redfoxxxi/ET_MASTER_CODE/Vulpra File/vulpra/IMG_4837.jpg

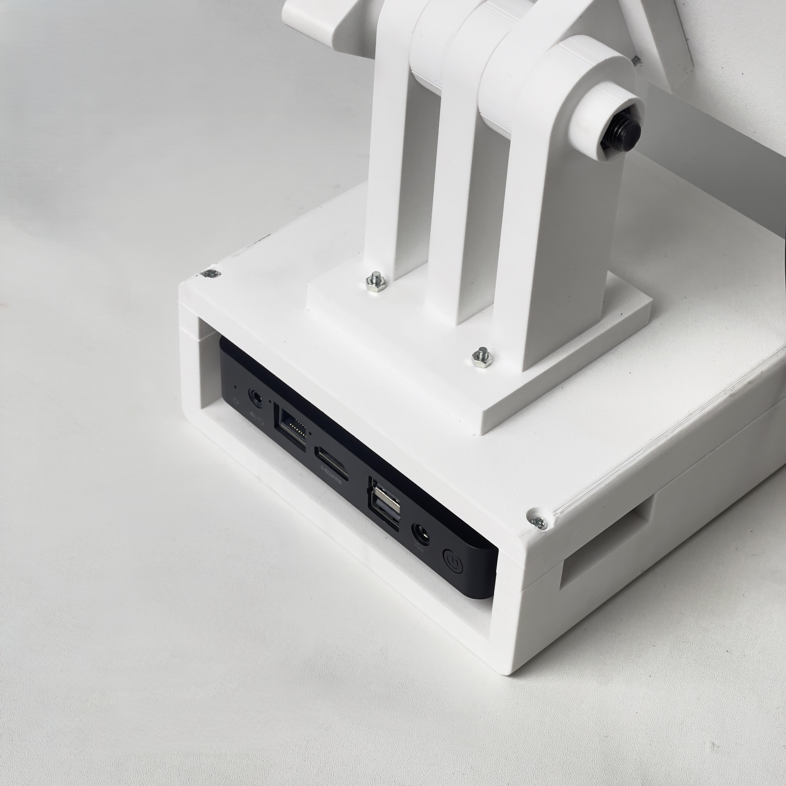
Vulpra File/vulpra/IMG_4837.jpg
