redfoxxxi/ET_MASTER_CODE/Vulpra File/vulpra/IMG_4832.jpg

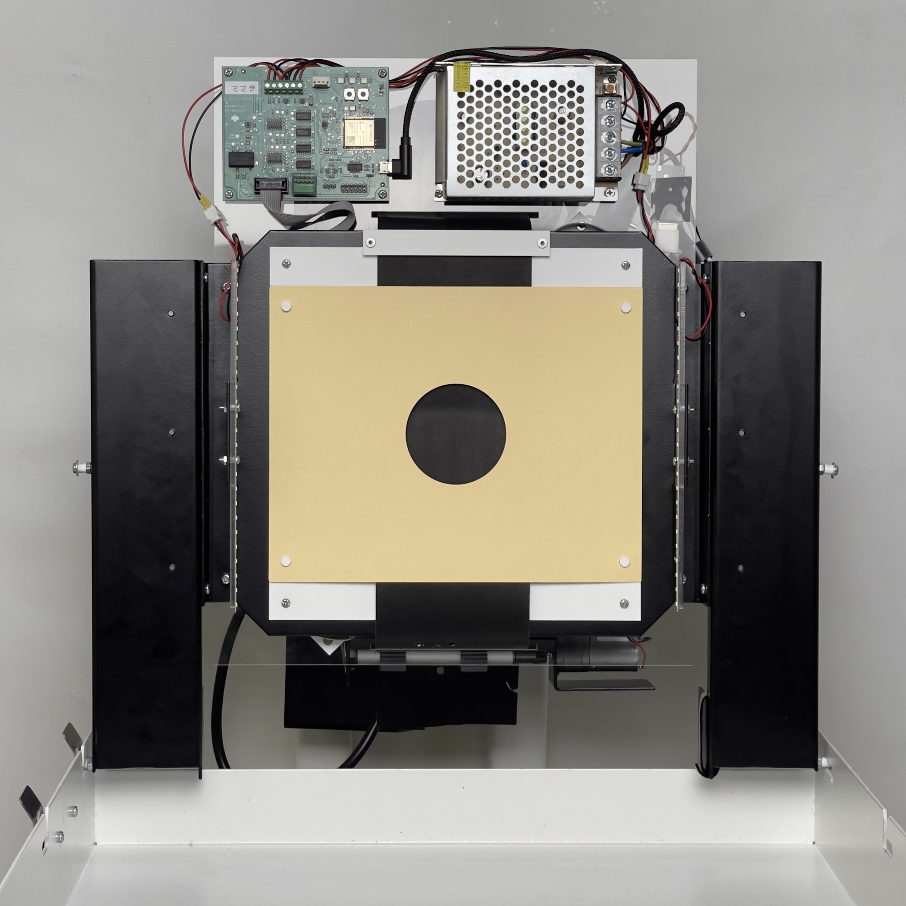
Vulpra File/vulpra/IMG_4832.jpg
