redfoxxxi/ET_MASTER_CODE/README.md

This is the documentation of Vulpra Electronic Target for 10m air pistol and air rifle.
