redfoxxxi/ET_MASTER_CODE/Additional unfinished Project/electronic_target_system_simulation_combined_with_multi_color_heatmap_confined_to_intersecting_grid.html

# Electronic Target System Simulation

Sensors per Side:

Triangle Side Length (cm):

Apply Changes

Targeted Resolution (mm):

Calculate Recommendation

Total Laser Lines:

Total Intersection Points:

Largest Cell Area (Overall Grid): cm²

Smallest Cell Area (Overall Grid): cm²

Largest Grid Tightness (Overall Grid - Max Adj. Dist.): cm

Smallest Grid Tightness (Overall Grid - Min Adj. Dist.): cm

Target Area Grid Tightness (within 9-ring):

Max Distance: mm

Min Distance: mm

Recommended Sensors per Side: N/A

Achievable Resolution (Current Settings, in 9-ring): N/A mm

Select Adjacent Segment (Overall Grid):

✨ Get Accuracy Improvement Suggestions

Generating suggestions...

Suggestions will appear here.

## Grid Resolution Heatmap (by Cell Area)

Color indicates local grid resolution (cell area):

High Resolution (Red) Low Resolution (Blue)
