redfoxxxi/ET_MASTER_CODE/ET MASTER/ET STAND/NOTE TAMBAHAN.txt

Untuk stand, pakai besi hollow saja produksinya. semua bagian dihubungkan dengan cara di Las. (sesuai yang ada di pdf) jika ada pertanyaan, boleh contact saja langsung.

untuk warna dari stand pakai warna PUTIH semua
