redfoxxxi/ET_MASTER_CODE/ENGINEERING PORTFOLIO German.pdf

# Engineering Portfolio

Josiah Christoff Susanto

Elektromechanische Systeme • CAD-Design • Embedded Electronics • Produktentwicklung

Aachen, Deutschland | +49 1512 9710619 | josiahsusanto@gmail.com

Projekt :

10m Elektronisches Zielsystem & 10m Laufscheibenanlage

2023 – 2026


# PROJEKTÜBERSICHT

## 10m Elektronisches Zielsystem

Problemstellung

Traditionelle Zielsysteme sind teuer und lokal schwer erhältlich.

Zielsetzung

Entwicklung eines kommerziell nutzbaren elektronischen Zielsystems für den Schießsport, das kostengünstig ist und lokal verfügbar gemacht werden kann.

Projektumfang

- Mechanische Konstruktion
- Elektronische Integration
- Embedded-System-Entwicklung
- Montageprozess
- Vorbereitung der Fertigung
- Produktstandardisierung

Meine Rolle

Verantwortlichkeiten :

- Systemarchitektur
- Mechanische Konstruktion
- Elektronische Integration
- Logikdesign
- Montage
- Testung
- Dokumentation
- Budgetplanung
- Kundenkommunikation

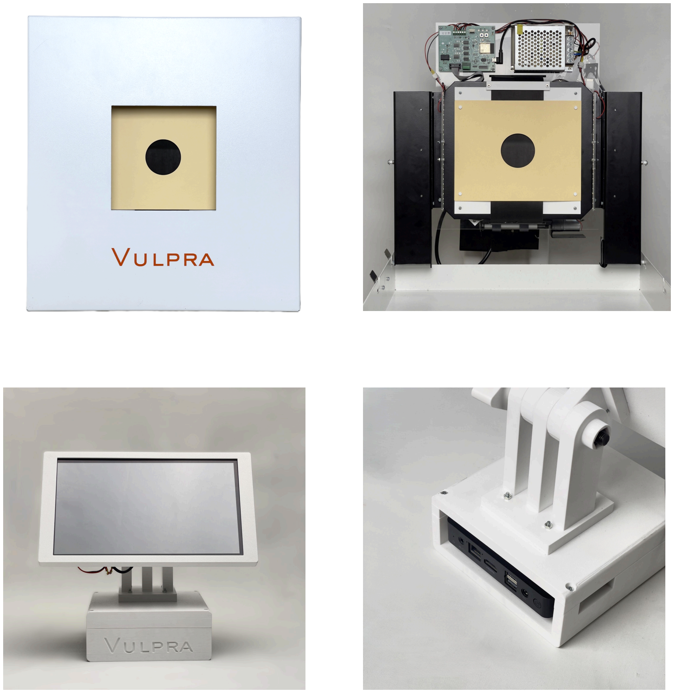
[picture p12: page 3]

# CAD DESIGN

## Mechanische Konstruktion

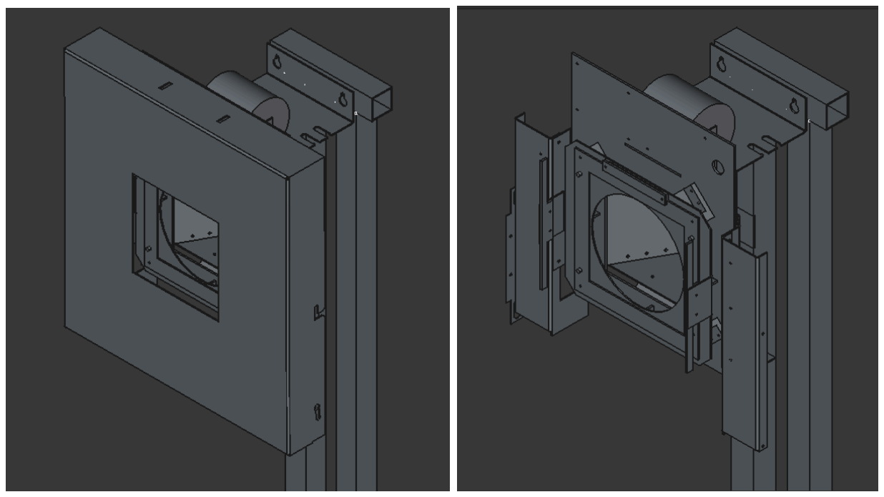
[picture p13: figure]

Überblick über das vollständige mechanische Design


Überblick über die von mir entwickelten Komponenten

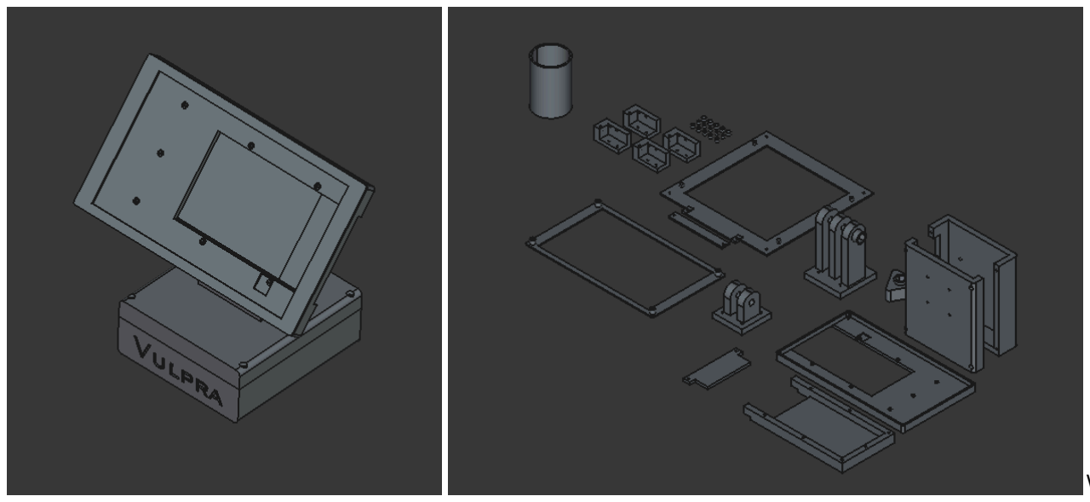
[picture p14: figure]

\

Ü

b

e

r

blic

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
timie

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
dlic

h

k

eit

## Entwicklungsprozess

Herausforderung

Entwicklung eines zuverlässigen Zielsystems mit effizientem mechanischem Design.

Entwicklung

Version 1


Problem: Das Design war zu komplex und nicht effizient genug. Dadurch waren Gewicht und Anzahl der Bauteile höher, und die Montage war schwieriger.

Version 2 (Finales Produkt)


Durch gezielte Verbesserungen und effizienteres Design konnte ich die Anzahl der Bauteile und das Gewicht reduzieren sowie die Montage vereinfachen, ohne die Funktionalität zu beeinträchtigen.

# Fertigung & Dokumentation

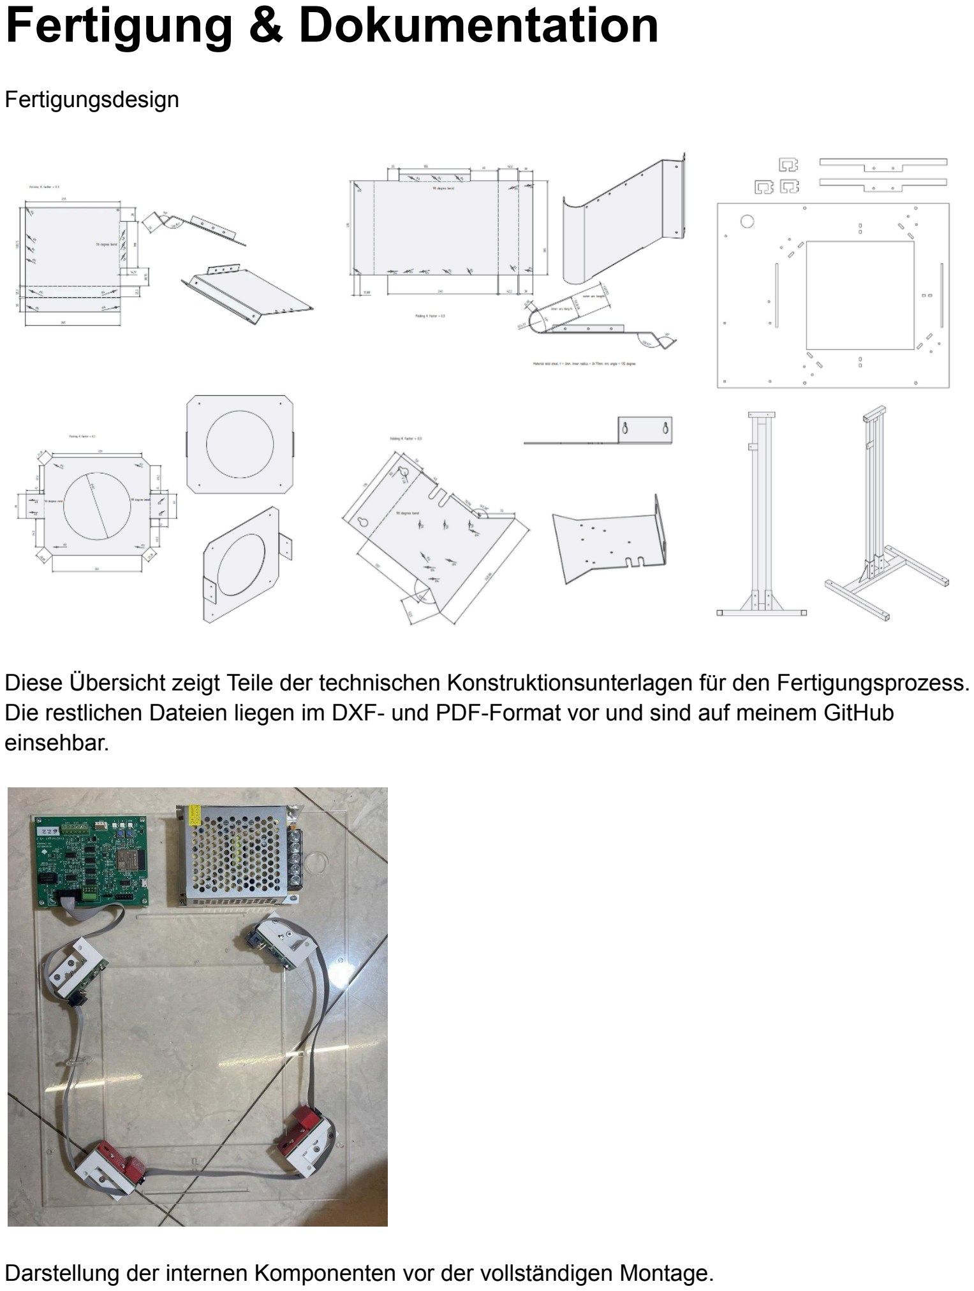
[picture p15: page 7]

Fertigungsdesign

Diese Übersicht zeigt Teile der technischen Konstruktionsunterlagen für den Fertigungsprozess. Die restlichen Dateien liegen im DXF- und PDF-Format vor und sind auf meinem GitHub einsehbar.

Darstellung der internen Komponenten vor der vollständigen Montage.

## 10m Laufscheibenanlage

Die Projektdokumentation finden Sie unter diesem Google Drive Link : Running target portfolio (https://drive.google.com/drive/folders/1omEWJYa4WoZRgBuMUYweKJWNJG2Rp4BL?usp=sharing)

## Danksagung

Für weitere Informationen, CAD-Dateien und technische Dokumentation:

Email: josiahsusanto@gmail.com

Telefon: +49 1512 9710619

Portfolio Repository: https://github.com/redfoxxxi/ET_MASTER_CODE
