redfoxxxi/ET_MASTER_CODE/ET MASTER/Metal Body V2/Part Design/metal body-Assembly.step

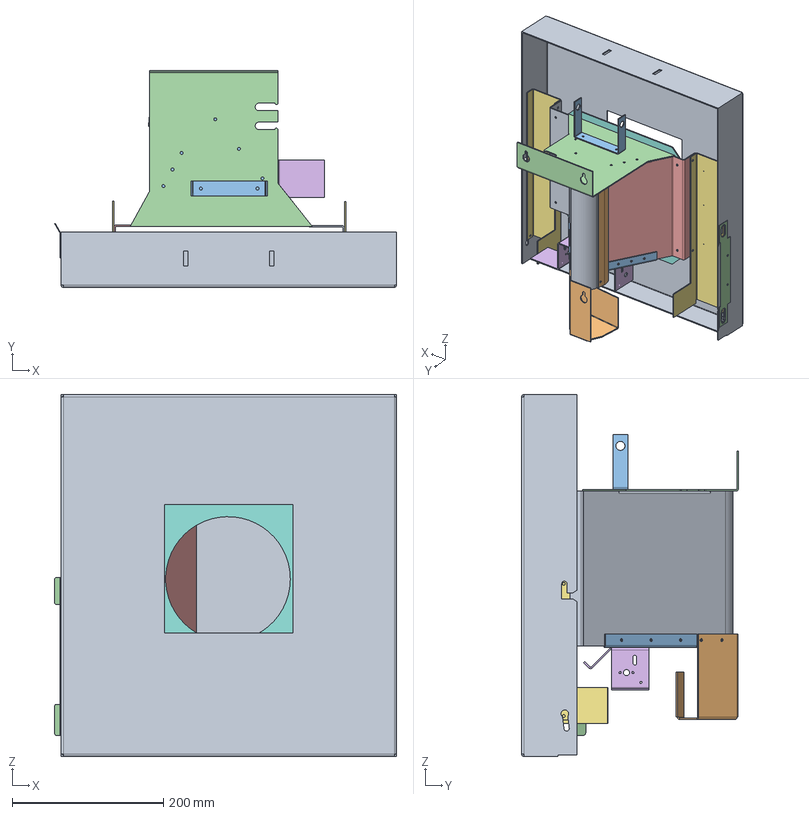
[picture p16: CAD file, 2026-06-16]
ET MASTER/Metal Body V2/Part Design/metal body-Assembly.step
452.6 x 286.8 x 479.0 mm
FRONT PLATE
COLLECTOR
TRAP FOUNDATION
UPPER TRAP
SIDE PLATE A
MOTOR MOUNT
PLATE HOLDER001
PROTECTOR PLATE
SIDE PLATE B
SIDE B CURL
Roll Holder
PLATE HOLDER (Mirror #1)
PLATE CLAMP
