redfoxxxi/ET_MASTER_CODE/ET MASTER/Airsoft design/Airsoft Metal Frame.FCStd

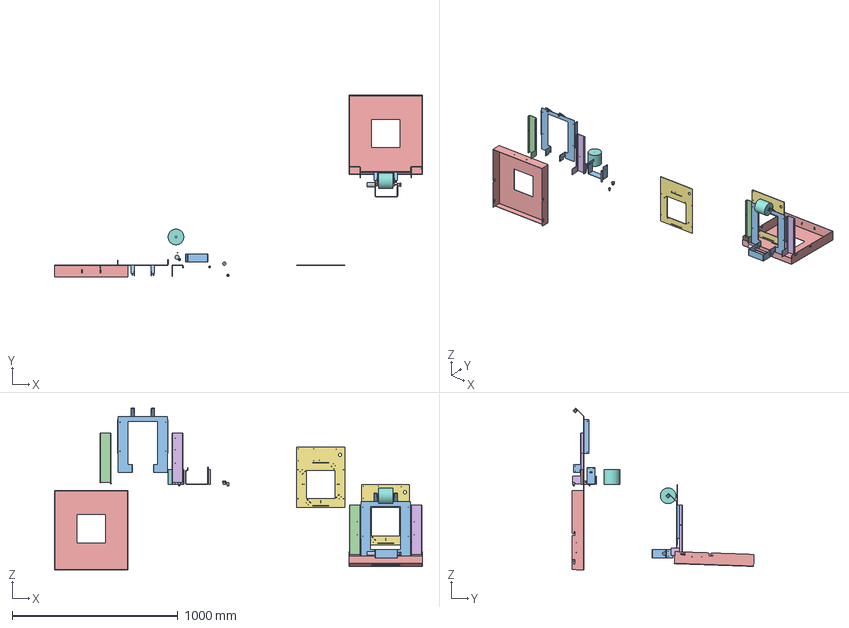
[picture p18: CAD file, 2026-06-16]
ET MASTER/Airsoft design/Airsoft Metal Frame.FCStd
2220.7 x 1099.4 x 976.7 mm
roll spring knob x 2
Support Roll Adapter x 2
Back Plate x 2
PLATE HOLDER001 x 2
FRONT PLATE002 x 2
PLATE HOLDER (Mirror #1) x 2
MAIN FRAME x 2
Paper roll x 2
Motor sim object x 2
Main Roll Adapter x 2
Motor Roll Mounting Plate x 2
m4 screw x 2
Roll Adapter x 2
