redfoxxxi/ET_MASTER_CODE/ET MASTER/ET ACRYLIC BODY v2/acrylic body.FCStd

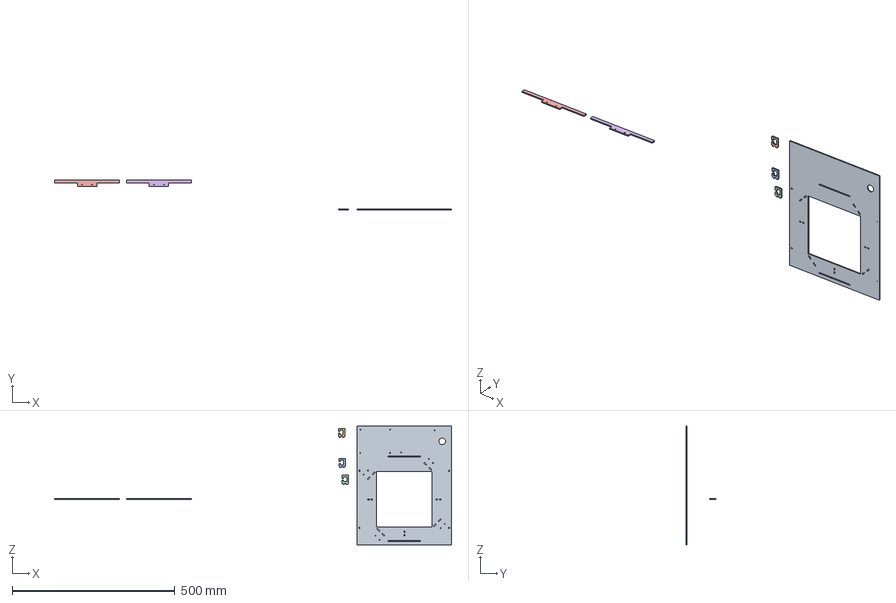
[picture p19: CAD file, 2026-06-16]
ET MASTER/ET ACRYLIC BODY v2/acrylic body.FCStd
1218.8 x 93.0 x 365.0 mm
MAIN FRAME
CABLE HOLDER 1
CABLE HOLDER 002
CABLE HOLDER 003
LED MOUNT 2
LED MOUNT
