redfoxxxi/ET_MASTER_CODE/ET MASTER/ET ACRYLIC BODY v2/laser cut file/acrylic body.dxf

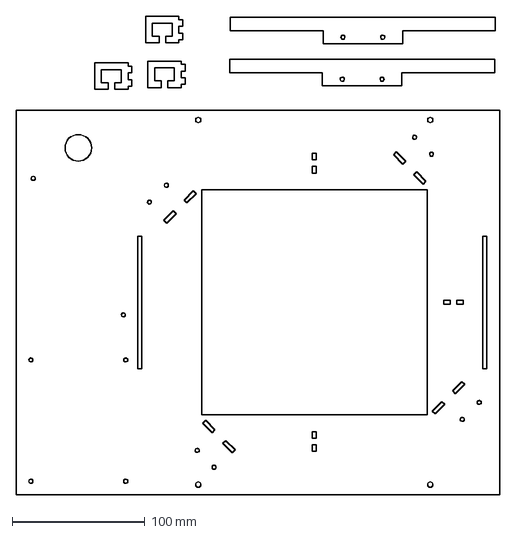
[picture p20: CAD file, 2026-06-16]
ET MASTER/ET ACRYLIC BODY v2/laser cut file/acrylic body.dxf
365.0 x 360.6 mm
