redfoxxxi/ET_MASTER_CODE/ET MASTER/ET MASTER/ET Master Design.FCStd

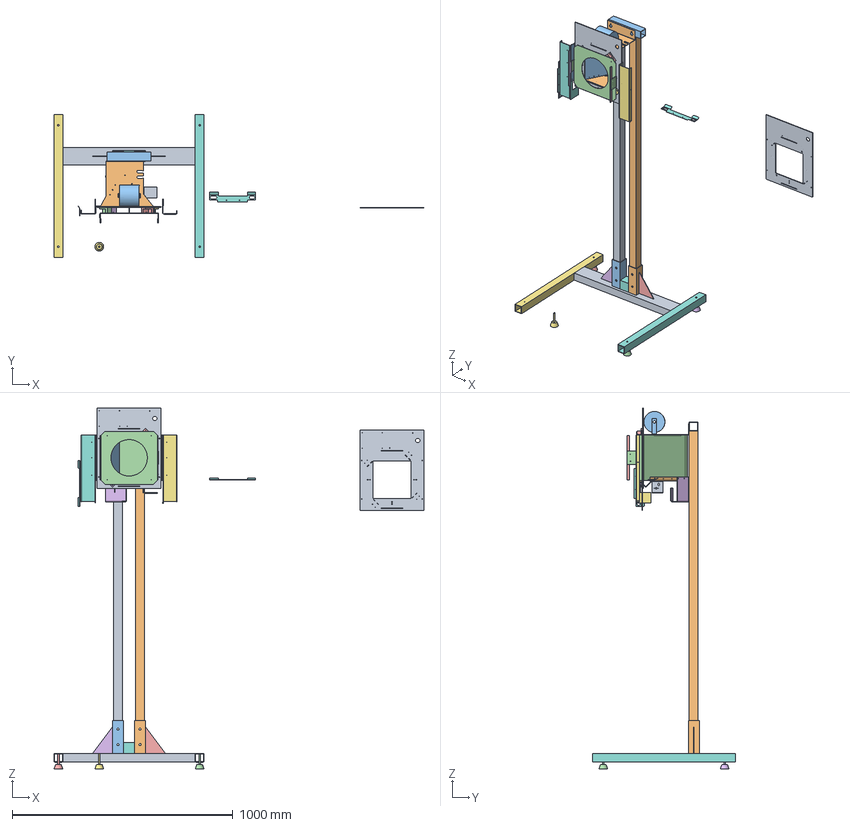
[picture p21: CAD file, 2026-06-16]
ET MASTER/ET MASTER/ET Master Design.FCStd
1676.8 x 650.1 x 1634.6 mm
MAIN FRAME x 2
TRAP FOUNDATION
SIDE PLATE A
SIDE PLATE B
SIDE B CURL
COLLECTOR
PLATE HOLDER001
PLATE HOLDER (Mirror #1)
MOTOR MOUNT
UPPER TRAP
Roll Holder
Sensor mount
Sensor mount002
Sensor mount003
Sensor mount004
CABLE HOLDER 1
CABLE HOLDER 003
CABLE HOLDER 002
Paper roll
PROTECTOR PLATE
LED MOUNT 2
LED MOUNT
sub leg
sub leg001
main leg
leg foundation
leg foundation 1
lower support
Support
Support 001
upper support
spacer
stand 1
stand 2
upper holder
rubber stand002
rubber stand003
rubber stand004
rubber stand
PLATE CLAMP x 2
