redfoxxxi/ET_MASTER_CODE/ET MASTER/ET MONITOR/ET MONITOR.step

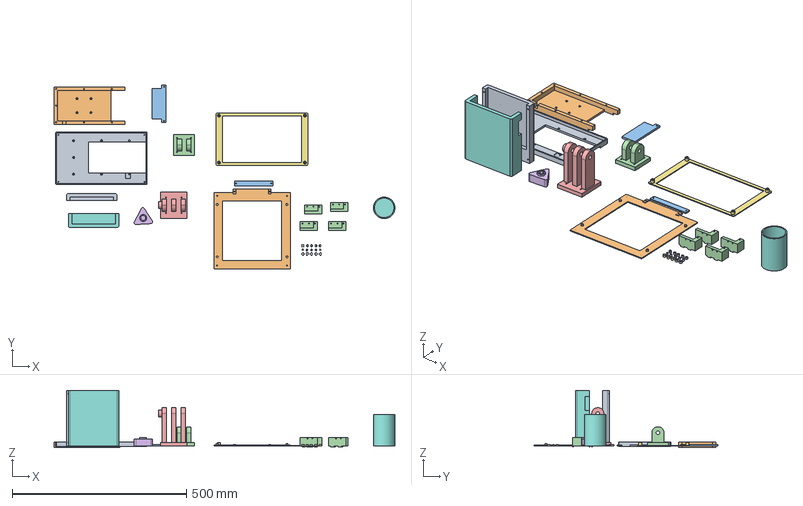
[picture p22: CAD file, 2026-06-16]
ET MASTER/ET MONITOR/ET MONITOR.step
979.1 x 528.2 x 165.0 mm
Upper foundation
Paper holder
PAPER CAP
Sensor mount
Sensor mount002
Sensor mount003
Sensor mount004
plate mount pulley
m3 pulley
m6 pulley
Bottom Foundation
BASE
monitor cap
conection cap
monitor joint
stand joint
clamp joint
screen cap
plate mount pulley001
plate mount pulley002
plate mount pulley003
plate mount pulley004
m3 pulley001
m3 pulley002
m3 pulley003
m3 pulley004
m6 pulley001
m6 pulley002
m6 pulley003
m6 pulley004
