redfoxxxi/ET_MASTER_CODE/ET MASTER/ET STAND/ET STAND.FCStd

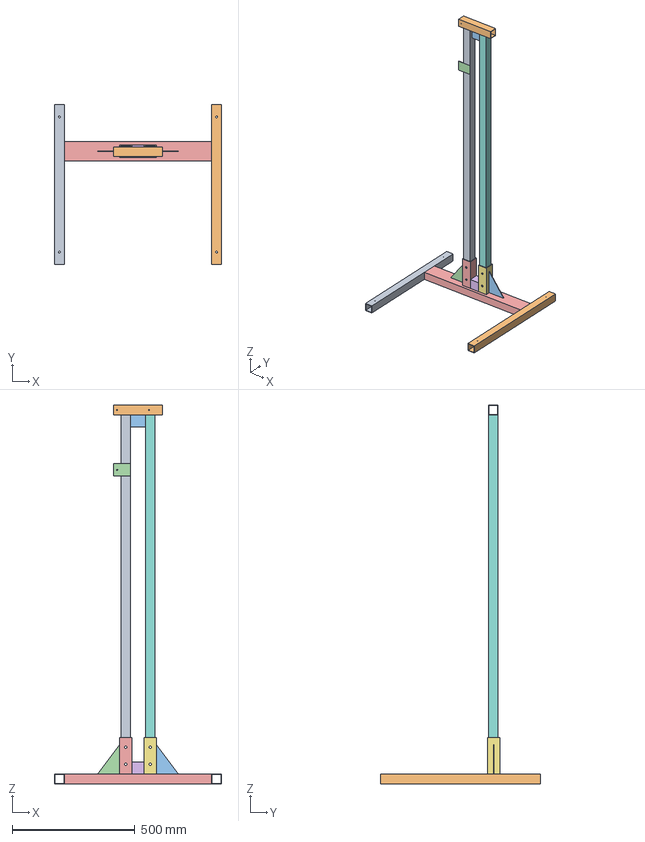
[picture p23: CAD file, 2026-06-16]
ET MASTER/ET STAND/ET STAND.FCStd
680.0 x 650.0 x 1542.0 mm
sub leg 1
sub leg 2
Support 1
Support 2
leg foundation 1
spacer
leg foundation 2
stand 2
stand 1
upper holder
upper support
lower support
main leg
