redfoxxxi/ET_MASTER_CODE/ET MASTER/Metal Body V2/Part Design/COLLECTOR/colector.dxf

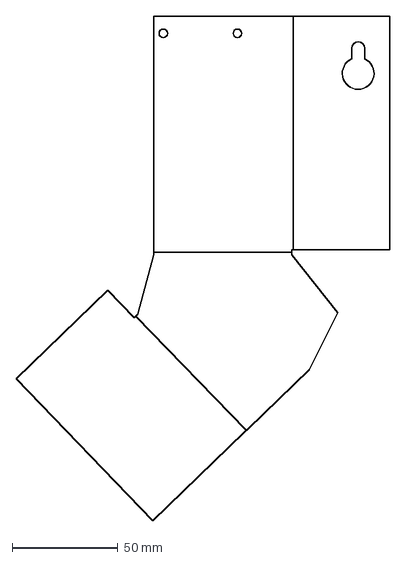
[picture p24: CAD file, 2026-06-16]
ET MASTER/Metal Body V2/Part Design/COLLECTOR/colector.dxf
176.4 x 237.9 mm
