redfoxxxi/ET_MASTER_CODE/ET MASTER/Metal Body V2/Part Design/FRONT PLATE/front plate.dxf

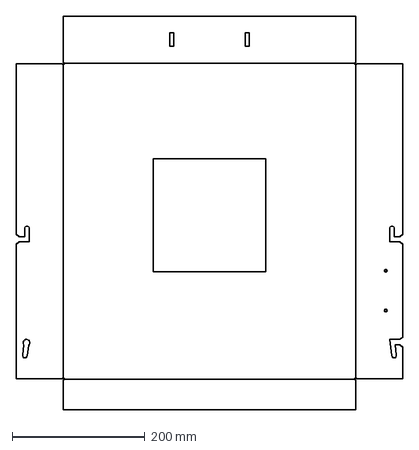
[picture p25: CAD file, 2026-06-16]
ET MASTER/Metal Body V2/Part Design/FRONT PLATE/front plate.dxf
583.0 x 593.0 mm
