redfoxxxi/ET_MASTER_CODE/ET MASTER/Metal Body V2/Part Design/MOTOR MOUNT/motor mount.dxf

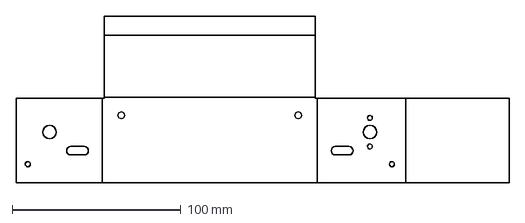
[picture p26: CAD file, 2026-06-16]
ET MASTER/Metal Body V2/Part Design/MOTOR MOUNT/motor mount.dxf
292.5 x 98.8 mm
