redfoxxxi/ET_MASTER_CODE/ET MASTER/Metal Body V2/Part Design/PLATE CLAMP/plate clamp.dxf

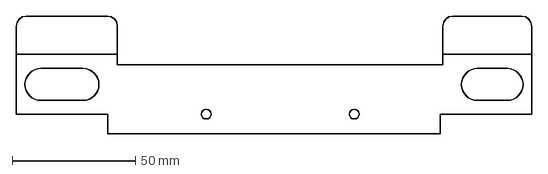
[picture p27: CAD file, 2026-06-16]
ET MASTER/Metal Body V2/Part Design/PLATE CLAMP/plate clamp.dxf
209.0 x 47.7 mm
