redfoxxxi/ET_MASTER_CODE/ET MASTER/Metal Body V2/Part Design/PLATE HOLDER (Mirror)/plate holder (mirror).dxf

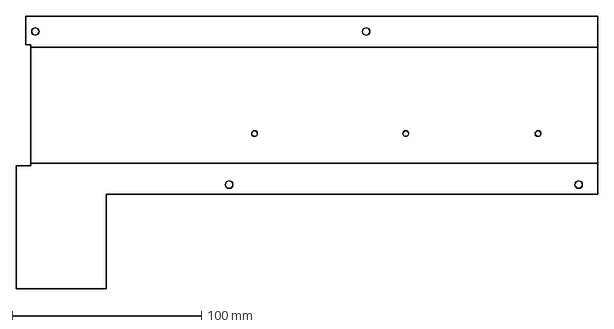
[picture p28: CAD file, 2026-06-16]
ET MASTER/Metal Body V2/Part Design/PLATE HOLDER (Mirror)/plate holder (mirror).dxf
307.5 x 144.0 mm
