redfoxxxi/ET_MASTER_CODE/ET MASTER/Metal Body V2/Part Design/PLATE HOLDER/plate holder.dxf

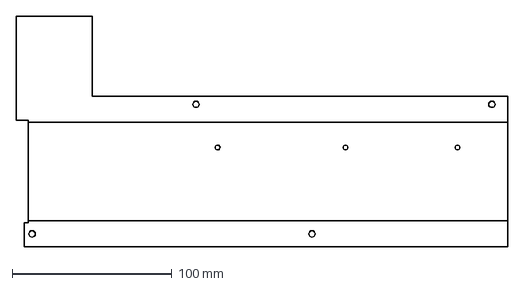
[picture p29: CAD file, 2026-06-16]
ET MASTER/Metal Body V2/Part Design/PLATE HOLDER/plate holder.dxf
307.5 x 144.0 mm
