redfoxxxi/ET_MASTER_CODE/ET MASTER/Metal Body V2/Part Design/PROTECTOR PLATE/protector plate.dxf

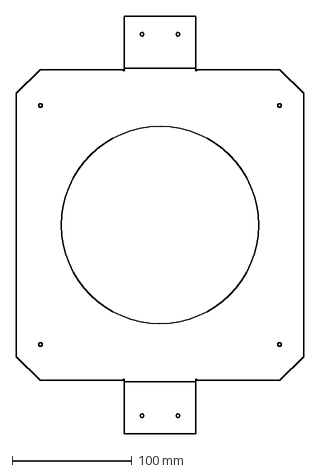
[picture p30: CAD file, 2026-06-16]
ET MASTER/Metal Body V2/Part Design/PROTECTOR PLATE/protector plate.dxf
240.0 x 349.0 mm
