redfoxxxi/ET_MASTER_CODE/ET MASTER/Metal Body V2/Part Design/ROLL HOLDER/roll holder.dxf

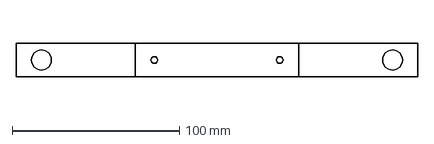
[picture p31: CAD file, 2026-06-16]
ET MASTER/Metal Body V2/Part Design/ROLL HOLDER/roll holder.dxf
240.0 x 20.0 mm
