redfoxxxi/ET_MASTER_CODE/ET MASTER/Metal Body V2/Part Design/SIDE B CURL/side b curl.dxf

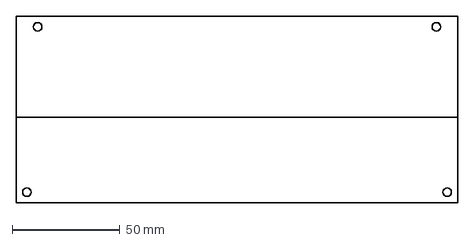
[picture p32: CAD file, 2026-06-16]
ET MASTER/Metal Body V2/Part Design/SIDE B CURL/side b curl.dxf
205.0 x 86.6 mm
