redfoxxxi/ET_MASTER_CODE/ET MASTER/Metal Body V2/Part Design/SIDE PLATE A/side plate a.dxf

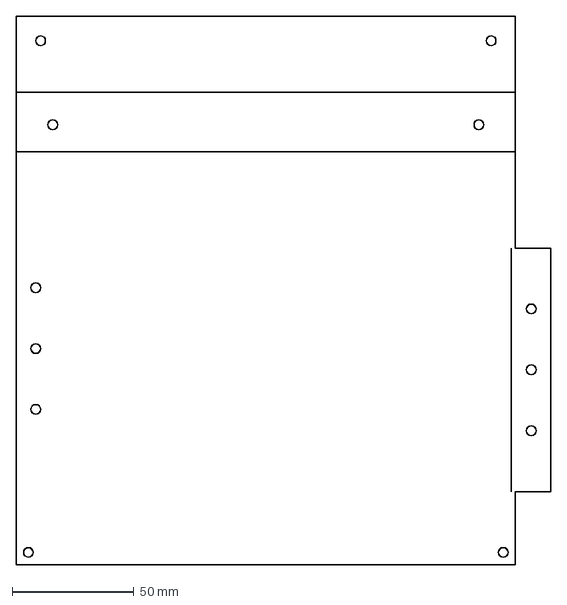
[picture p33: CAD file, 2026-06-16]
ET MASTER/Metal Body V2/Part Design/SIDE PLATE A/side plate a.dxf
219.5 x 225.2 mm
