redfoxxxi/ET_MASTER_CODE/ET MASTER/Metal Body V2/Part Design/SIDE PLATE B/side plate b.dxf

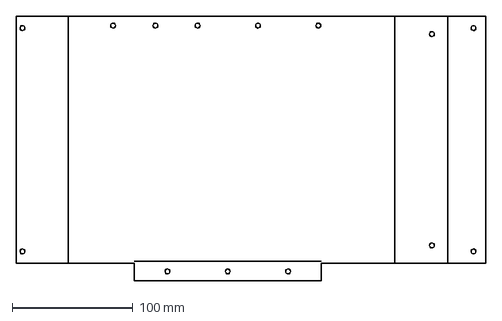
[picture p34: CAD file, 2026-06-16]
ET MASTER/Metal Body V2/Part Design/SIDE PLATE B/side plate b.dxf
388.8 x 219.5 mm
