redfoxxxi/ET_MASTER_CODE/ET MASTER/Metal Body V2/Part Design/TRAP FOUNDATION/trap foundation.dxf

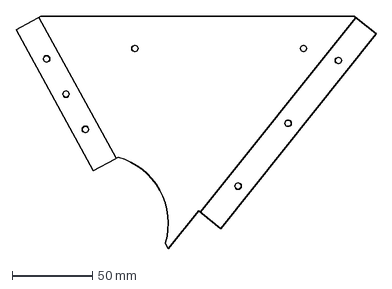
[picture p35: CAD file, 2026-06-16]
ET MASTER/Metal Body V2/Part Design/TRAP FOUNDATION/trap foundation.dxf
224.0 x 144.6 mm
