redfoxxxi/ET_MASTER_CODE/ET MASTER/Metal Body V2/Part Design/UPPER TRAP/upper trap.dxf

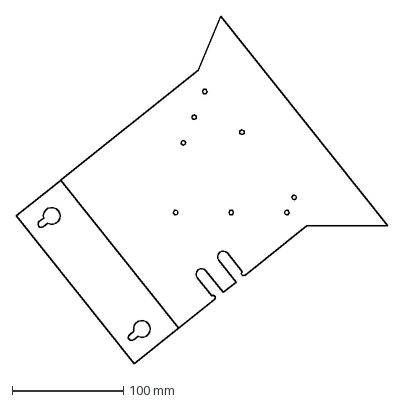
[picture p36: CAD file, 2026-06-16]
ET MASTER/Metal Body V2/Part Design/UPPER TRAP/upper trap.dxf
334.2 x 312.1 mm
