redfoxxxi/ET_MASTER_CODE/ET MASTER/Airsoft design/Airsoft 3d printed part.FCStd

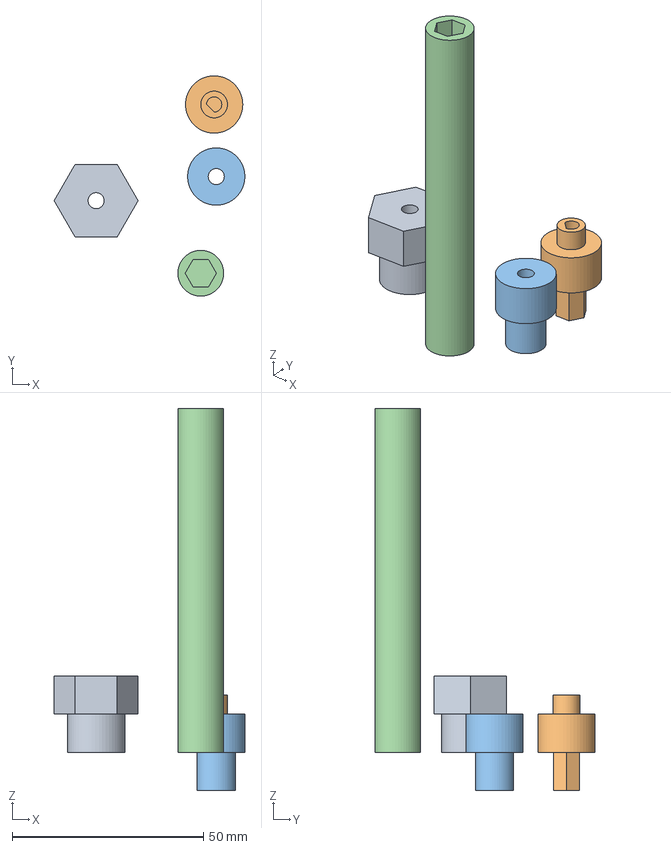
[picture p37: CAD file, 2026-06-16]
ET MASTER/Airsoft design/Airsoft 3d printed part.FCStd
49.9 x 57.7 x 100.0 mm
roll spring knob
Main Roll Adapter
Support Roll Adapter
Roll Adapter
