redfoxxxi/ET_MASTER_CODE/ET MASTER/ET MONITOR/paper holder.step

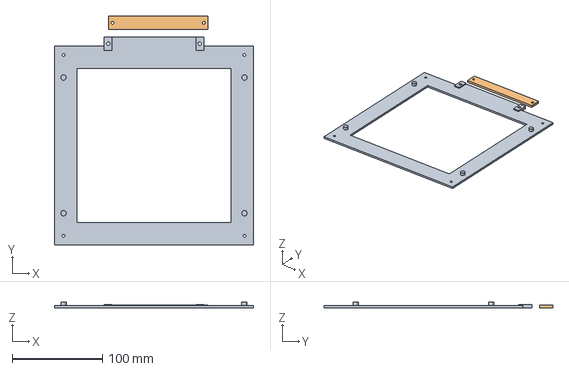
[picture p38: CAD file, 2026-06-16]
ET MASTER/ET MONITOR/paper holder.step
220.0 x 253.0 x 6.50 mm
Paper holder
PAPER CAP
