redfoxxxi/ET_MASTER_CODE/(list of files, cad)

Other CAD files:
ET MASTER/Metal Body V2/metal body.FCStd
ET MASTER/ET MONITOR/ET MONITOR.FCStd
ET MASTER/Metal Body V2/Part Design/COLLECTOR/colector.dwg
ET MASTER/Metal Body V2/Part Design/FRONT PLATE/front plate.dwg
ET MASTER/Metal Body V2/Part Design/MOTOR MOUNT/motor mount.dwg
ET MASTER/Metal Body V2/Part Design/PLATE CLAMP/plate clamp.dwg
ET MASTER/Metal Body V2/Part Design/PLATE HOLDER (Mirror)/plate holder (mirror).dwg
ET MASTER/Metal Body V2/Part Design/PLATE HOLDER/plate holder.dwg
ET MASTER/Metal Body V2/Part Design/PROTECTOR PLATE/protector plate.dwg
ET MASTER/Metal Body V2/Part Design/ROLL HOLDER/roll holder.dwg
ET MASTER/Metal Body V2/Part Design/SIDE B CURL/side b curl.dwg
ET MASTER/Metal Body V2/Part Design/SIDE PLATE A/side plate a.dwg
ET MASTER/Metal Body V2/Part Design/SIDE PLATE B/side plate b.dwg
ET MASTER/Metal Body V2/Part Design/TRAP FOUNDATION/trap foundation.dwg
ET MASTER/Metal Body V2/Part Design/UPPER TRAP/upper trap.dwg
ET MASTER/Previous Version/Previous version/ET Acrylic Body/ET ACRYLIC BODY.FCStd
ET MASTER/Previous Version/Previous version/ET Acrylic Body/laser cut file/ET ACRYLIC BODY.dxf
ET MASTER/Previous Version/Previous version/ET METAL BODY/ET METAL BODY rev.step
ET MASTER/Previous Version/Previous version/ET METAL BODY/ET METAL BODY.FCStd
ET MASTER/Previous Version/Previous version/ET METAL BODY/METAL UNFOLD.FCStd
ET MASTER/Previous Version/Previous version/ET METAL BODY/Parts design/COLLECTOR/COLLECTOR.dwg
ET MASTER/Previous Version/Previous version/ET METAL BODY/Parts design/COLLECTOR/COLLECTOR.dxf
ET MASTER/Previous Version/Previous version/ET METAL BODY/Parts design/Front plate/Front Plate.dwg
ET MASTER/Previous Version/Previous version/ET METAL BODY/Parts design/Front plate/Front Plate.dxf
ET MASTER/Previous Version/Previous version/ET METAL BODY/Parts design/LED STAND 1/LED STAND 1.dwg
ET MASTER/Previous Version/Previous version/ET METAL BODY/Parts design/LED STAND 1/LED STAND 1.dxf
ET MASTER/Previous Version/Previous version/ET METAL BODY/Parts design/LED STAND/LED STAND.dwg
ET MASTER/Previous Version/Previous version/ET METAL BODY/Parts design/LED STAND/LED STAND.dxf
ET MASTER/Previous Version/Previous version/ET METAL BODY/Parts design/PLATE HOLDER (Mirror)/PLATE HOLDER (mirror).dwg
ET MASTER/Previous Version/Previous version/ET METAL BODY/Parts design/PLATE HOLDER (Mirror)/PLATE HOLDER (mirror).dxf
ET MASTER/Previous Version/Previous version/ET METAL BODY/Parts design/PLATE HOLDER/PLATE HOLDER.dwg
ET MASTER/Previous Version/Previous version/ET METAL BODY/Parts design/PLATE HOLDER/PLATE HOLDER.dxf
ET MASTER/Previous Version/Previous version/ET METAL BODY/Parts design/PROTECTOR PLATE/PROTECTOR PLATE.dwg
ET MASTER/Previous Version/Previous version/ET METAL BODY/Parts design/PROTECTOR PLATE/PROTECTOR PLATE.dxf
ET MASTER/Previous Version/Previous version/ET METAL BODY/Parts design/SIDE B CURL/SIDE B CURL.dwg
ET MASTER/Previous Version/Previous version/ET METAL BODY/Parts design/SIDE B CURL/SIDE B CURL.dxf
ET MASTER/Previous Version/Previous version/ET METAL BODY/Parts design/SIDE PLATE A/SIDE PLATE A.dwg
ET MASTER/Previous Version/Previous version/ET METAL BODY/Parts design/SIDE PLATE A/SIDE PLATE A.dxf
ET MASTER/Previous Version/Previous version/ET METAL BODY/Parts design/SIDE PLATE B/SIDE PLATE B.dwg
ET MASTER/Previous Version/Previous version/ET METAL BODY/Parts design/SIDE PLATE B/SIDE PLATE B.dxf
ET MASTER/Previous Version/Previous version/ET METAL BODY/Parts design/TRAP FOUNDATION/TRAP FOUNDATION.dwg
ET MASTER/Previous Version/Previous version/ET METAL BODY/Parts design/TRAP FOUNDATION/TRAP FOUNDATION.dxf
ET MASTER/Previous Version/Previous version/ET METAL BODY/Parts design/UPPER TRAP/UPPER TRAP.dxf
