redfoxxxi/ET_MASTER_CODE/ET MASTER/ET STAND/Sketch/ET STAND-assembly tech 1.pdf

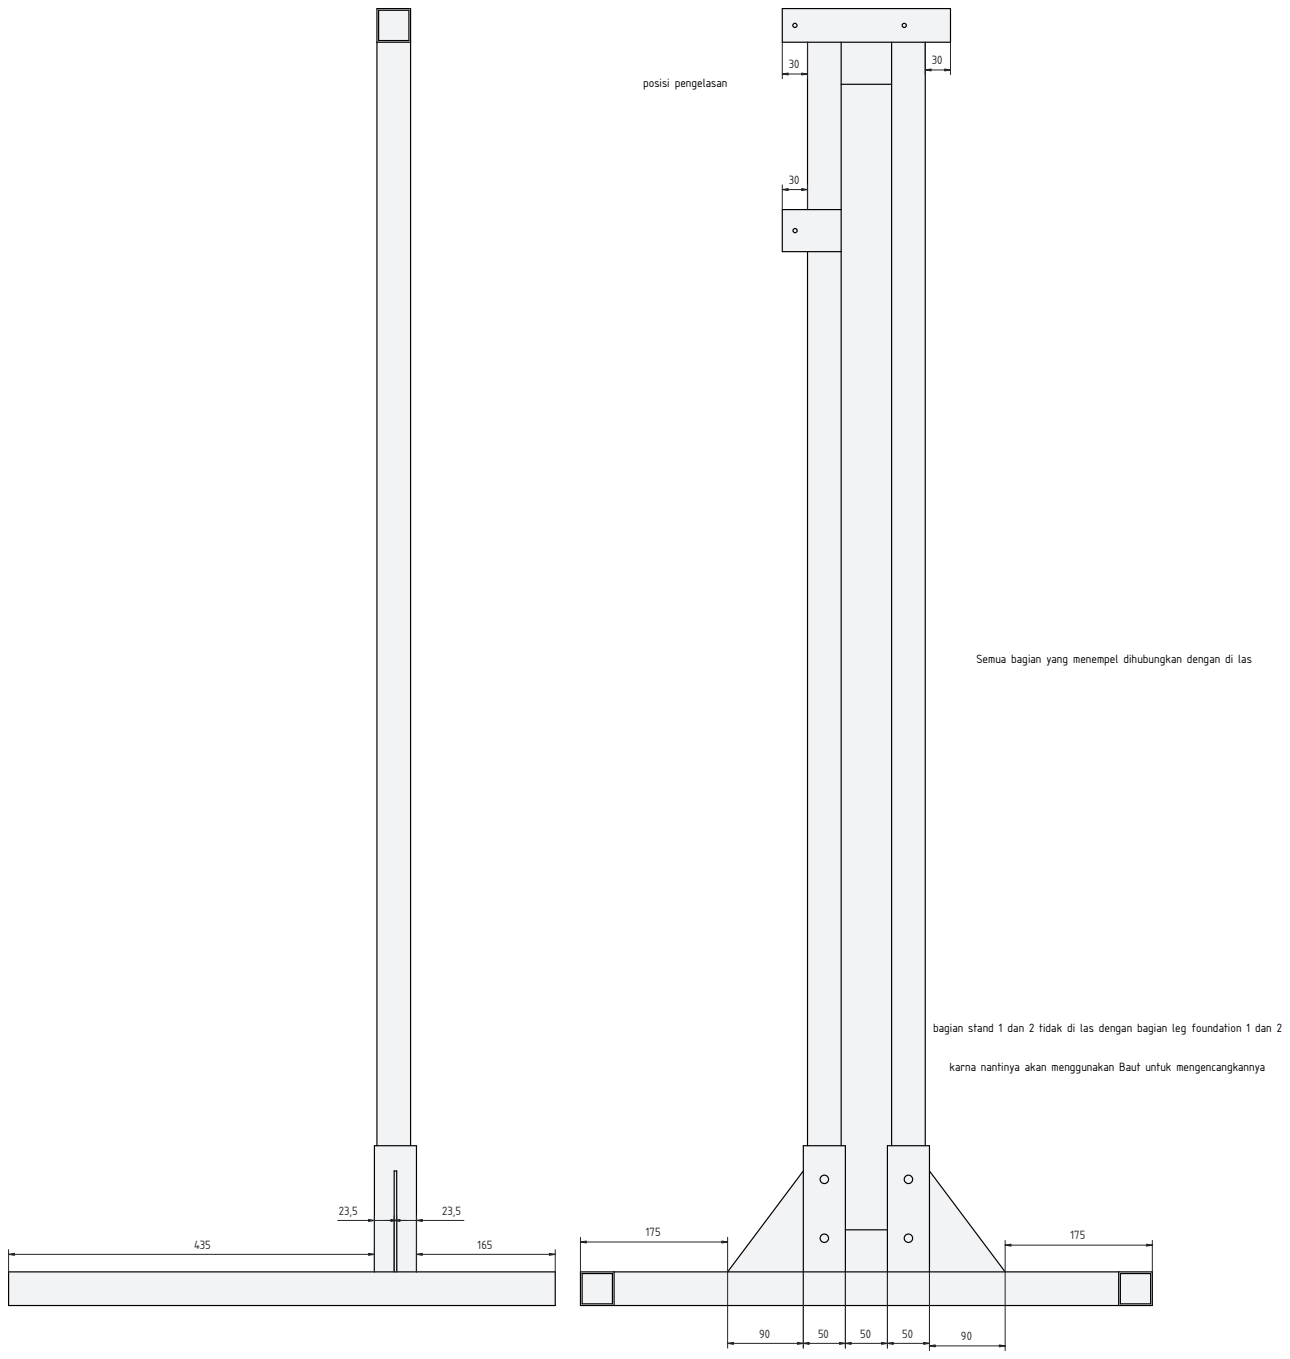
[picture p39: page 1]
posisi pengelasan

Semua bagian yang menempel dihubungkan dengan di las

bagian stand 1 dan 2 tidak di las dengan bagian leg foundation 1 dan 2

karna nantinya akan menggunakan Baut untuk mengencangkannya
