redfoxxxi/ET_MASTER_CODE/ET MASTER/Metal Body V2/Part Design/PLATE CLAMP/metal body-plate clamp tech.pdf

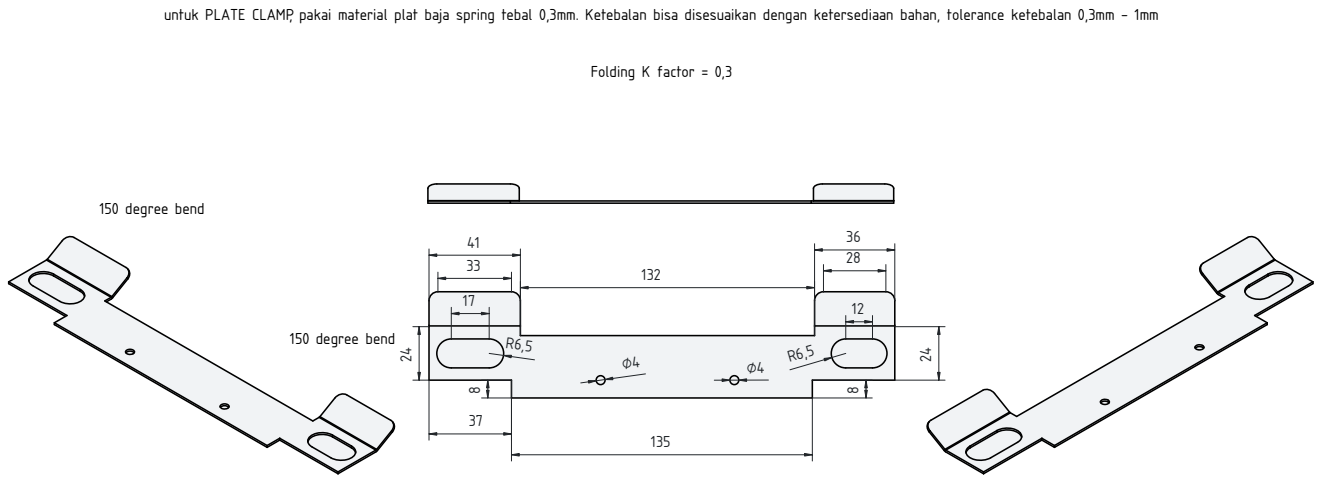
[picture p40: page 1]
Folding K factor = 0,3; 150 degree bend

untuk PLATE CLAMP, pakai material plat baja spring tebal 0,3mm. Ketebalan bisa disesuaikan dengan ketersediaan bahan, tolerance ketebalan 0,3mm - 1mm
