redfoxxxi/ET_MASTER_CODE/ET MASTER/Metal Body V2/Part Design/SIDE B CURL/metal body-side b curl tech.pdf

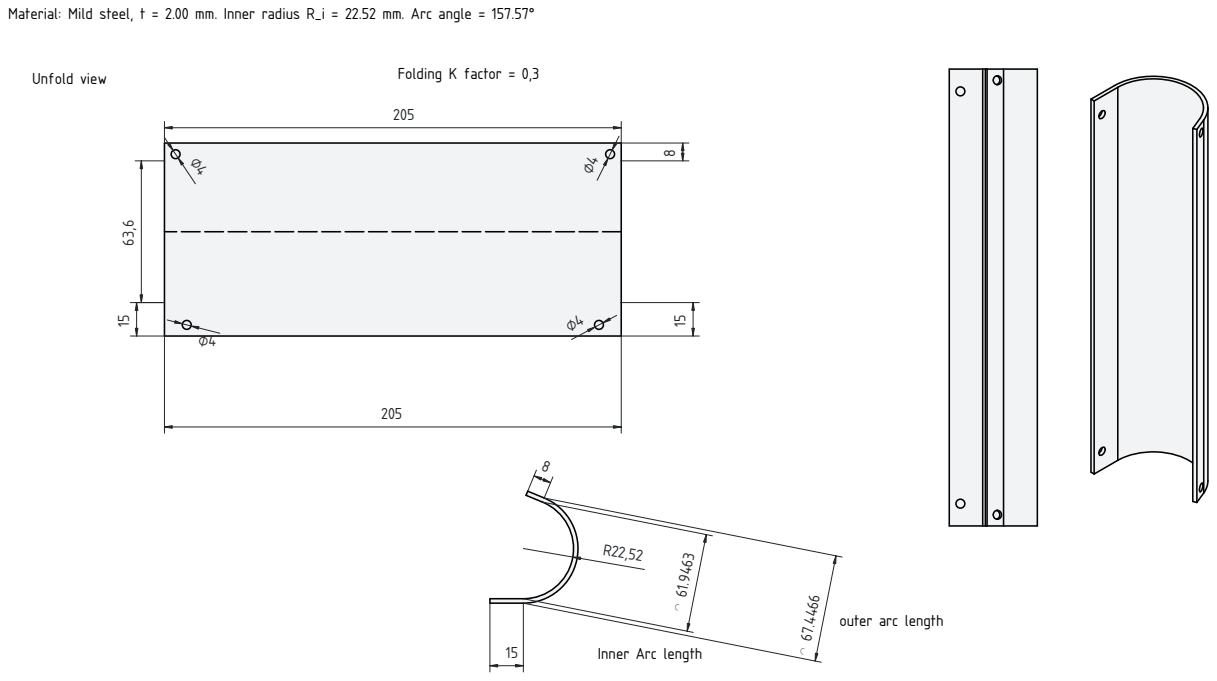
[picture p41: page 1]
Folding K factor = 0,3; Unfold view

Material: Mild steel, t = 2.00 mm. Inner radius R_i = 22.52 mm. Arc angle = 157.57°

outer arc length

Inner Arc length
