redfoxxxi/ET_MASTER_CODE/ET MASTER/Metal Body V2/Part Design/SIDE PLATE B/metal body-side plate b tech.pdf

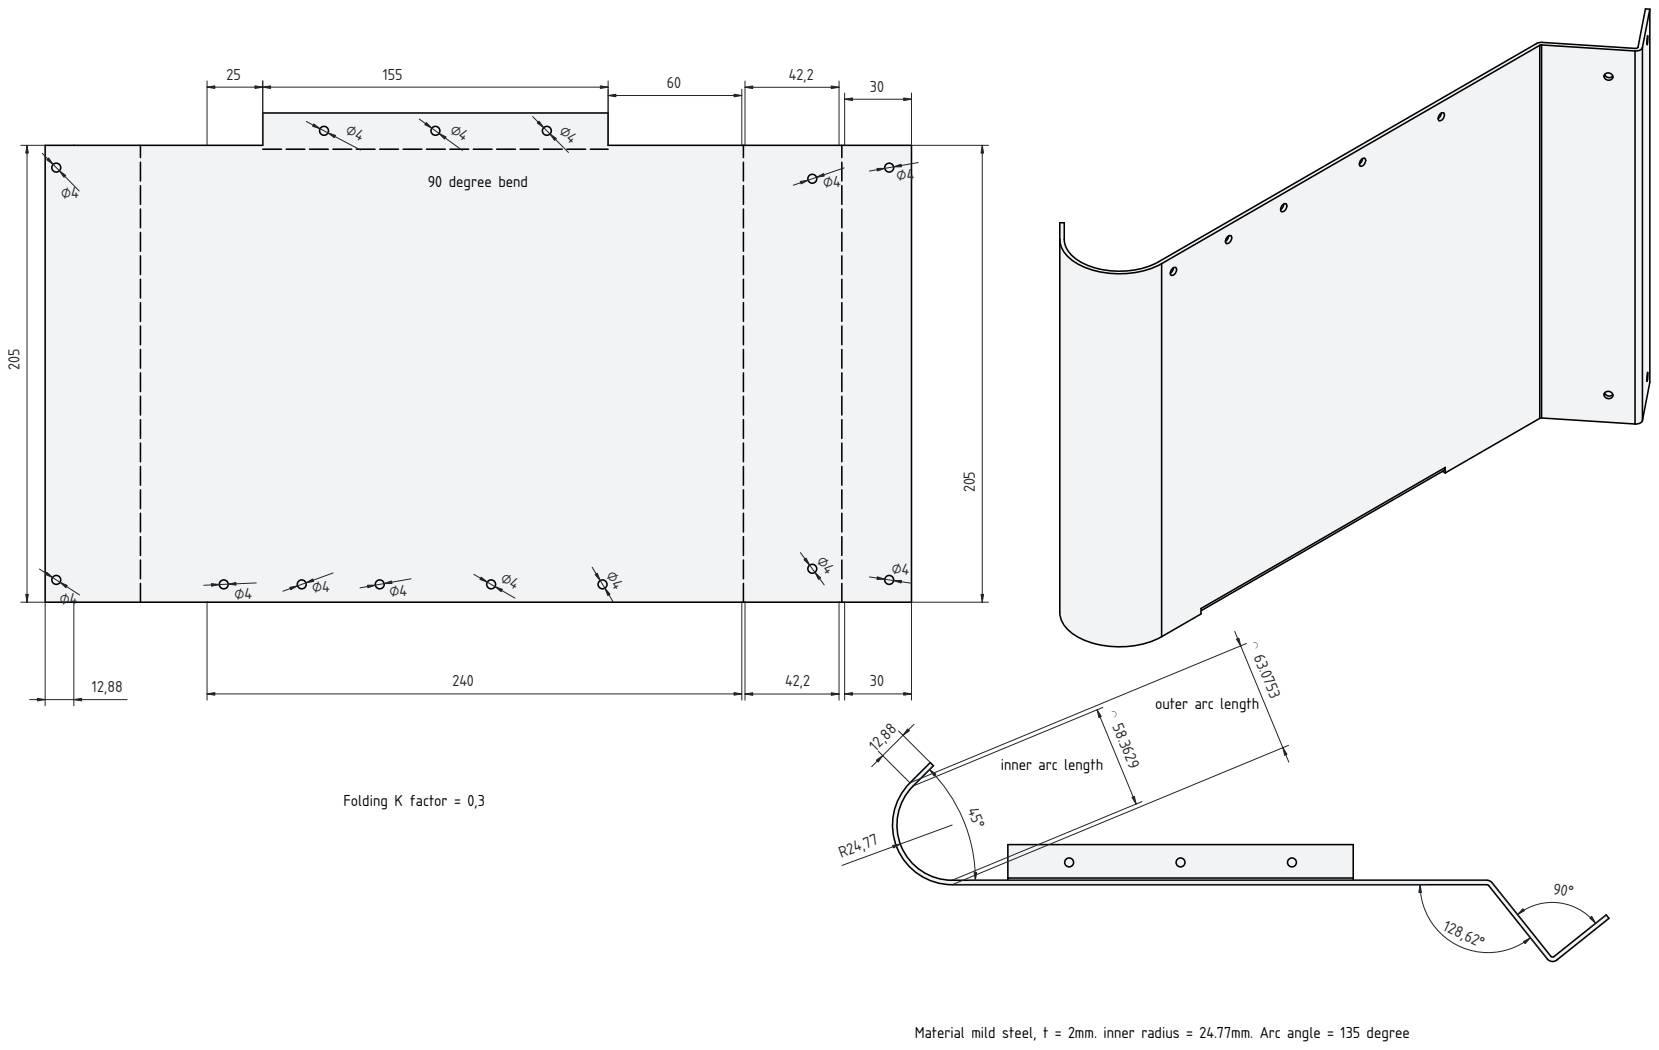
[picture p42: page 1]
Folding K factor = 0,3; 90 degree bend

outer arc length

inner arc length

Material mild steel, t = 2mm. inner radius = 24.77mm. Arc angle = 135 degree
