redfoxxxi/ET_MASTER_CODE/ET MASTER/ET STAND/Sketch/ET STAND-leg foundation 1 tech.pdf

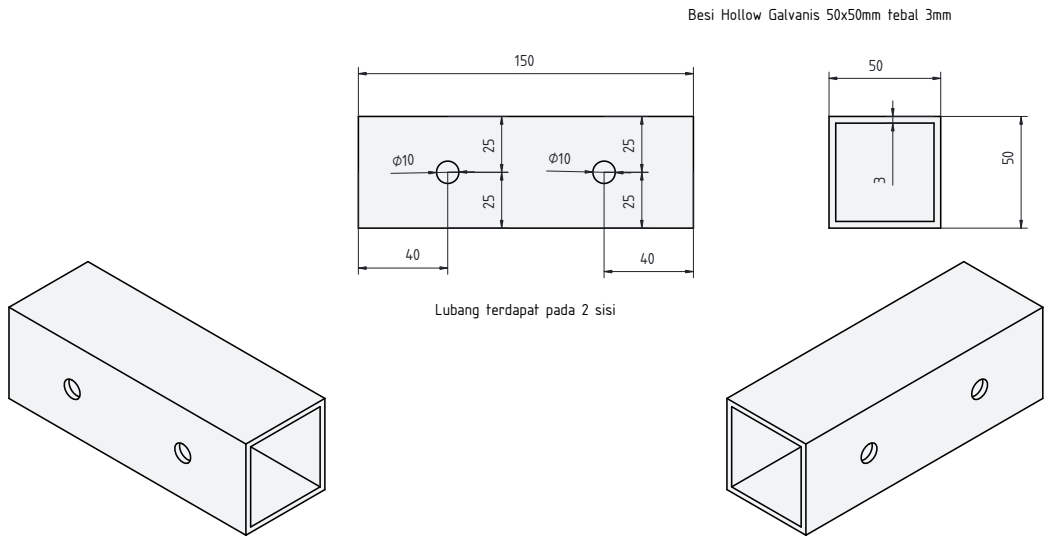
[picture p43: page 1]

Besi Hollow Galvanis 50x50mm tebal 3mm

Lubang terdapat pada 2 sisi
