redfoxxxi/ET_MASTER_CODE/ET MASTER/ET STAND/Sketch/ET STAND-leg foundation 2 tech.pdf

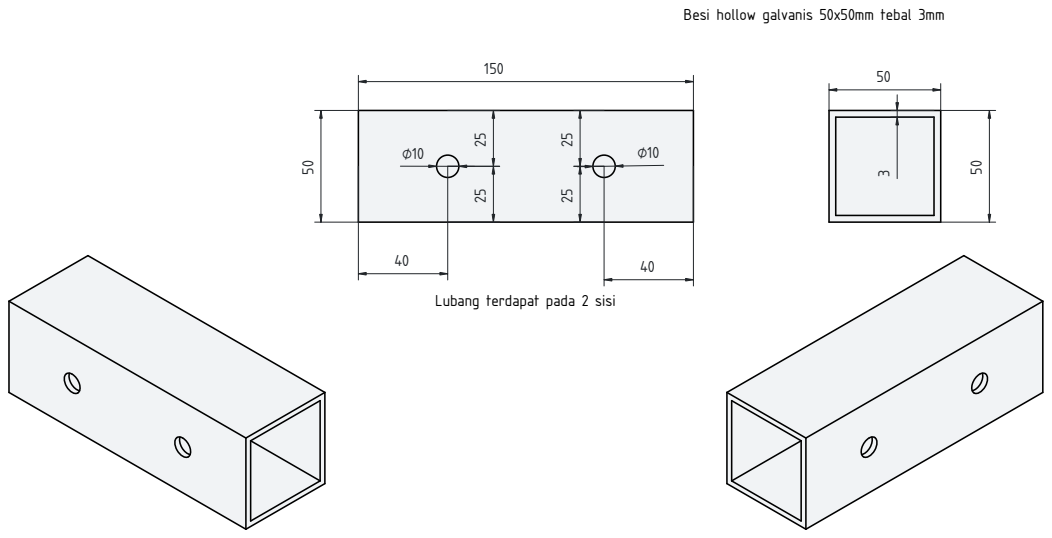
[picture p44: page 1]

Besi hollow galvanis 50x50mm tebal 3mm

Lubang terdapat pada 2 sisi
