redfoxxxi/ET_MASTER_CODE/ET MASTER/ET STAND/Sketch/ET STAND-lower support tech.pdf

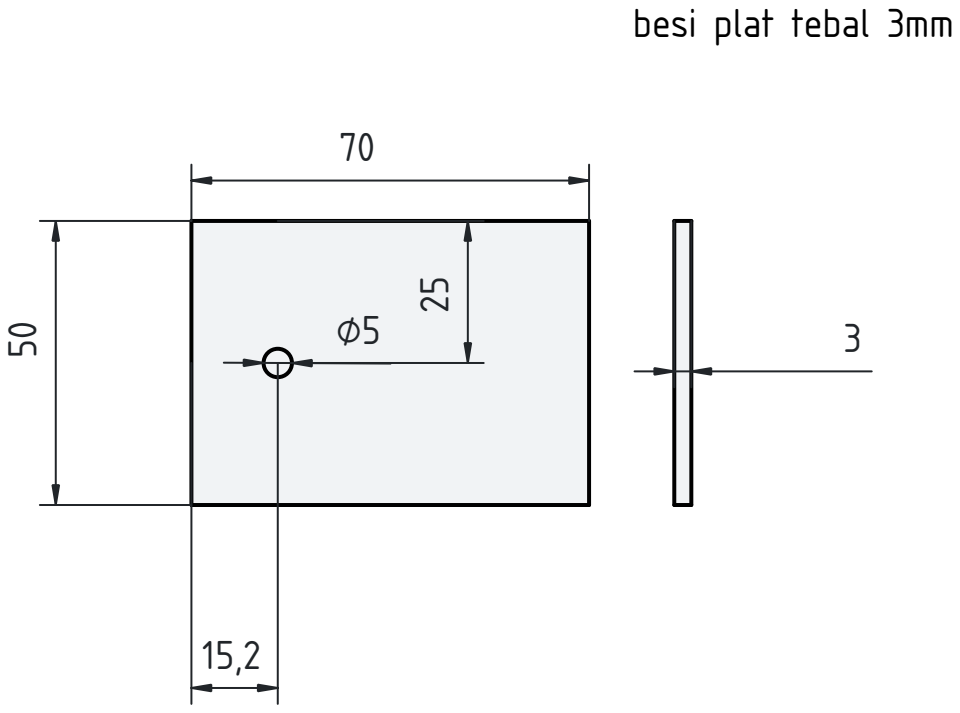
[picture p45: page 1]

besi plat tebal 3mm
