redfoxxxi/ET_MASTER_CODE/ET MASTER/ET STAND/Sketch/ET STAND-spacer tech.pdf

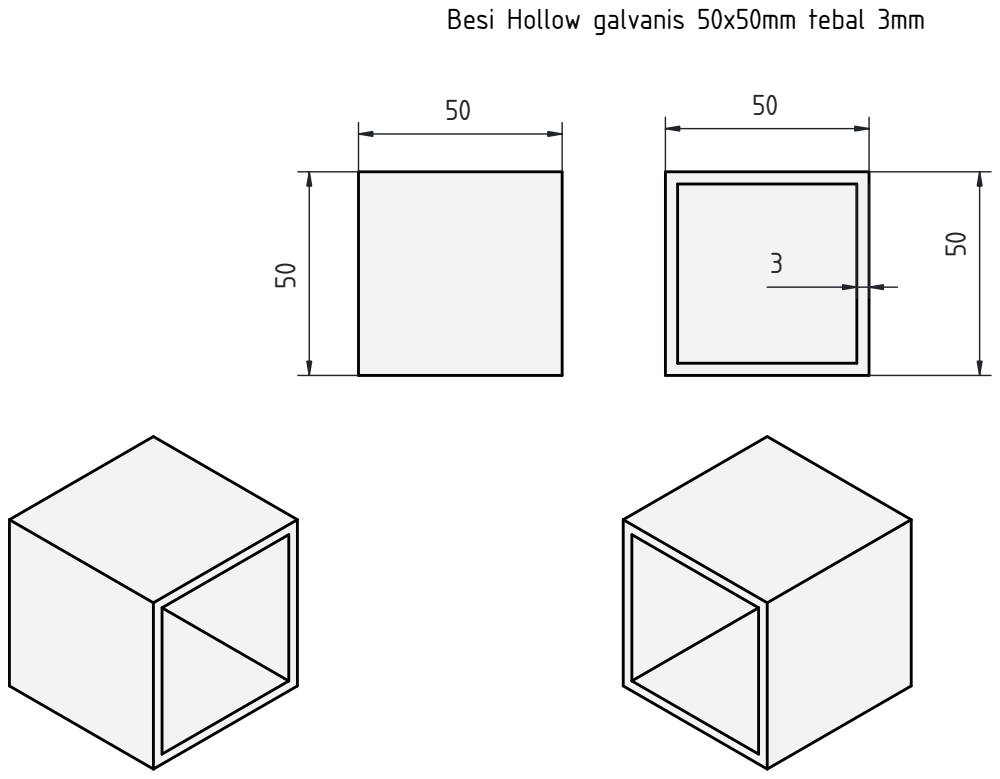
[picture p46: page 1]

Besi Hollow galvanis 50x50mm tebal 3mm
