redfoxxxi/ET_MASTER_CODE/ET MASTER/ET STAND/Sketch/ET STAND-stand 1 tech.pdf

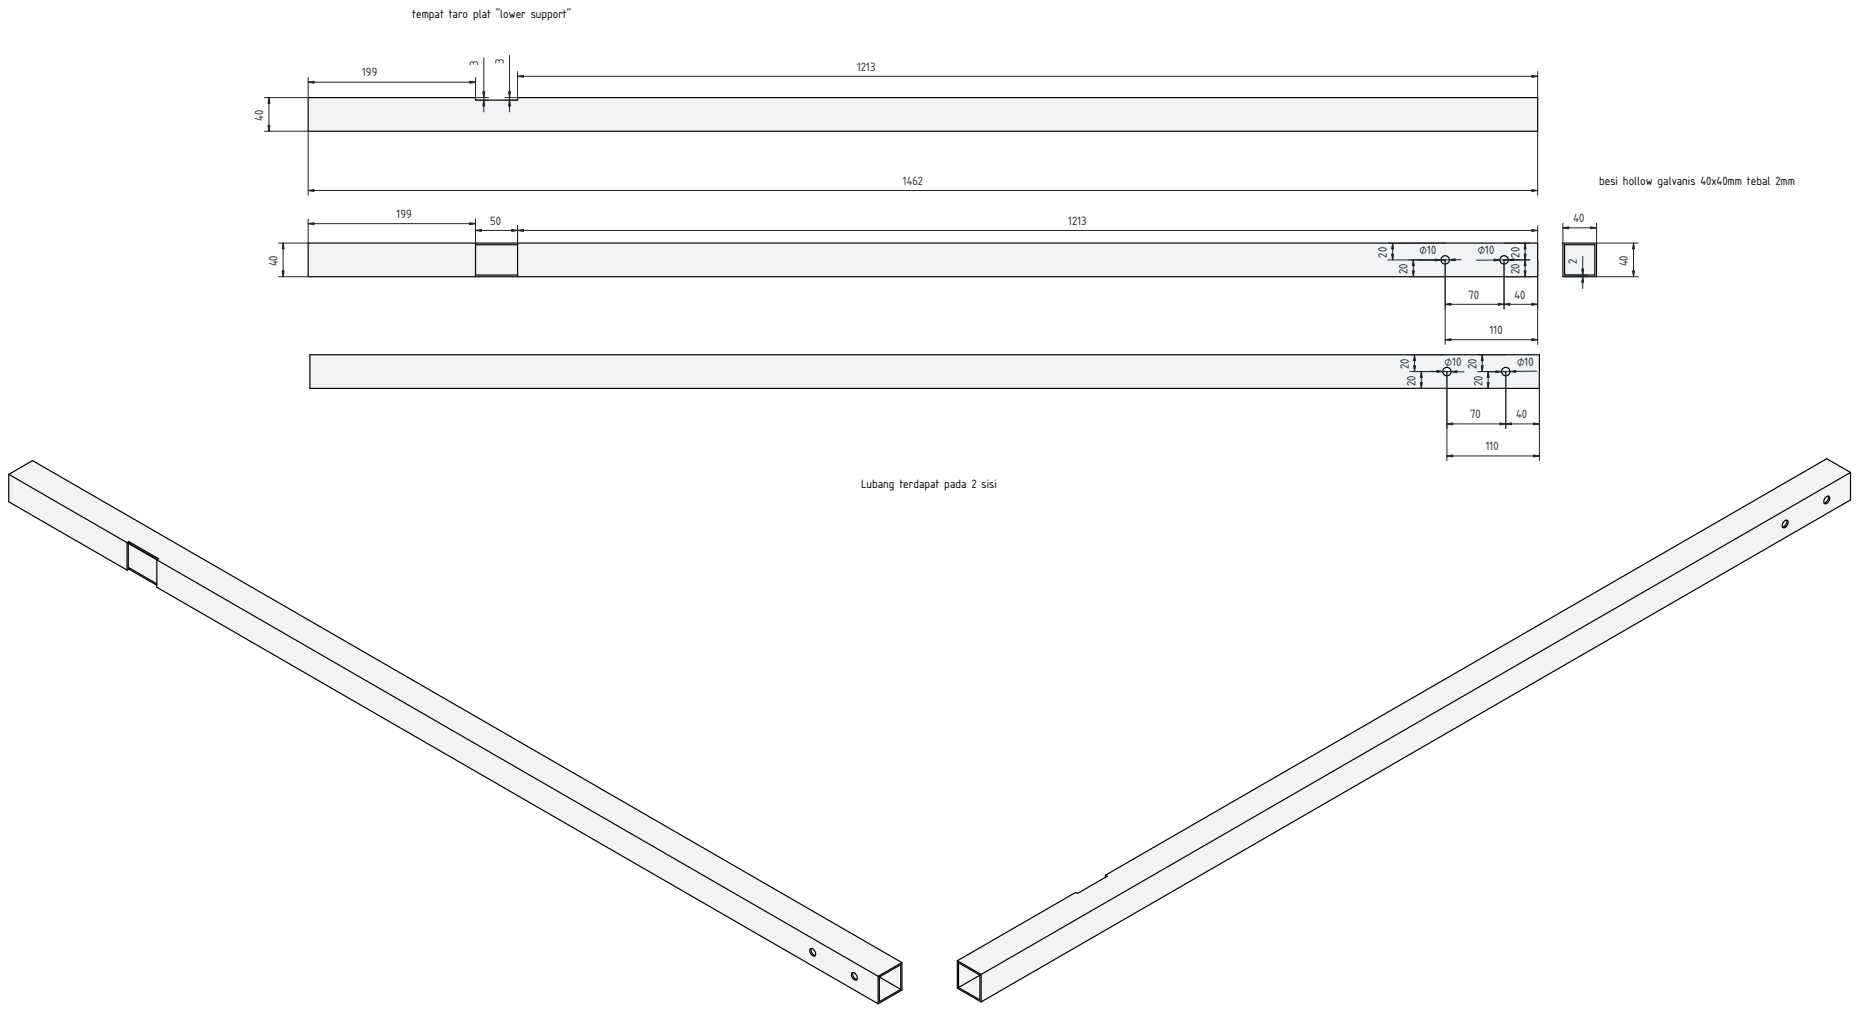
[picture p47: page 1]

tempat taro plat "lower support"

besi hollow galvanis 40x40mm tebal 2mm

Lubang terdapat pada 2 sisi
