redfoxxxi/ET_MASTER_CODE/ET MASTER/ET STAND/Sketch/ET STAND-support 1 tech.pdf

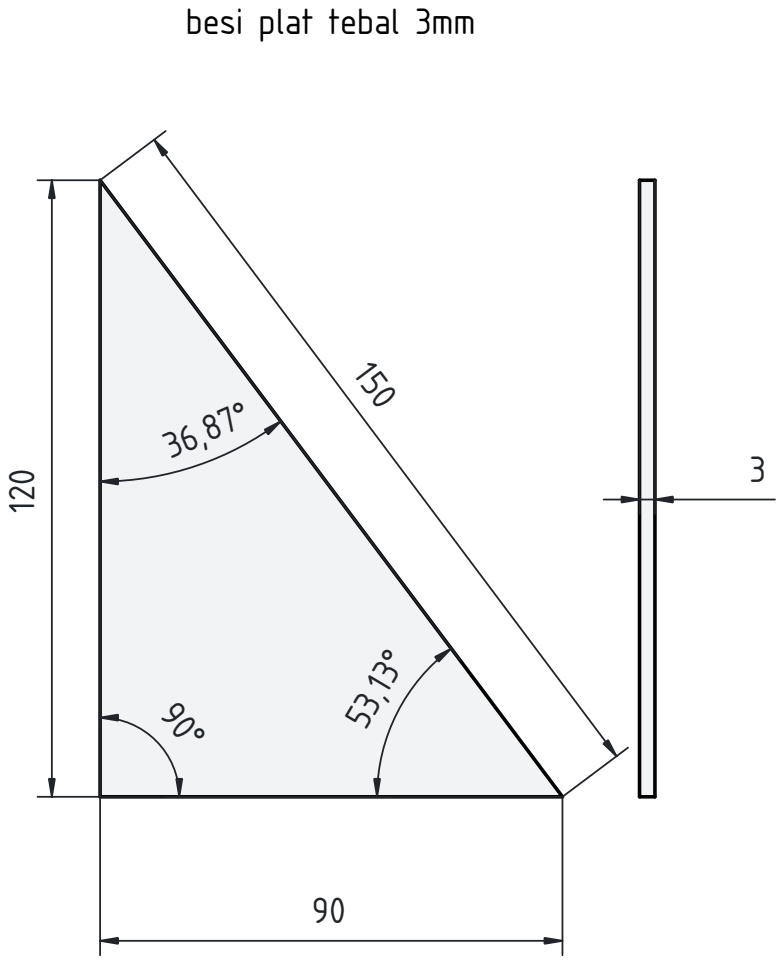
[picture p48: page 1]

besi plat tebal 3mm
