redfoxxxi/ET_MASTER_CODE/ET MASTER/ET STAND/Sketch/ET STAND-support 2 tech.pdf

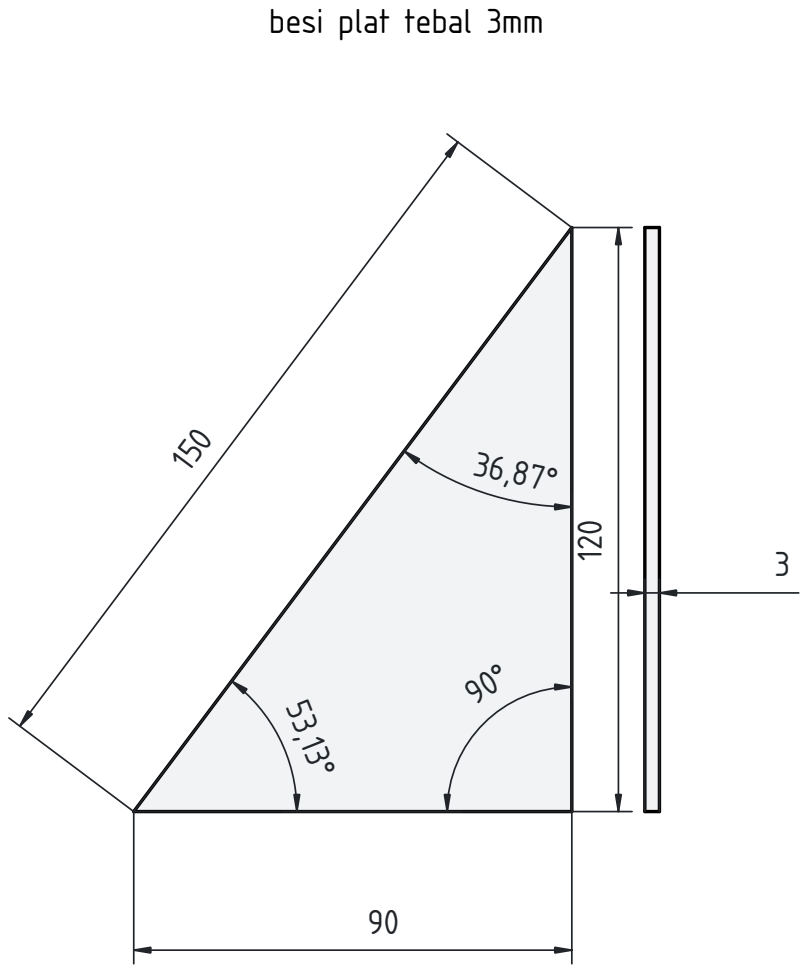
[picture p49: page 1]

besi plat tebal 3mm
