redfoxxxi/ET_MASTER_CODE/ET MASTER/ET STAND/Sketch/ET STAND-upper holder tech.pdf

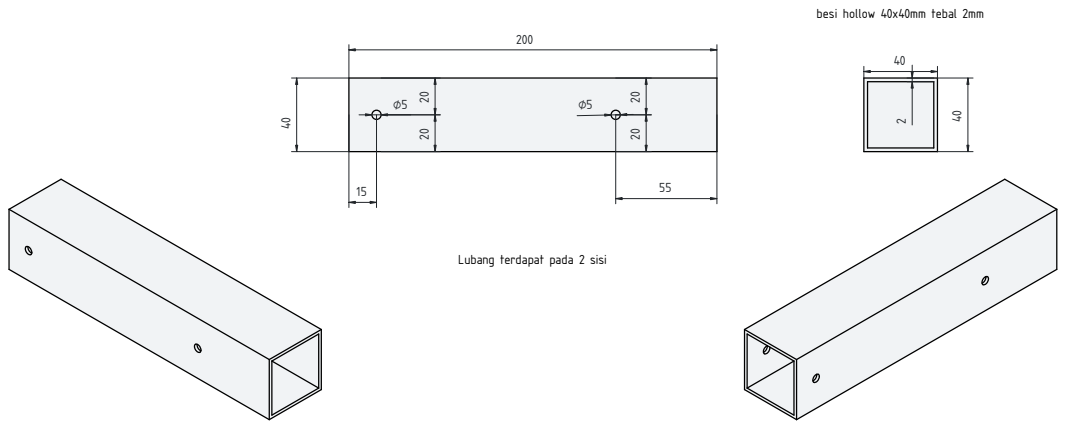
[picture p50: page 1]

besi hollow 40x40mm tebal 2mm

Lubang terdapat pada 2 sisi
