redfoxxxi/ET_MASTER_CODE/ET MASTER/ET STAND/Sketch/ET STAND-assembly tech 2.pdf

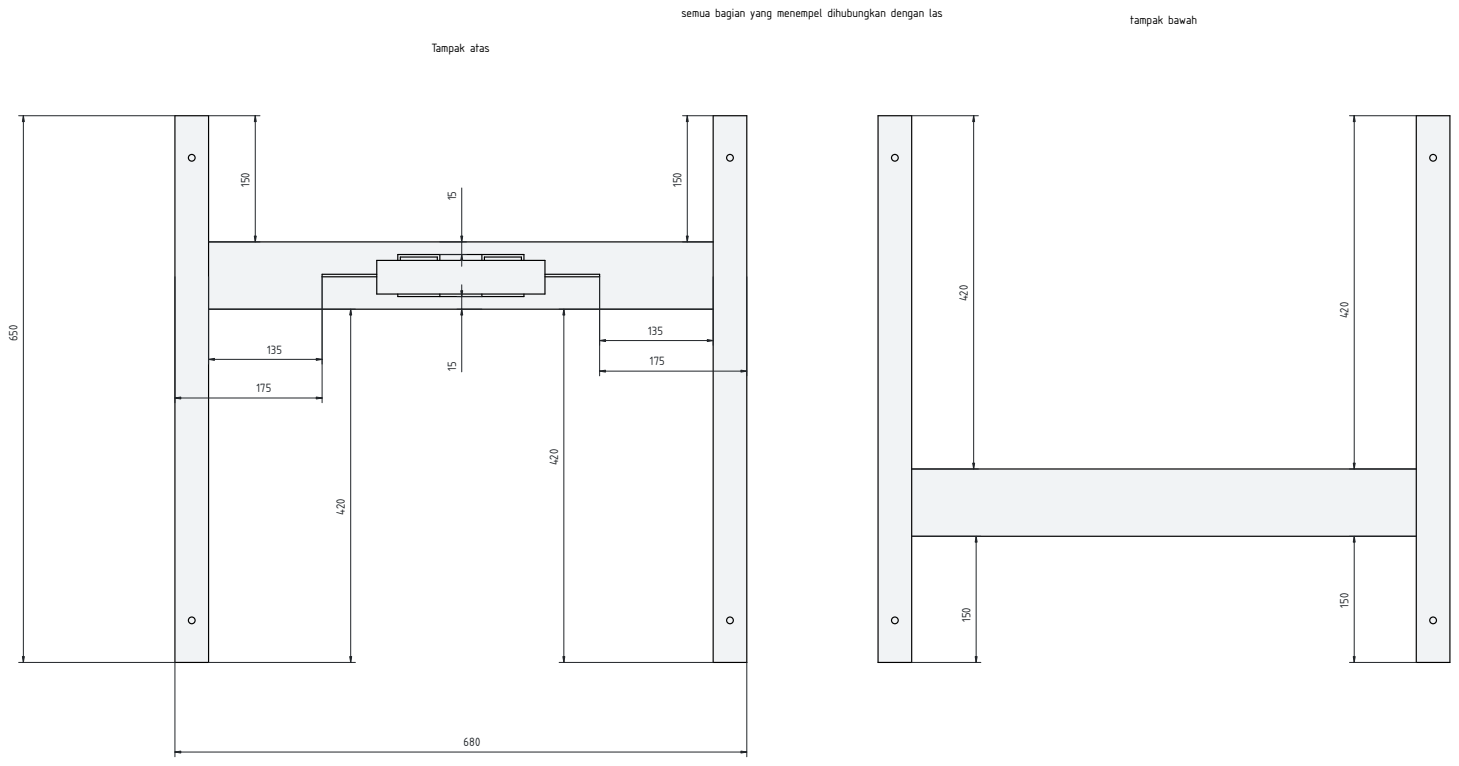
[picture p51: page 1]
Tampak atas; tampak bawah

semua bagian yang menempel dihubungkan dengan las
