redfoxxxi/ET_MASTER_CODE/ET MASTER/ET STAND/Sketch/ET STAND-assembly tech 3.pdf

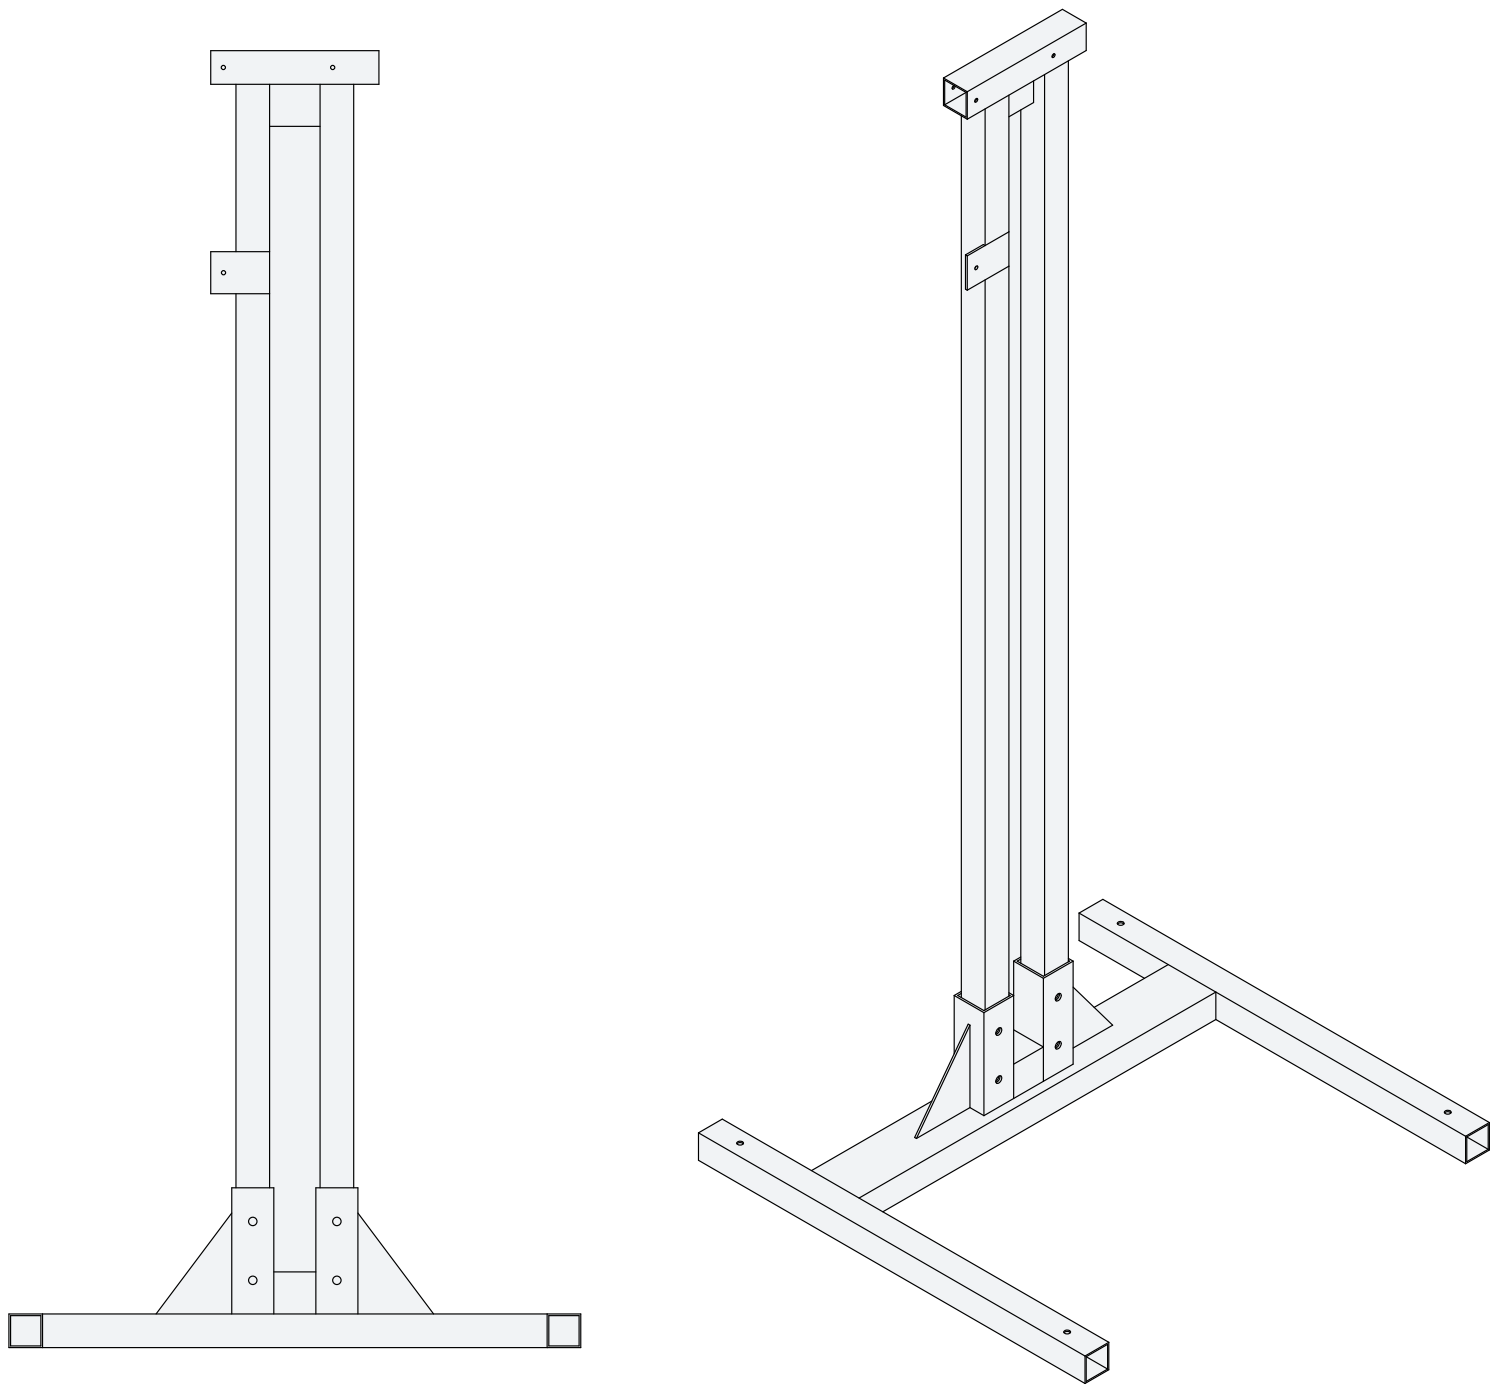
[picture p52: page 1]
