redfoxxxi/ET_MASTER_CODE/ET MASTER/ET STAND/Sketch/ET STAND-assembly tech 4.pdf

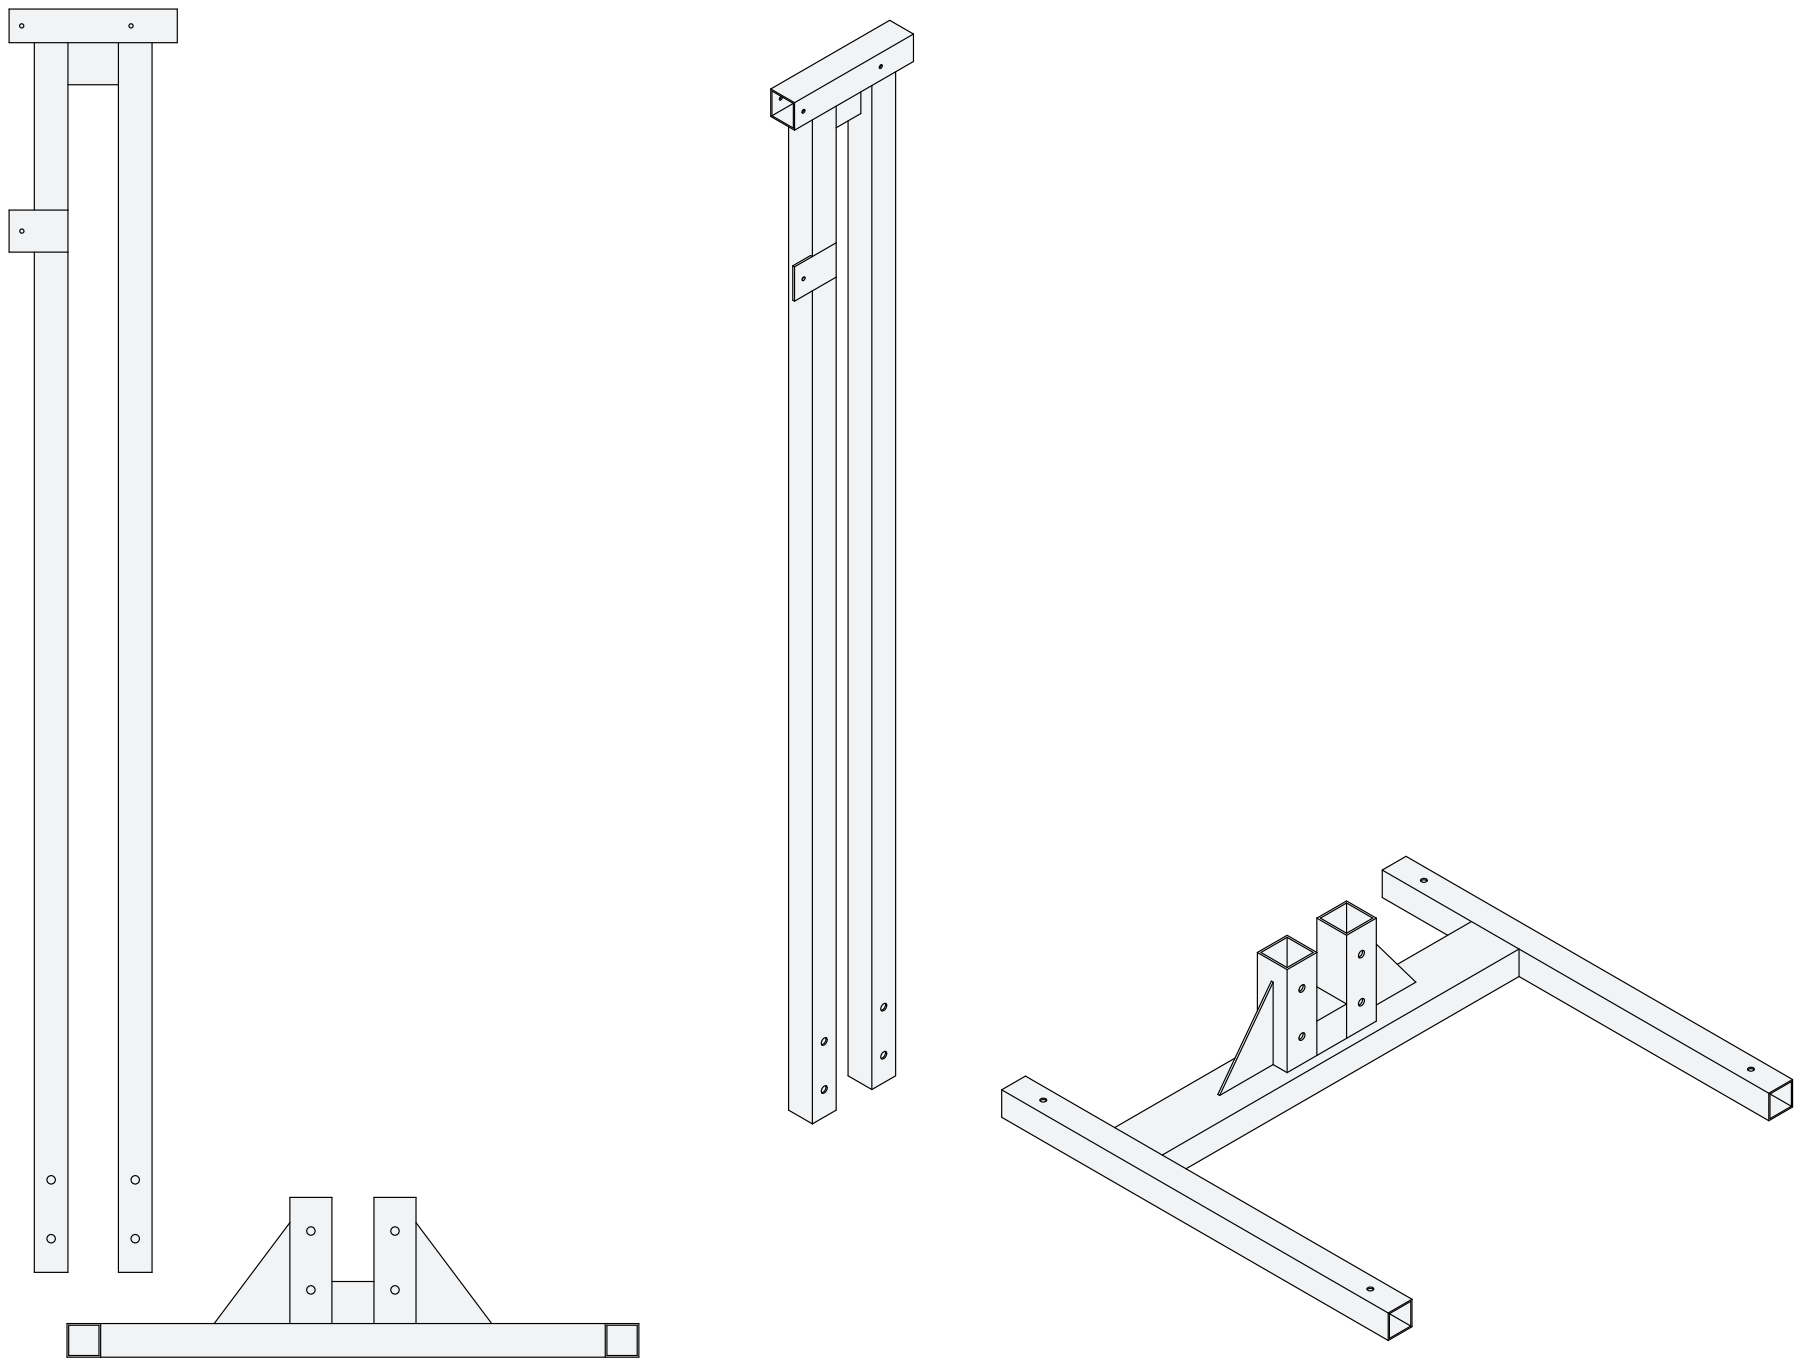
[picture p53: page 1]
