redfoxxxi/ET_MASTER_CODE/ET MASTER/Metal Body V2/Part Design/COLLECTOR/metal body-collector tech.pdf

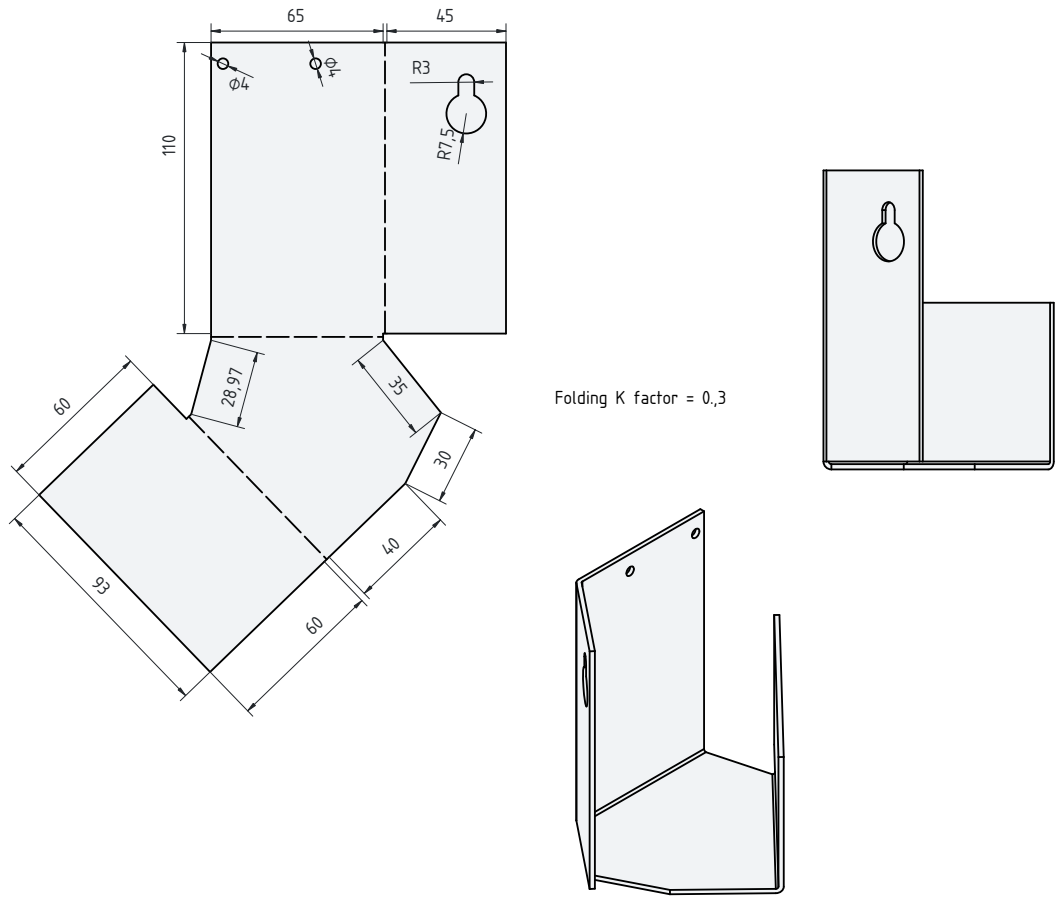
[picture p54: page 1]
Folding K factor = 0.,3
