redfoxxxi/ET_MASTER_CODE/ET MASTER/Metal Body V2/Part Design/FRONT PLATE/metal body-Front plate preview.pdf

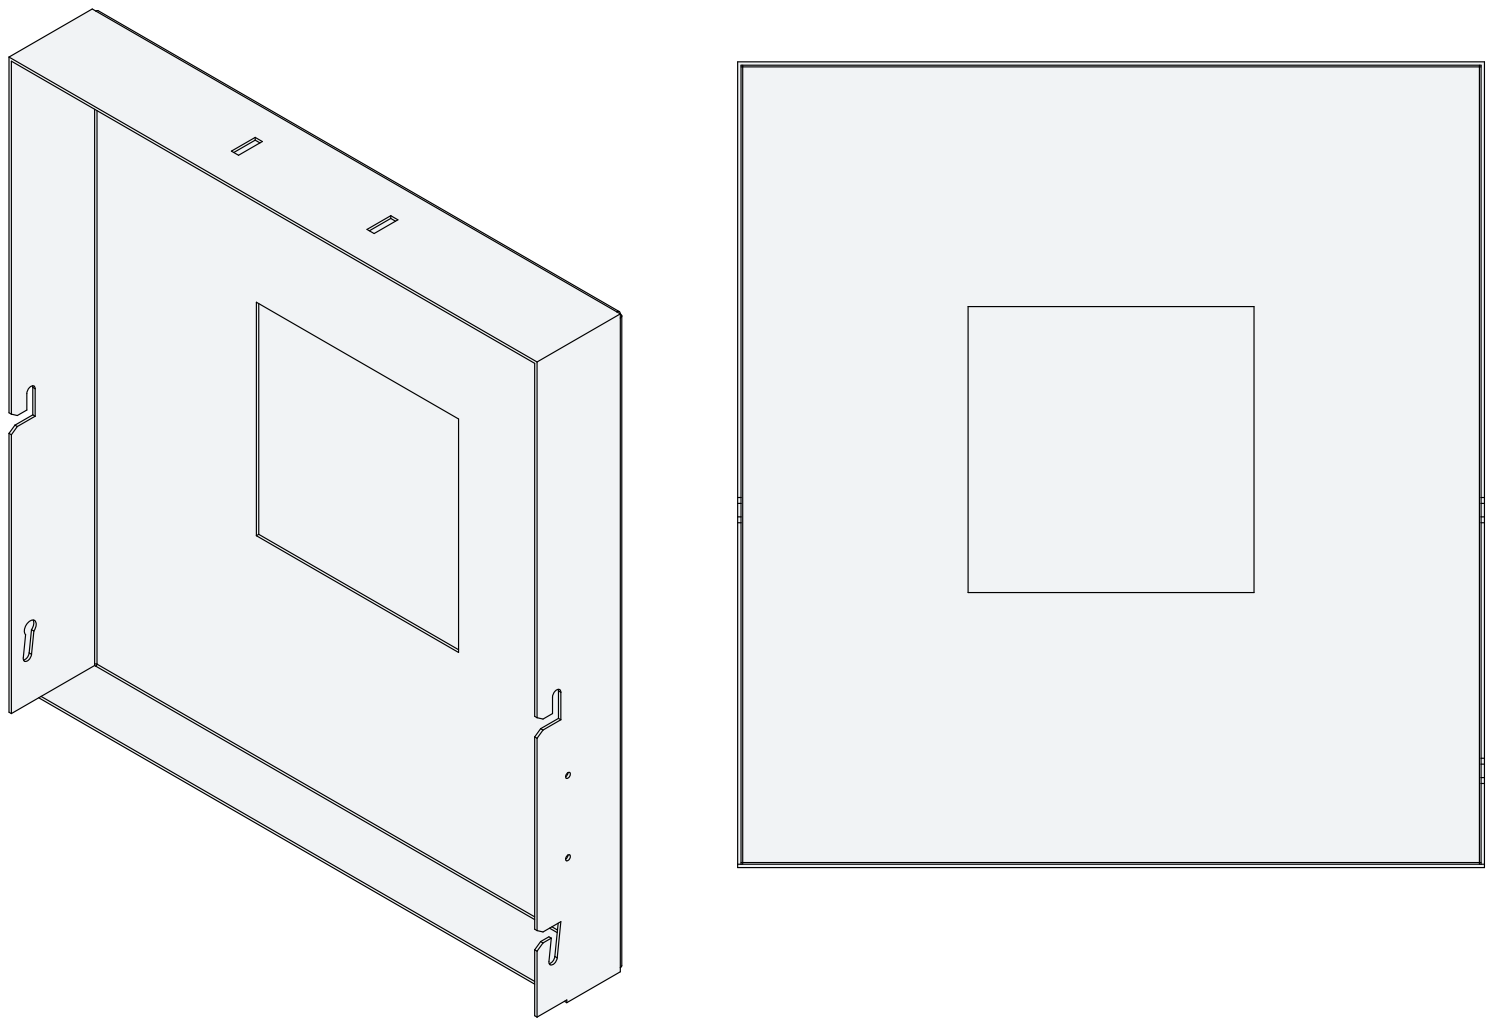
[picture p55: page 1]
