redfoxxxi/ET_MASTER_CODE/ET MASTER/Metal Body V2/Part Design/FRONT PLATE/metal body-front plate tech.pdf

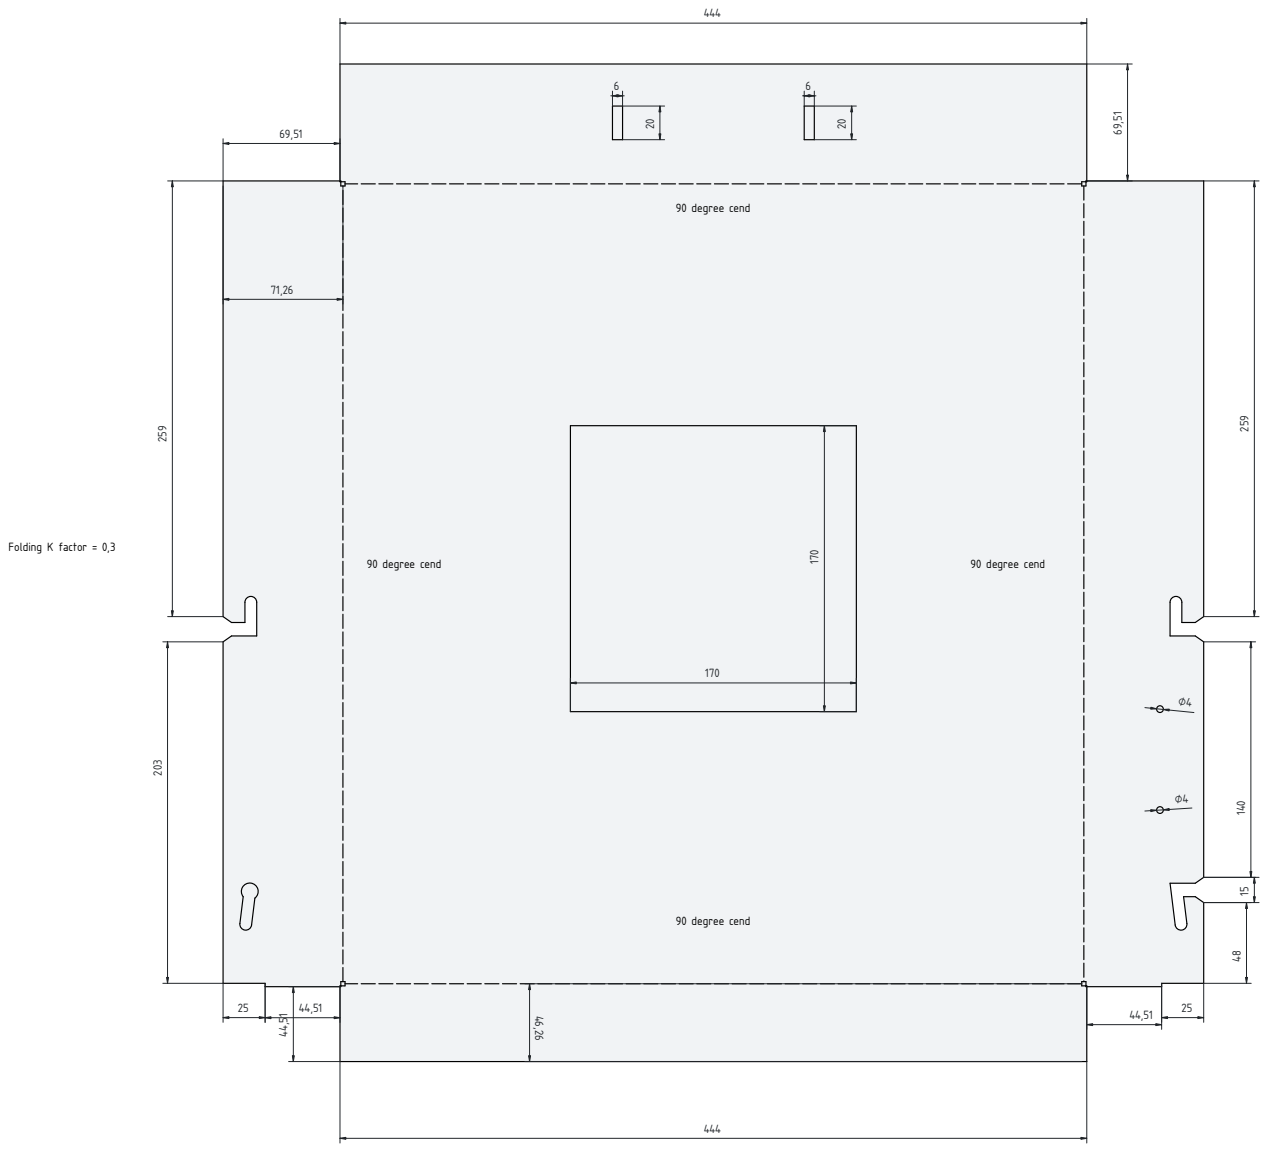
[picture p56: page 1]
Folding K factor = 0,3; 90 degree cend
