redfoxxxi/ET_MASTER_CODE/ET MASTER/Metal Body V2/Part Design/MOTOR MOUNT/metal body-motor mount tech.pdf

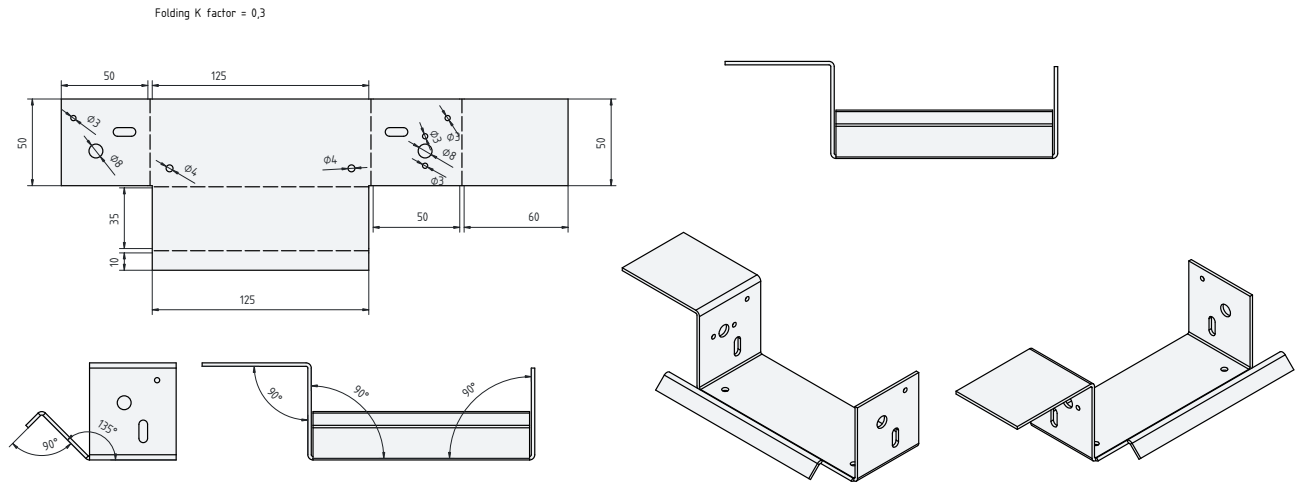
[picture p57: page 1]
Folding K factor = 0,3
