redfoxxxi/ET_MASTER_CODE/ET MASTER/Metal Body V2/Part Design/PLATE HOLDER (Mirror)/metal body-plate holder (mirror) tech.pdf

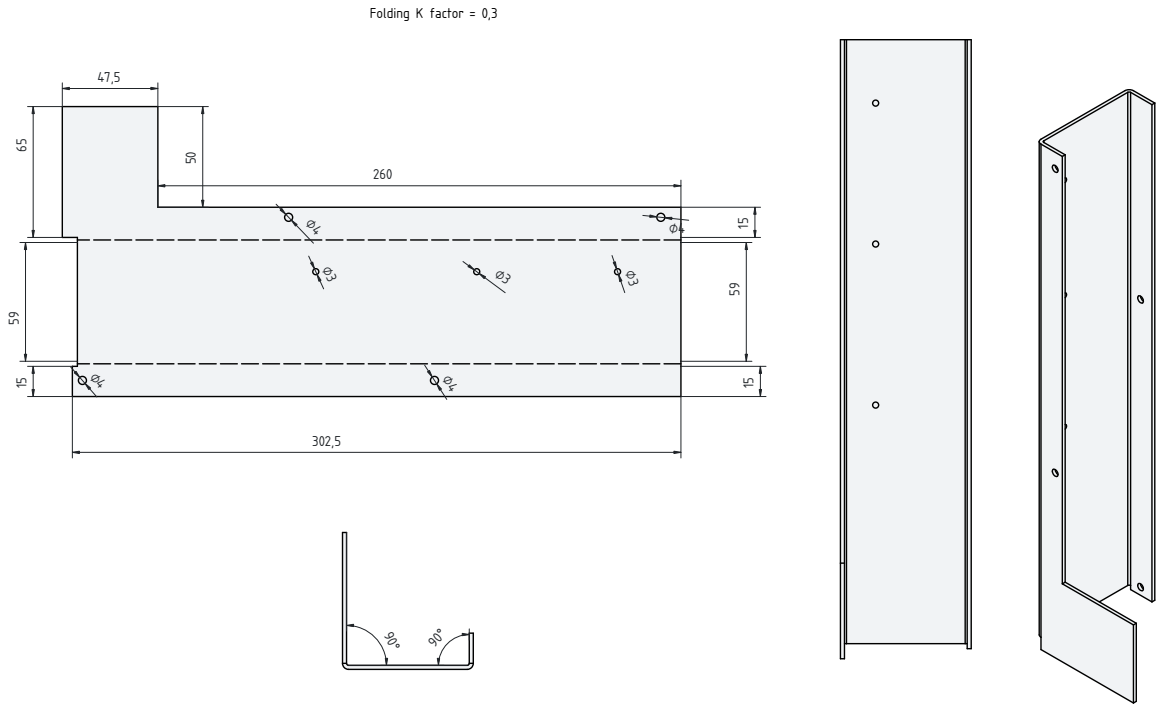
[picture p58: page 1]
Folding K factor = 0,3
