redfoxxxi/ET_MASTER_CODE/ET MASTER/Metal Body V2/Part Design/PLATE HOLDER/metal body-plate holder tech.pdf

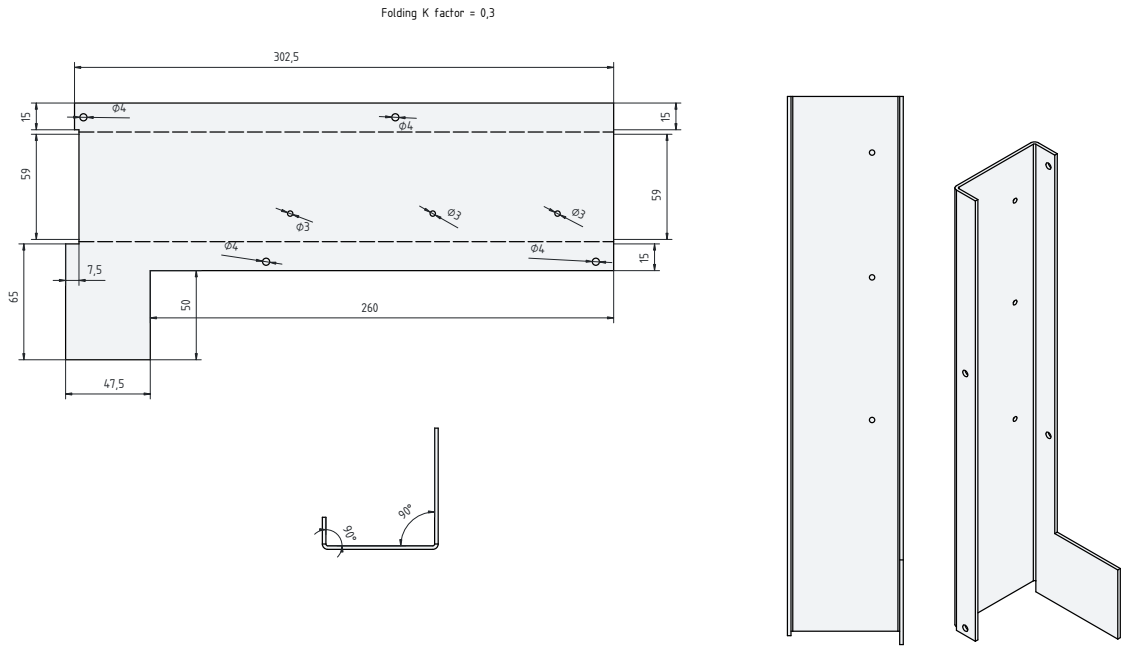
[picture p59: page 1]
Folding K factor = 0,3
