redfoxxxi/ET_MASTER_CODE/ET MASTER/Metal Body V2/Part Design/PROTECTOR PLATE/metal body-protector plate tech.pdf

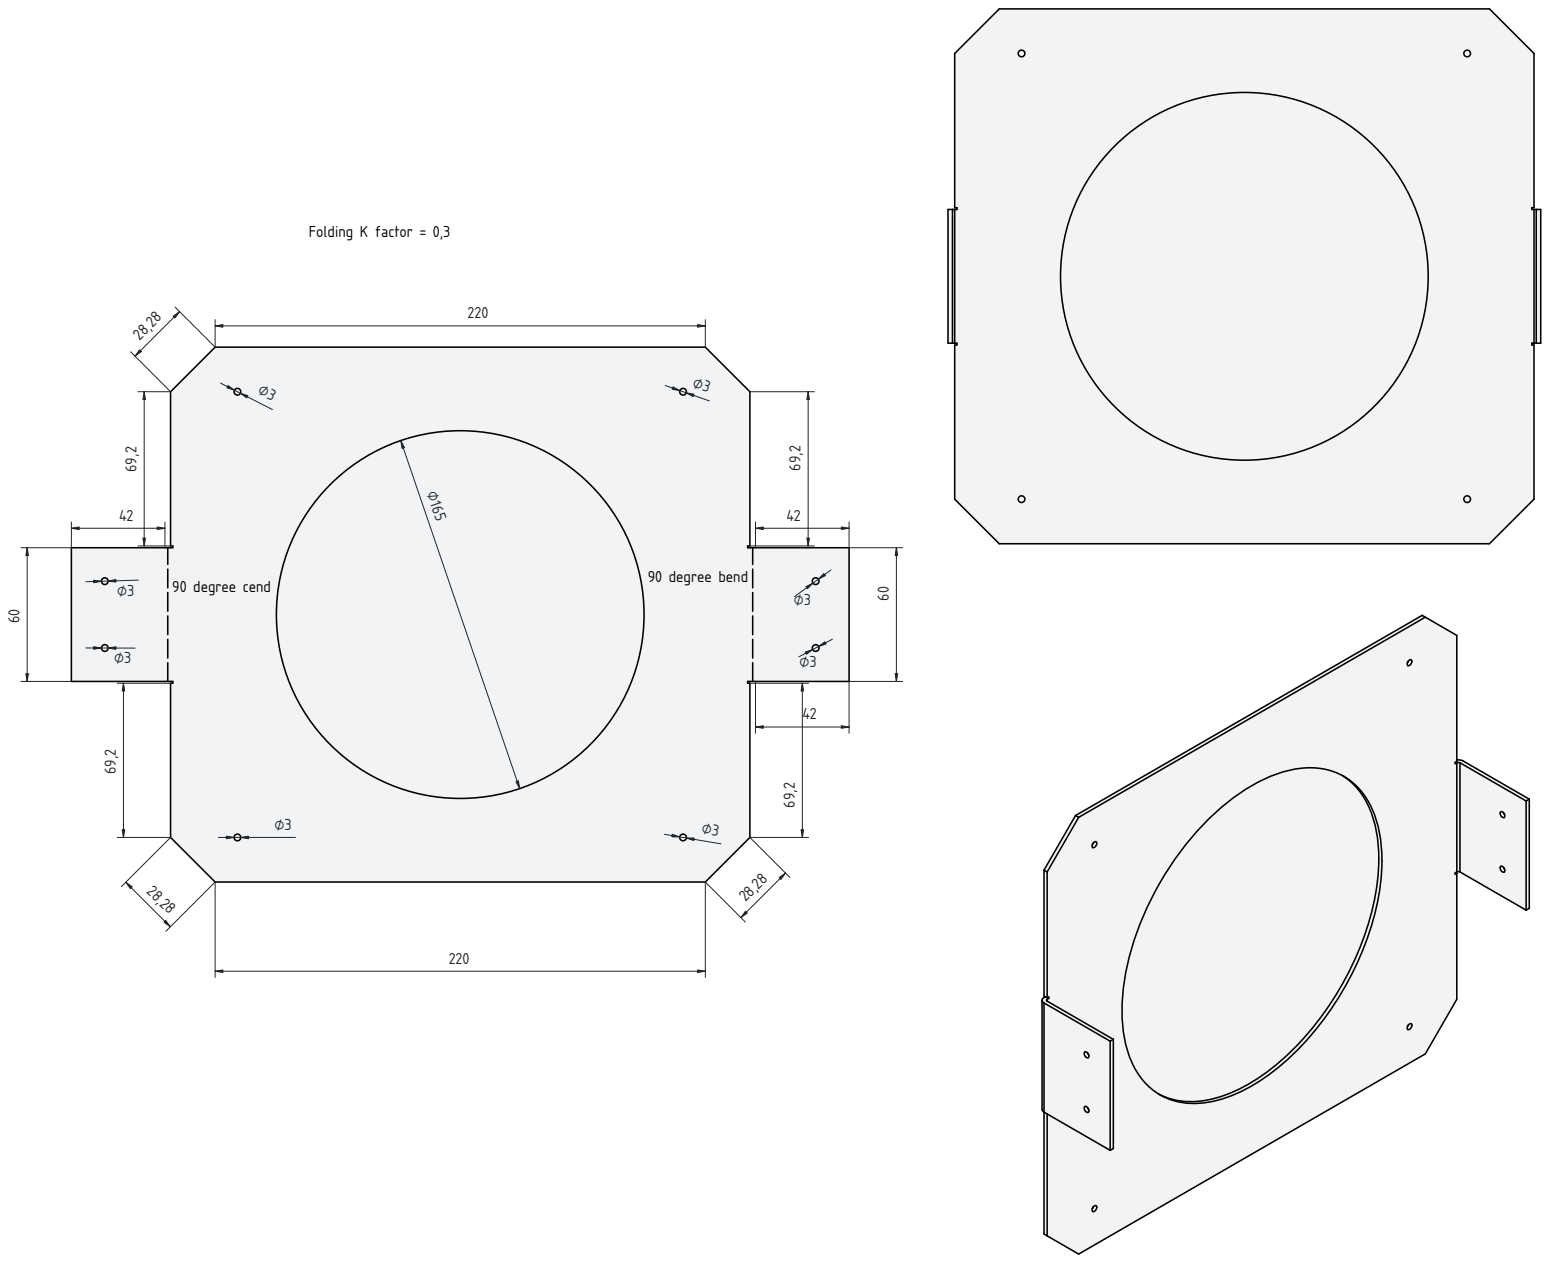
[picture p60: page 1]
Folding K factor = 0,3; 90 degree bend; 90 degree cend
