redfoxxxi/ET_MASTER_CODE/ET MASTER/Metal Body V2/Part Design/ROLL HOLDER/metal body-roll holder tech.pdf

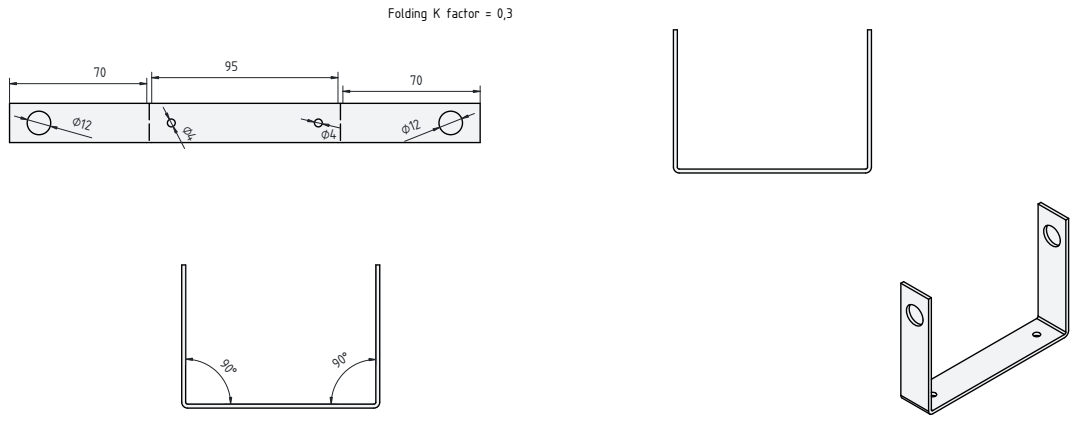
[picture p61: page 1]
Folding K factor = 0,3
