redfoxxxi/ET_MASTER_CODE/ET MASTER/Metal Body V2/Part Design/SIDE PLATE A/metal body-side plate a tech.pdf

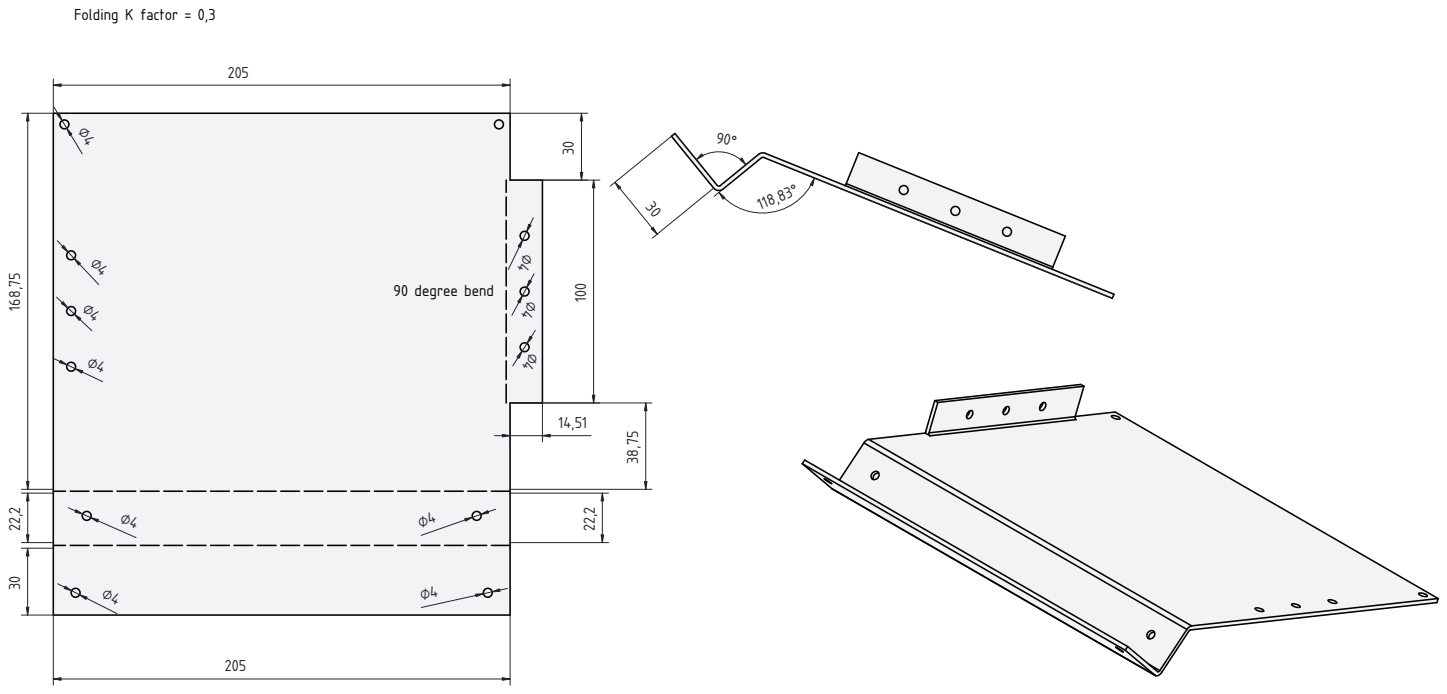
[picture p62: page 1]
Folding K factor = 0,3; 90 degree bend
