redfoxxxi/ET_MASTER_CODE/ET MASTER/Metal Body V2/Part Design/TRAP FOUNDATION/metal body-trap foundation tech.pdf

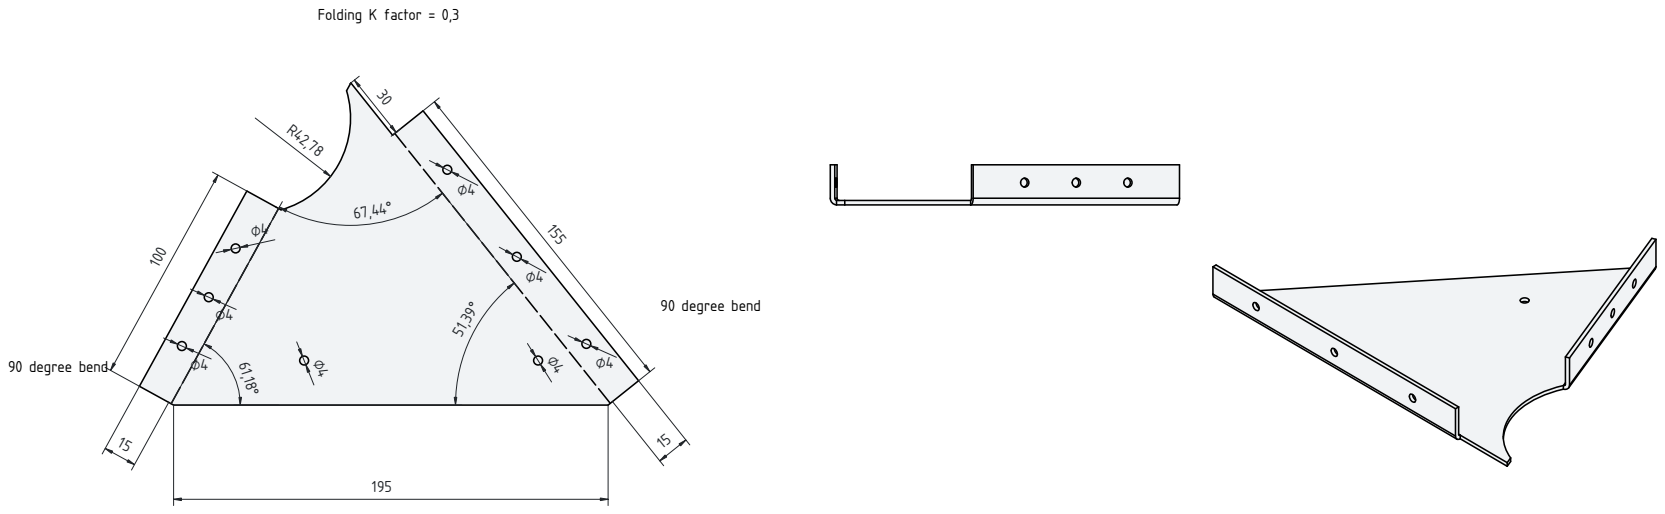
[picture p63: page 1]
Folding K factor = 0,3; 90 degree bend
