redfoxxxi/ET_MASTER_CODE/ET MASTER/Metal Body V2/Part Design/UPPER TRAP/metal body-upper trap tech.pdf

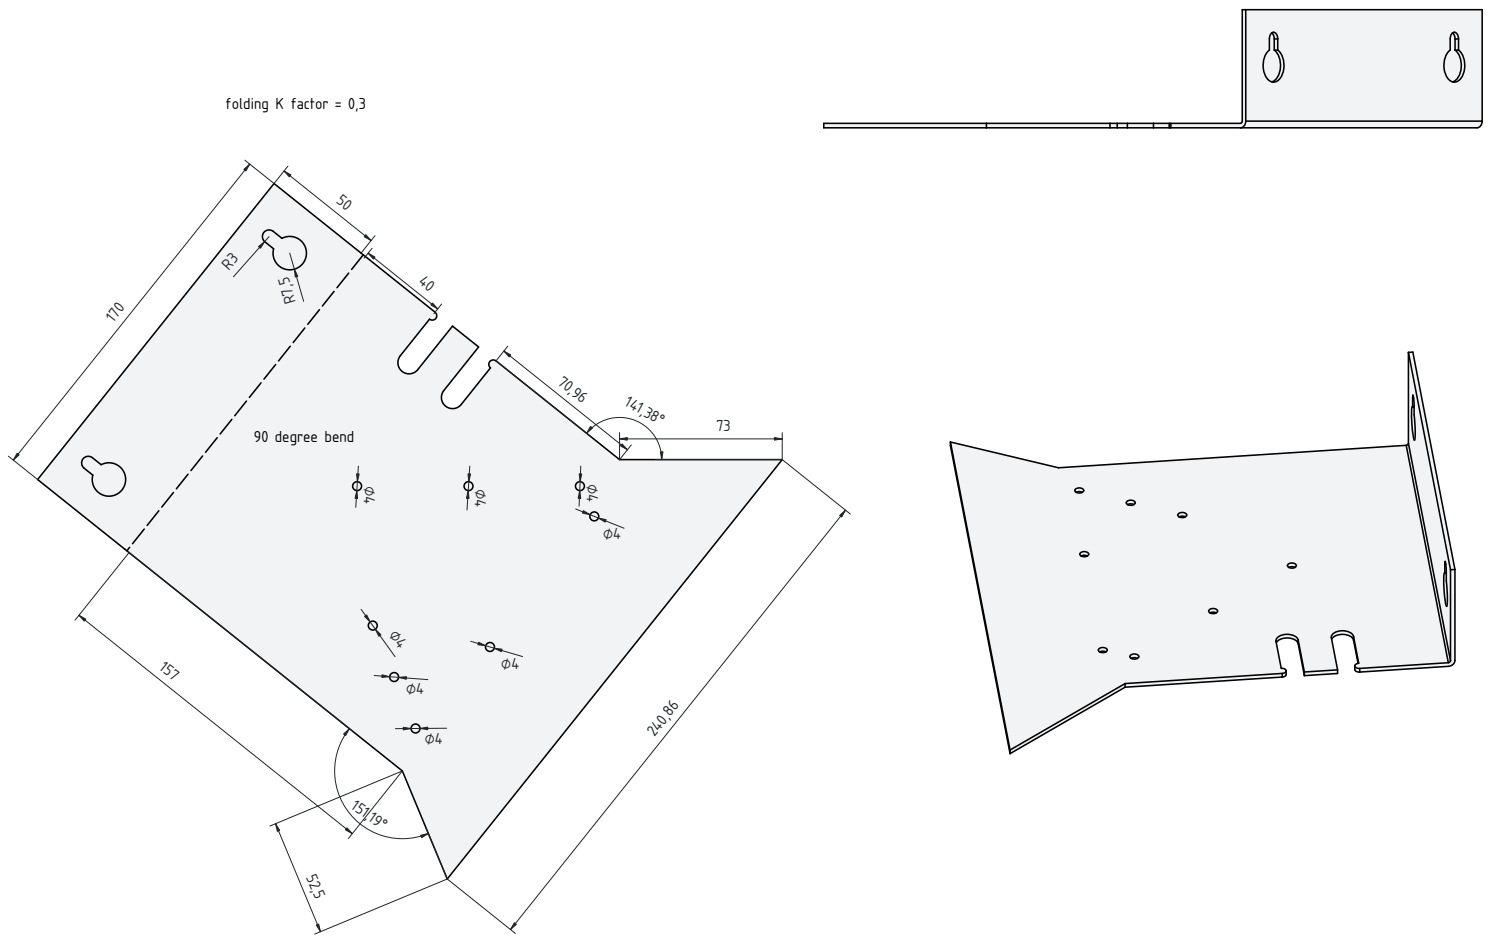
[picture p64: page 1]
folding K factor = 0,3; 90 degree bend
