redfoxxxi/ET_MASTER_CODE/ET MASTER/ET ACRYLIC BODY v2/laser cut file/acrylic body.pdf

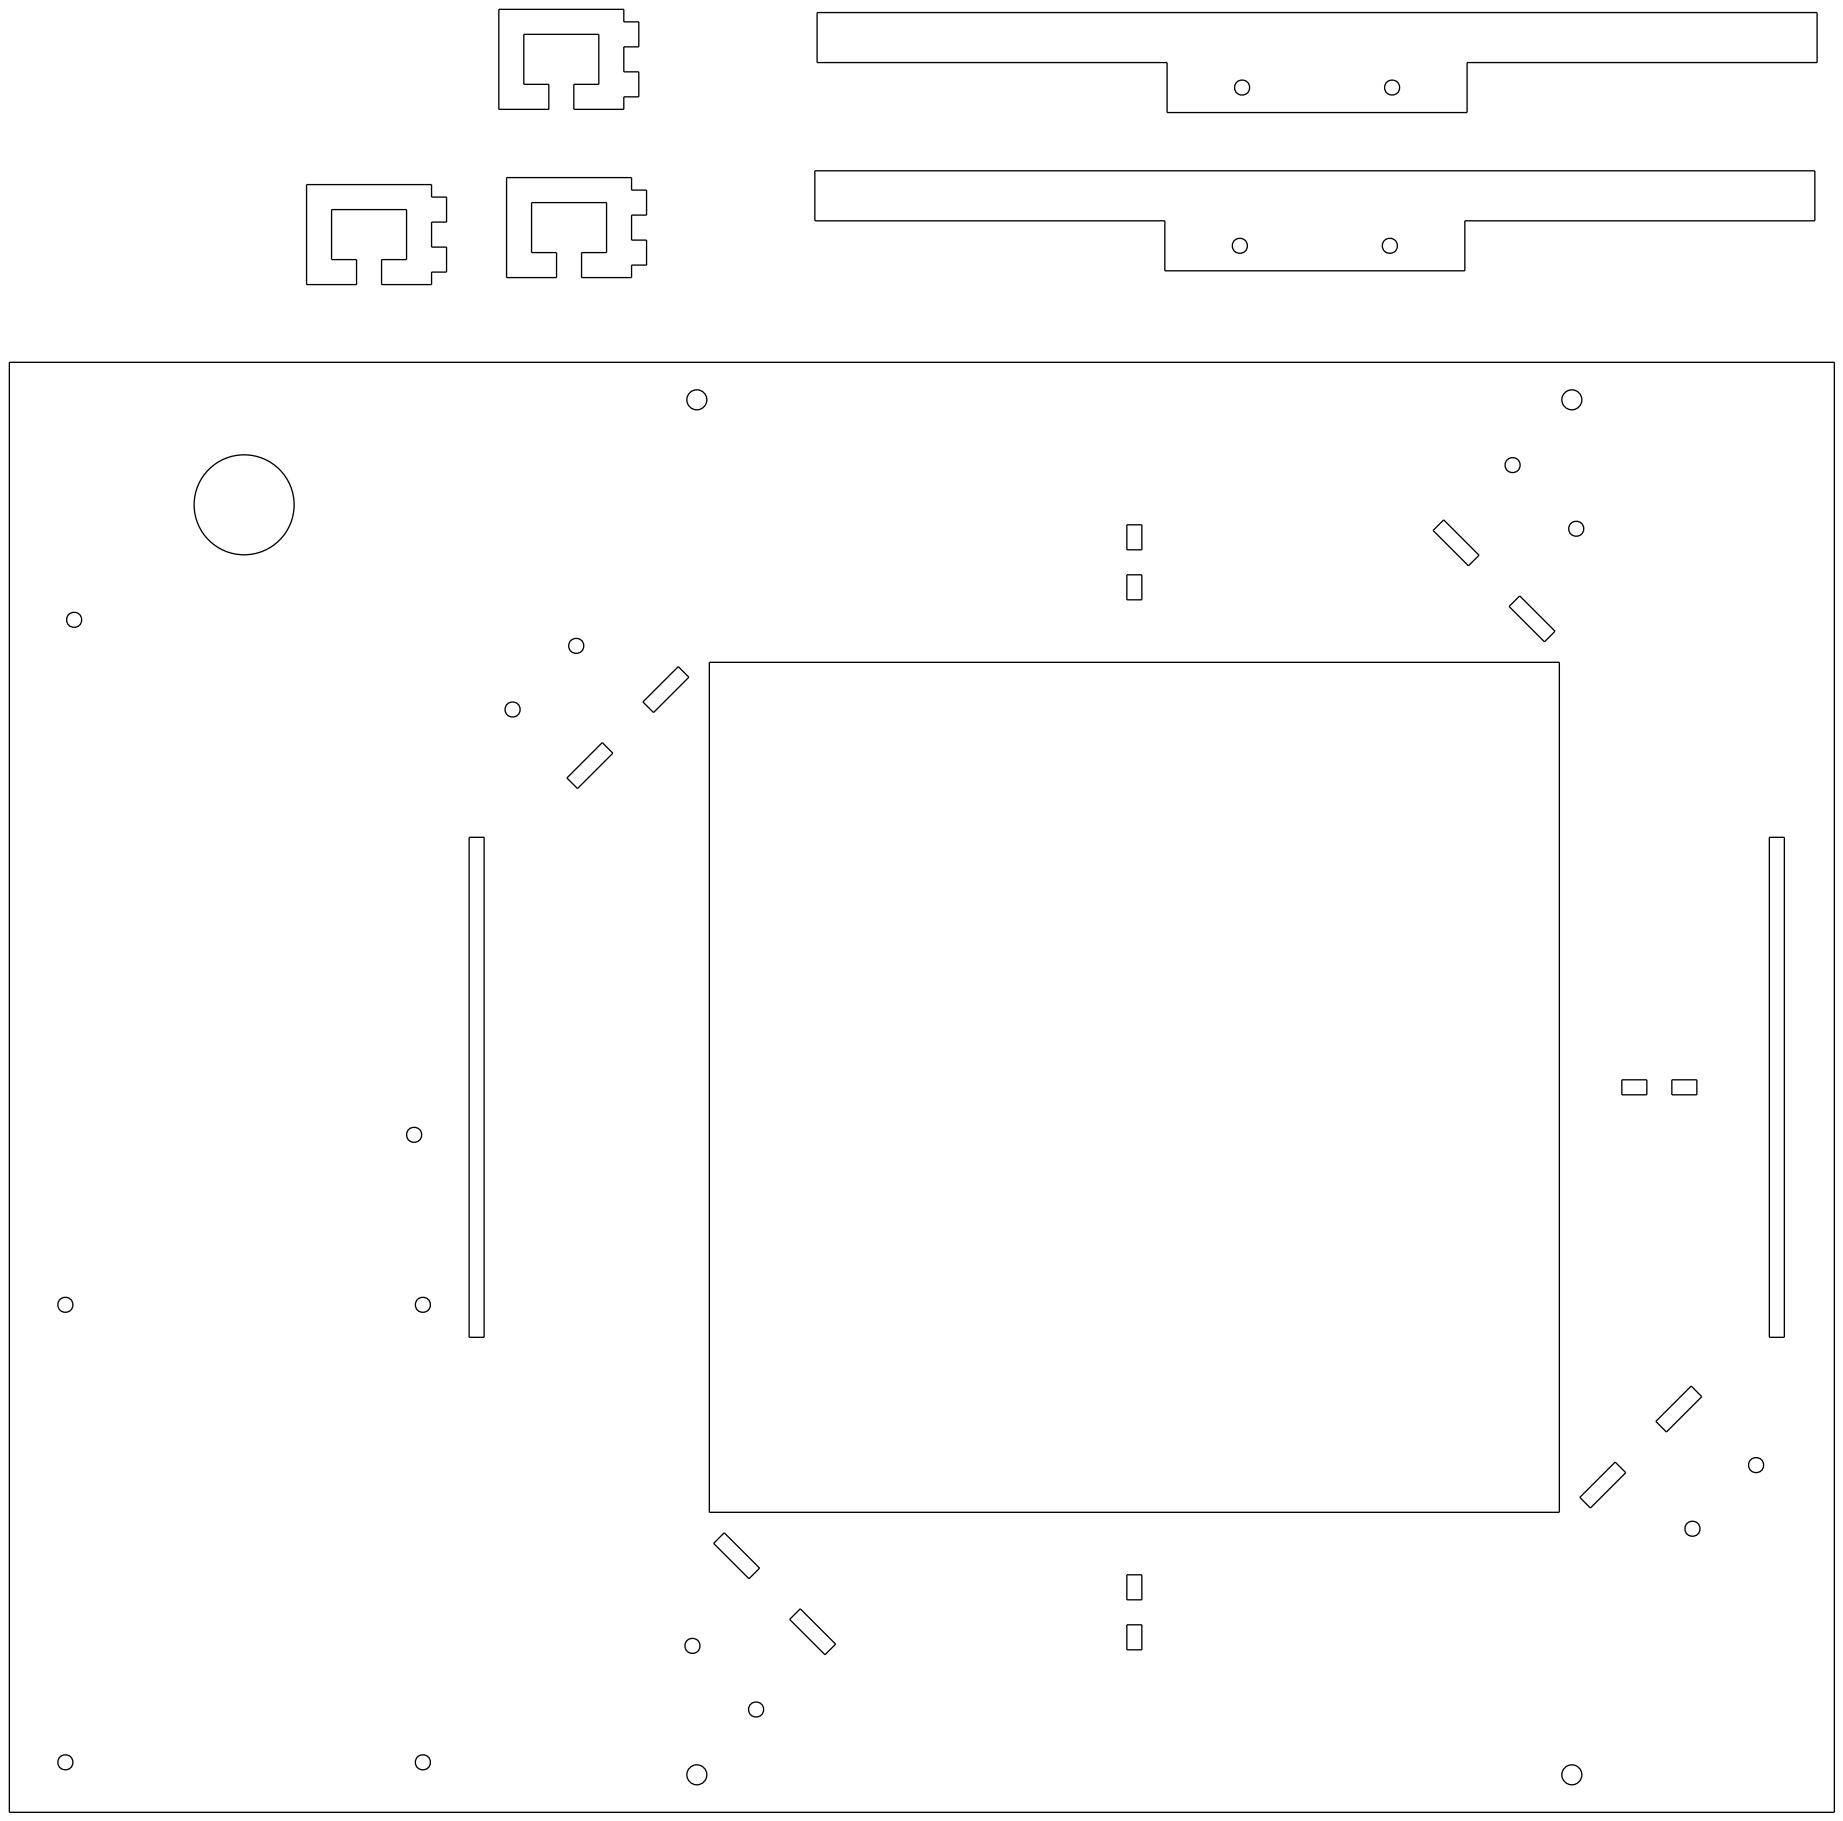
[picture p65: page 1]
