redfoxxxi/ET_MASTER_CODE/ET MASTER/ET STAND/Sketch/ET STAND-main leg tech.pdf

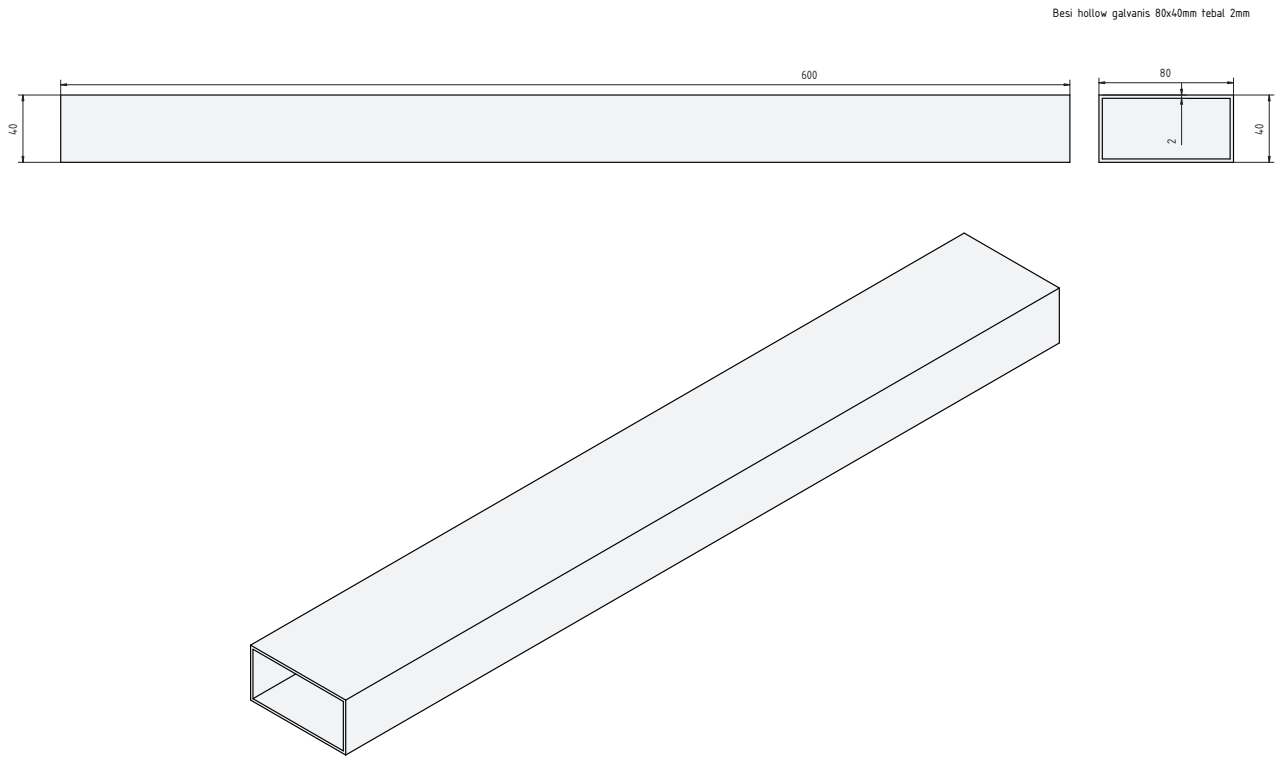
[picture p66: page 1]
