redfoxxxi/ET_MASTER_CODE/ET MASTER/ET STAND/Sketch/ET STAND-stand 2 tech.pdf

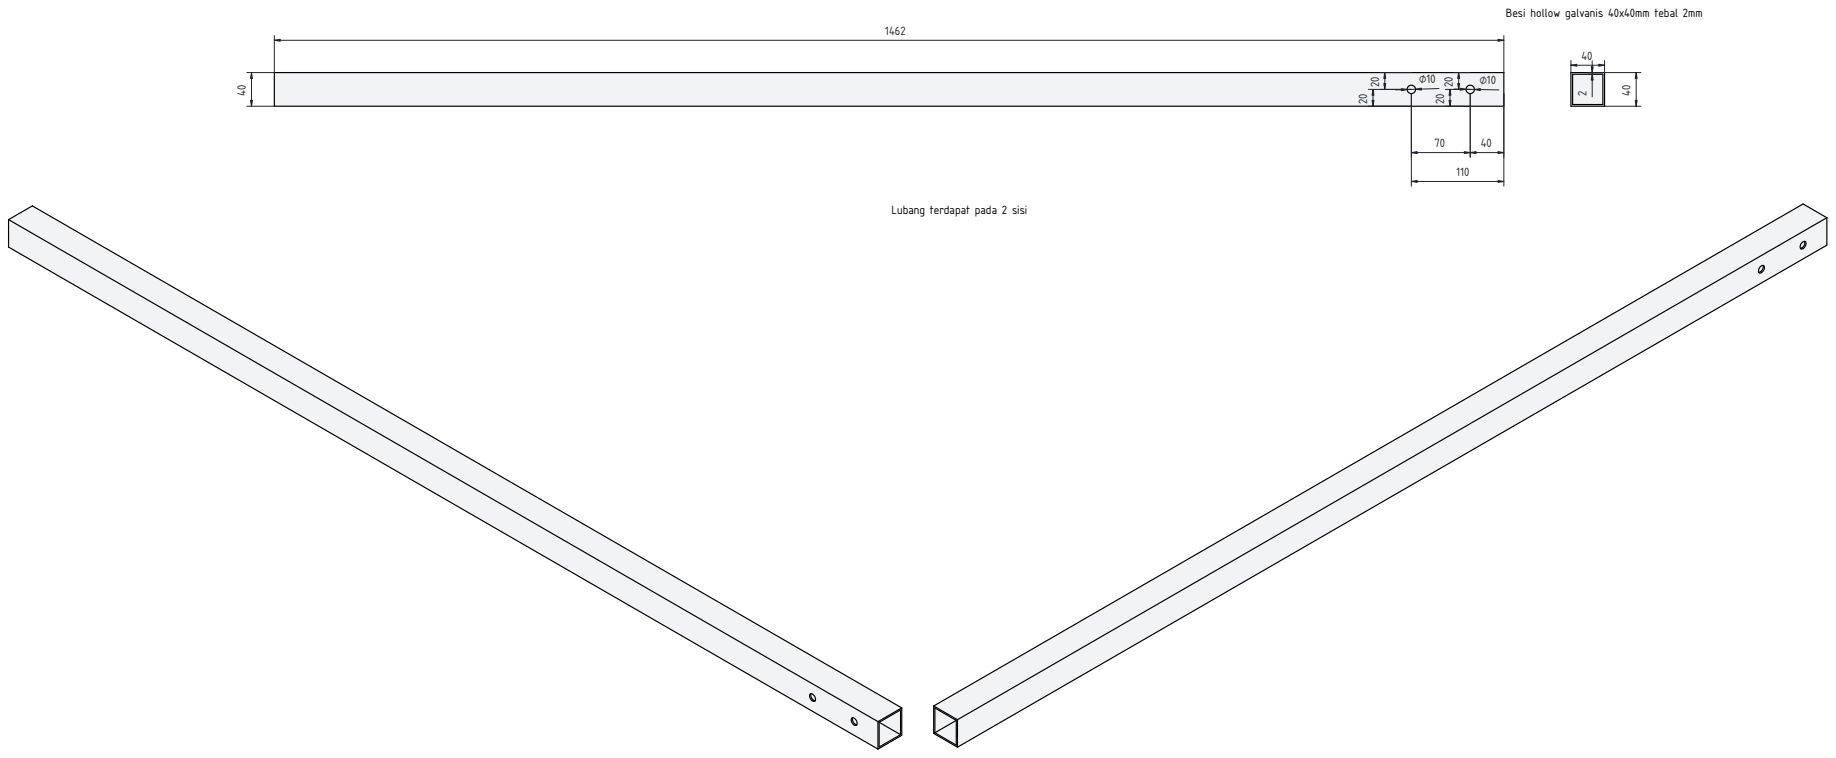
[picture p67: page 1]
g terd
