redfoxxxi/ET_MASTER_CODE/ET MASTER/ET STAND/Sketch/ET STAND-sub leg 1 tech.pdf

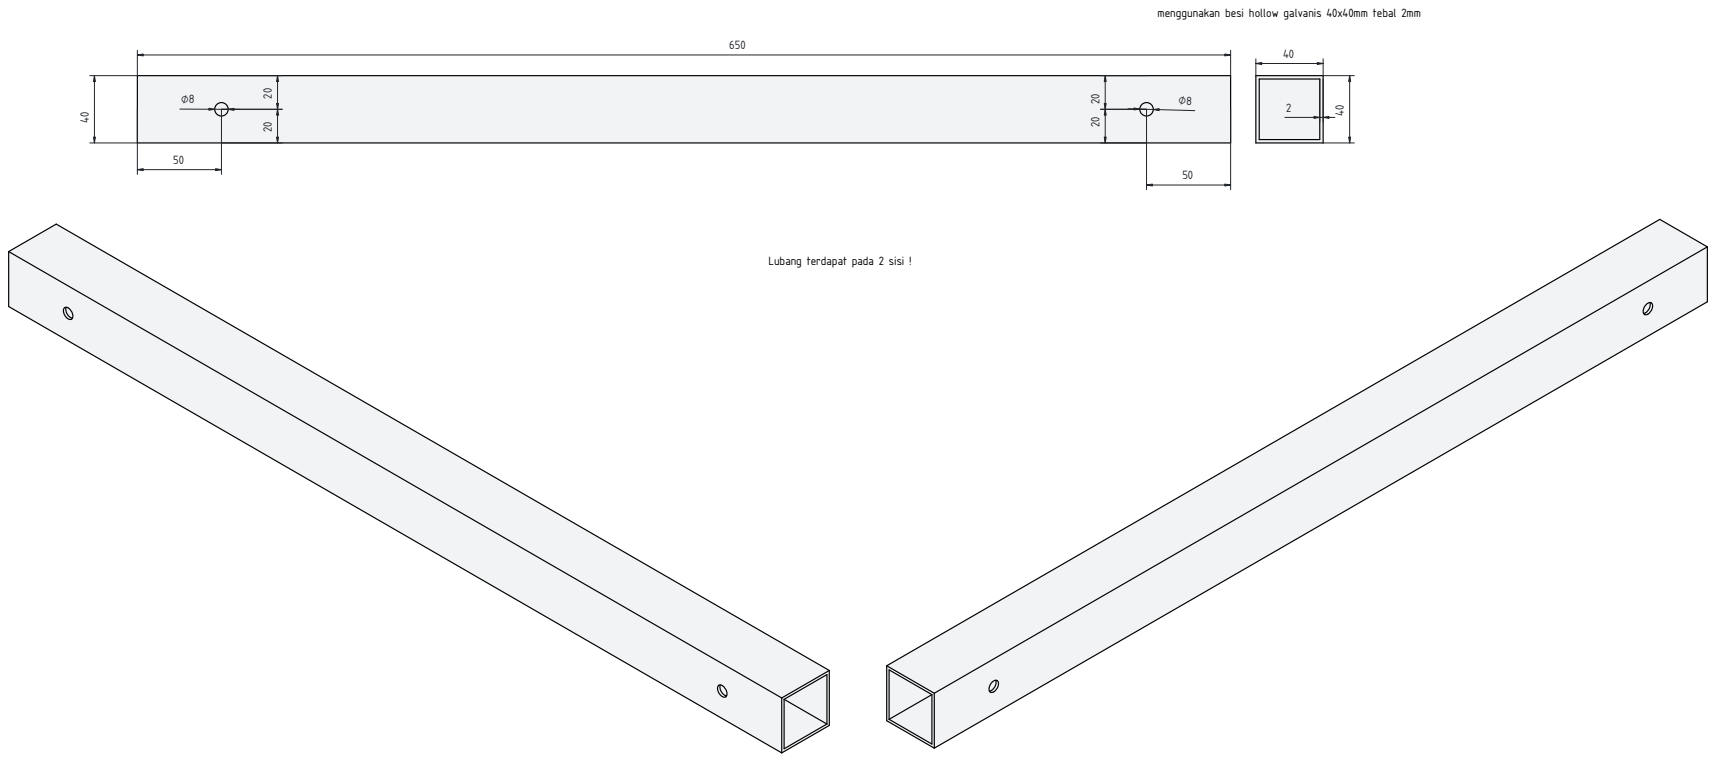
[picture p68: page 1]
g terd; sisi !
