redfoxxxi/ET_MASTER_CODE/ET MASTER/ET STAND/Sketch/ET STAND-sub leg 2 tech.pdf

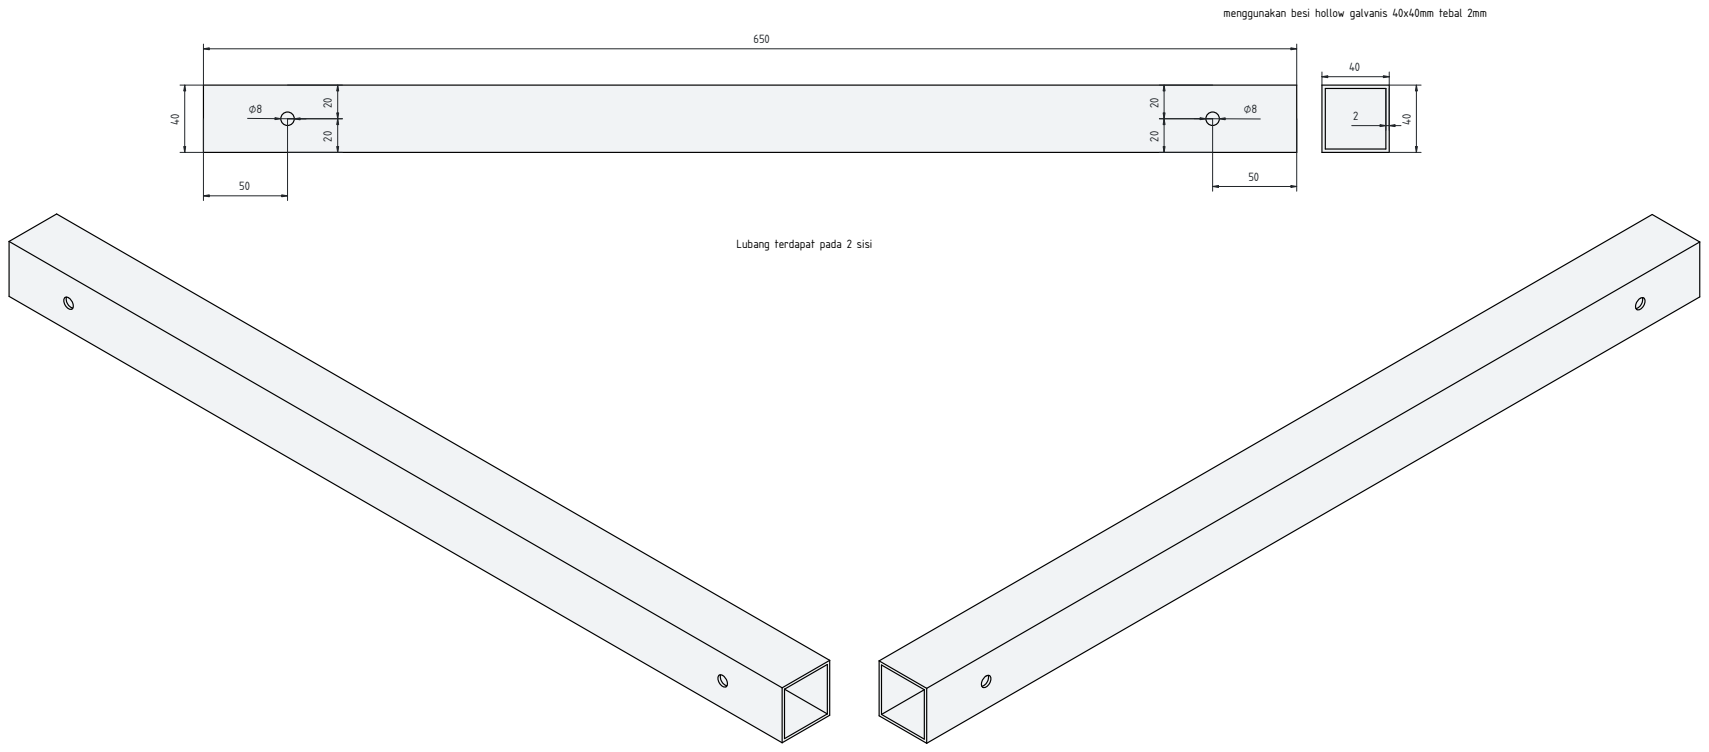
[picture p69: page 1]
g terd
