redfoxxxi/ET_MASTER_CODE/ET MASTER/ET STAND/Sketch/ET STAND-upper support tech.pdf

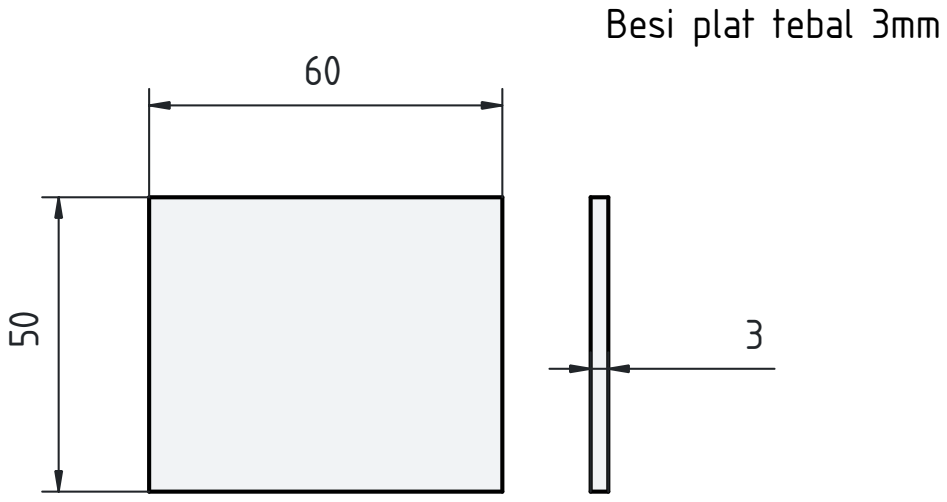
[picture p70: page 1]
si plat te
