redfoxxxi/ET_MASTER_CODE/ET MASTER/Previous Version/Previous version/ET METAL BODY/Parts design/SIDE PLATE B/METAL UNFOLD-SIDE PLATE B preview.pdf

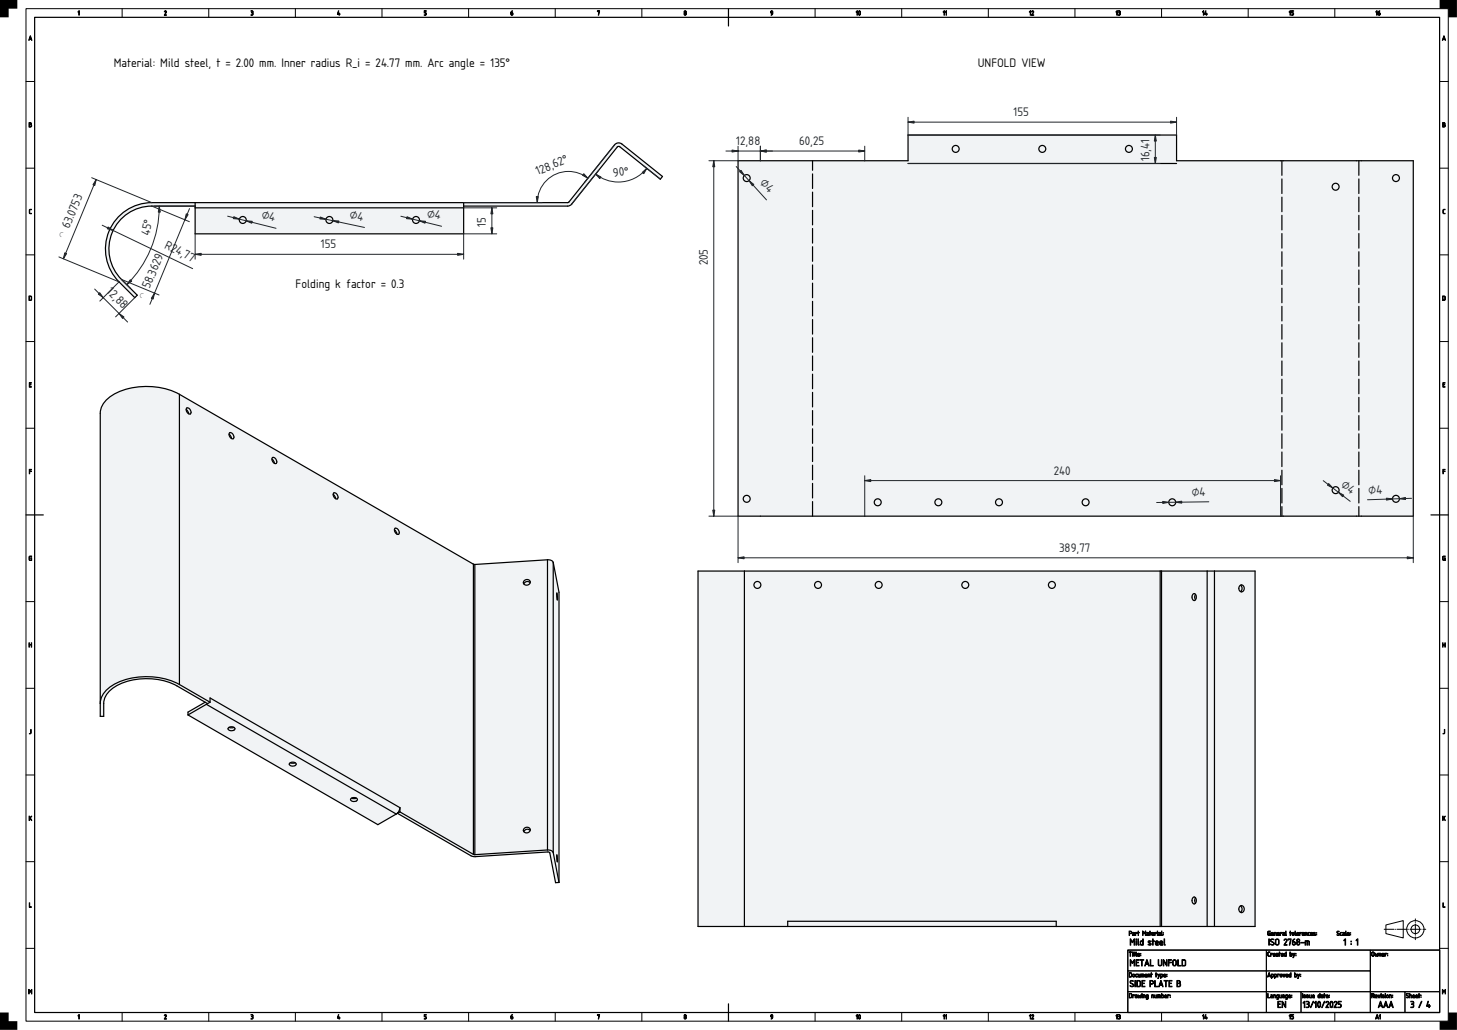
[picture p71: page 1]

0° 12,8 15 155 45° Folding k factor = 0.3 Material: Mild steel, t = 2.00 mm. Inner radius R_i = 24.77 mm. Arc angle = 135° 12,8
