redfoxxxi/ET_MASTER_CODE/ET MASTER/Previous Version/Previous version/ET METAL BODY/Parts design/COLLECTOR/METAL UNFOLD-COLLECTOR preview.pdf

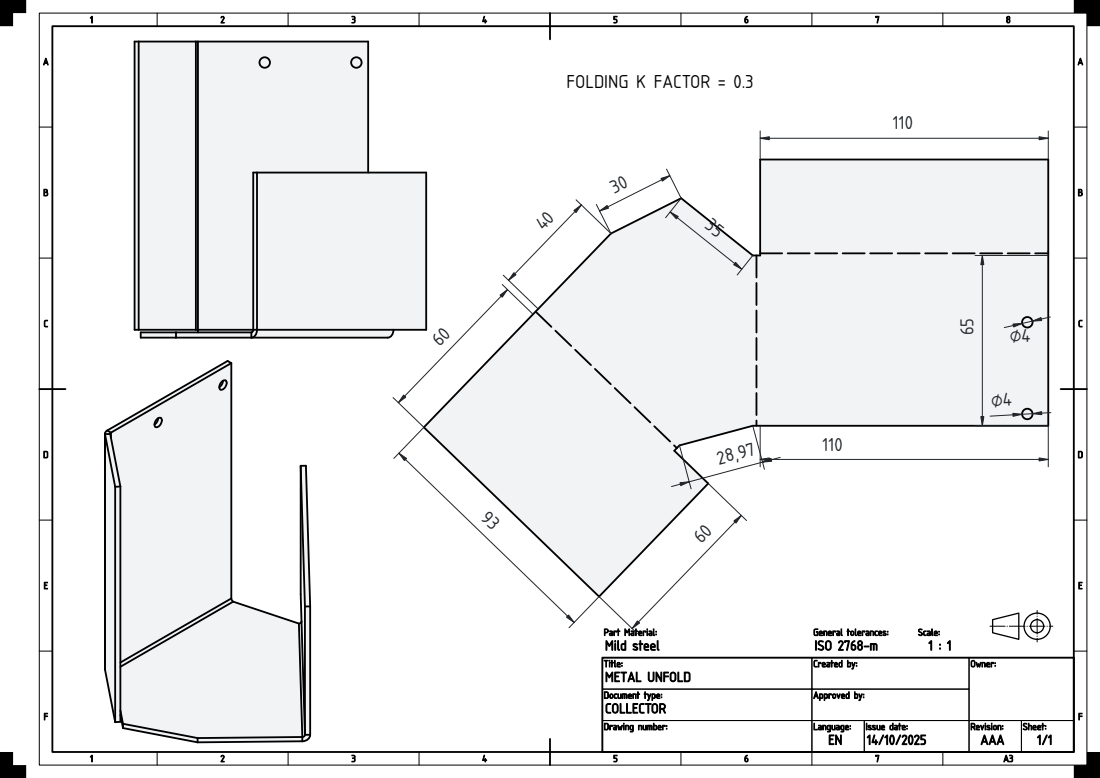
[picture p72: page 1]
FOLDING K FACTOR = 0.3
