redfoxxxi/ET_MASTER_CODE/ET MASTER/Previous Version/Previous version/ET METAL BODY/Parts design/Front plate/METAL UNFOLD-front plate preview.pdf

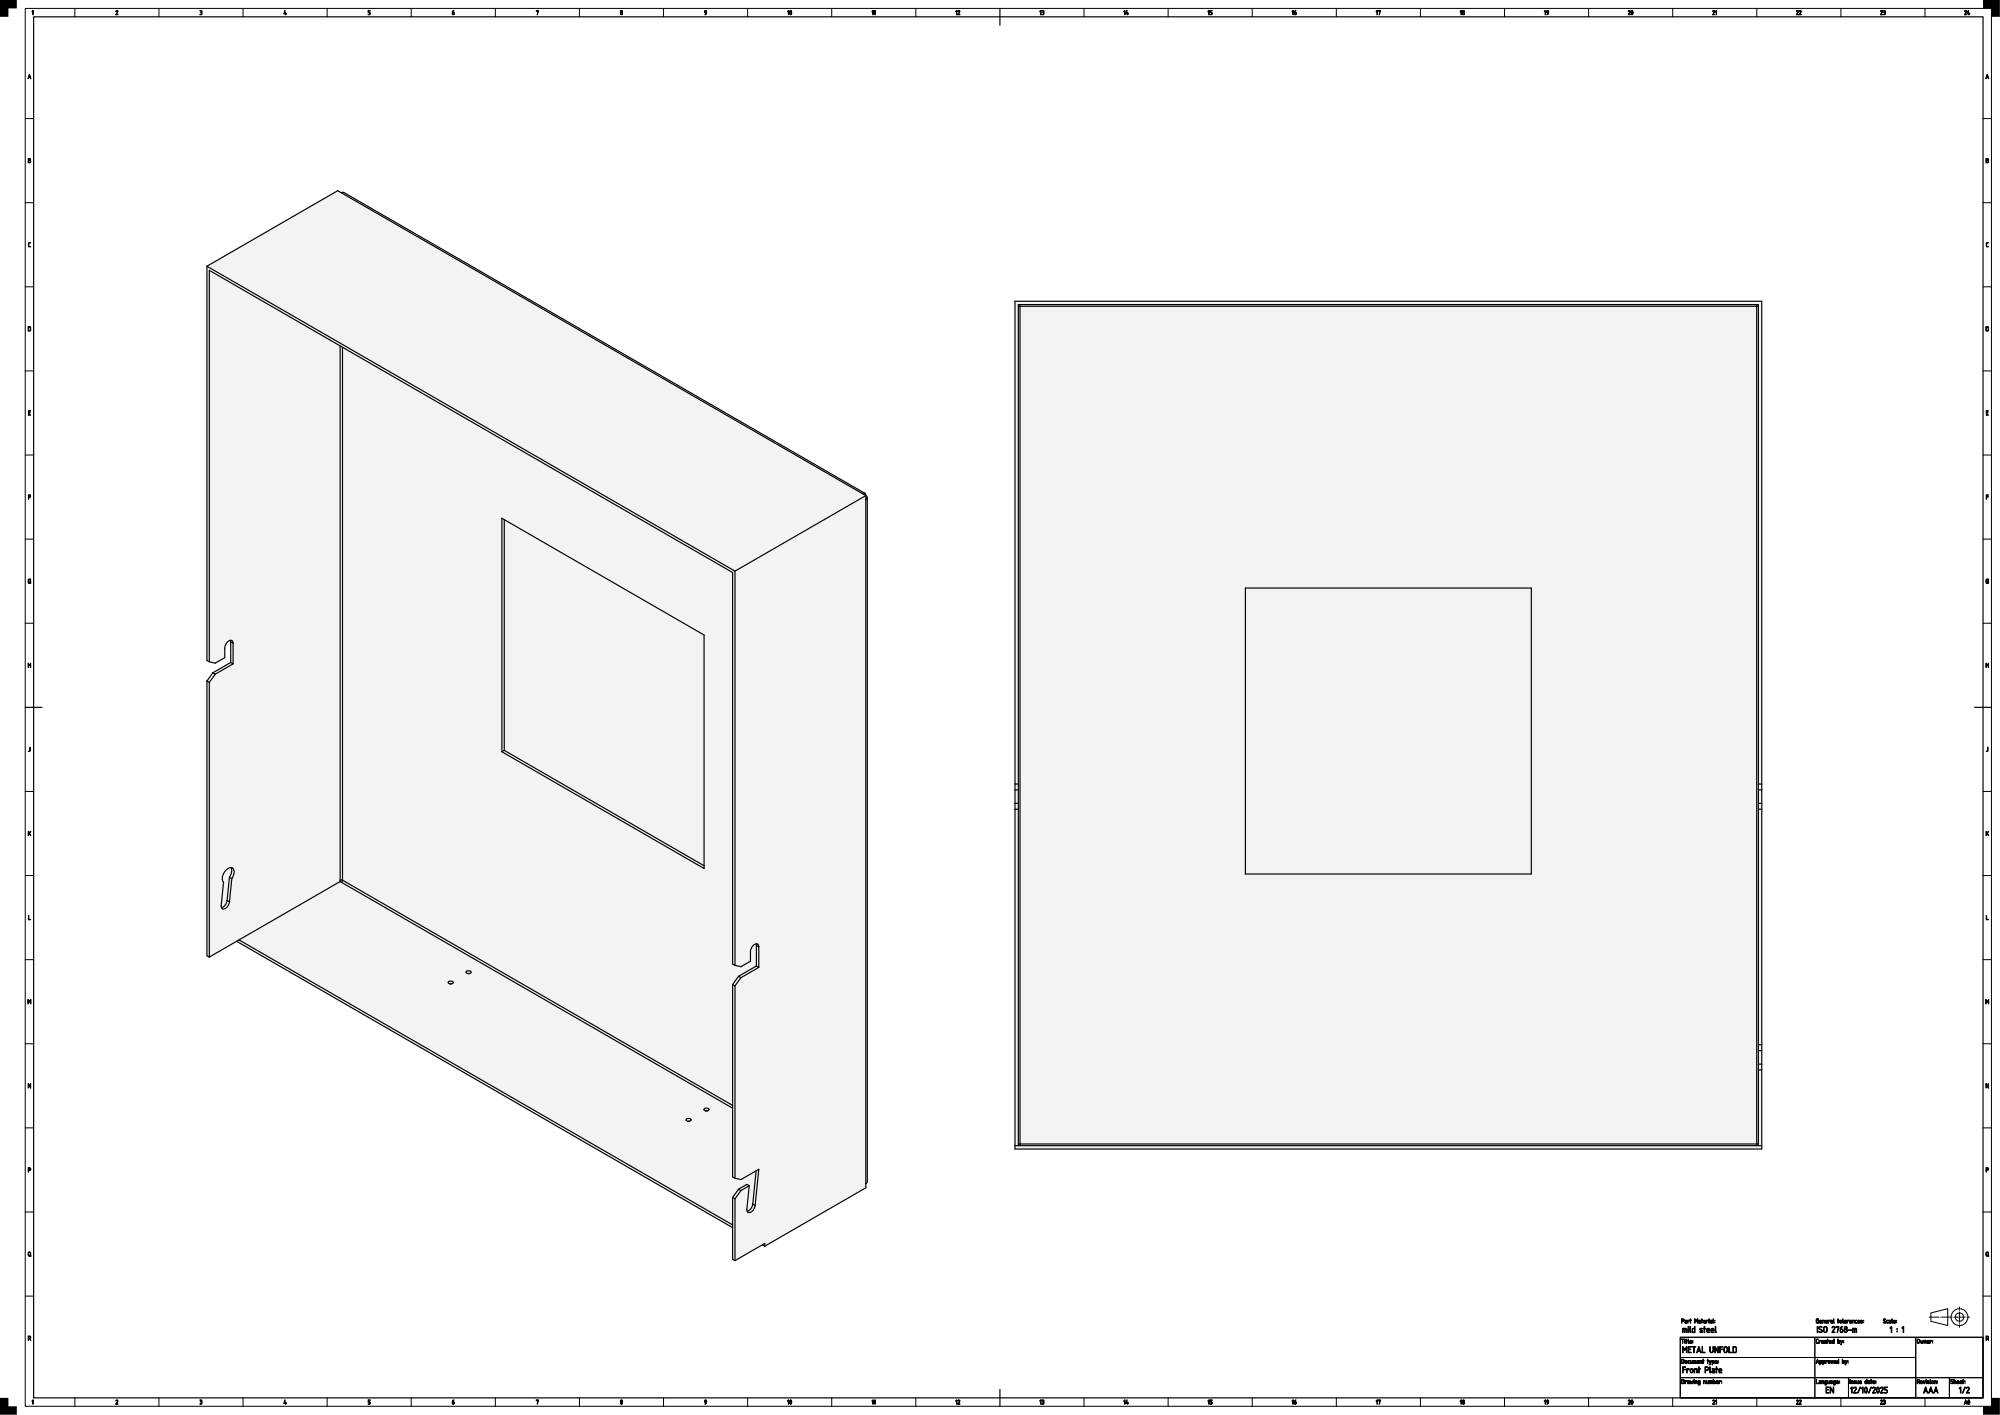
[picture p73: page 1]
