redfoxxxi/ET_MASTER_CODE/ET MASTER/Previous Version/Previous version/ET METAL BODY/Parts design/Front plate/METAL UNFOLD-front plate unfold.pdf

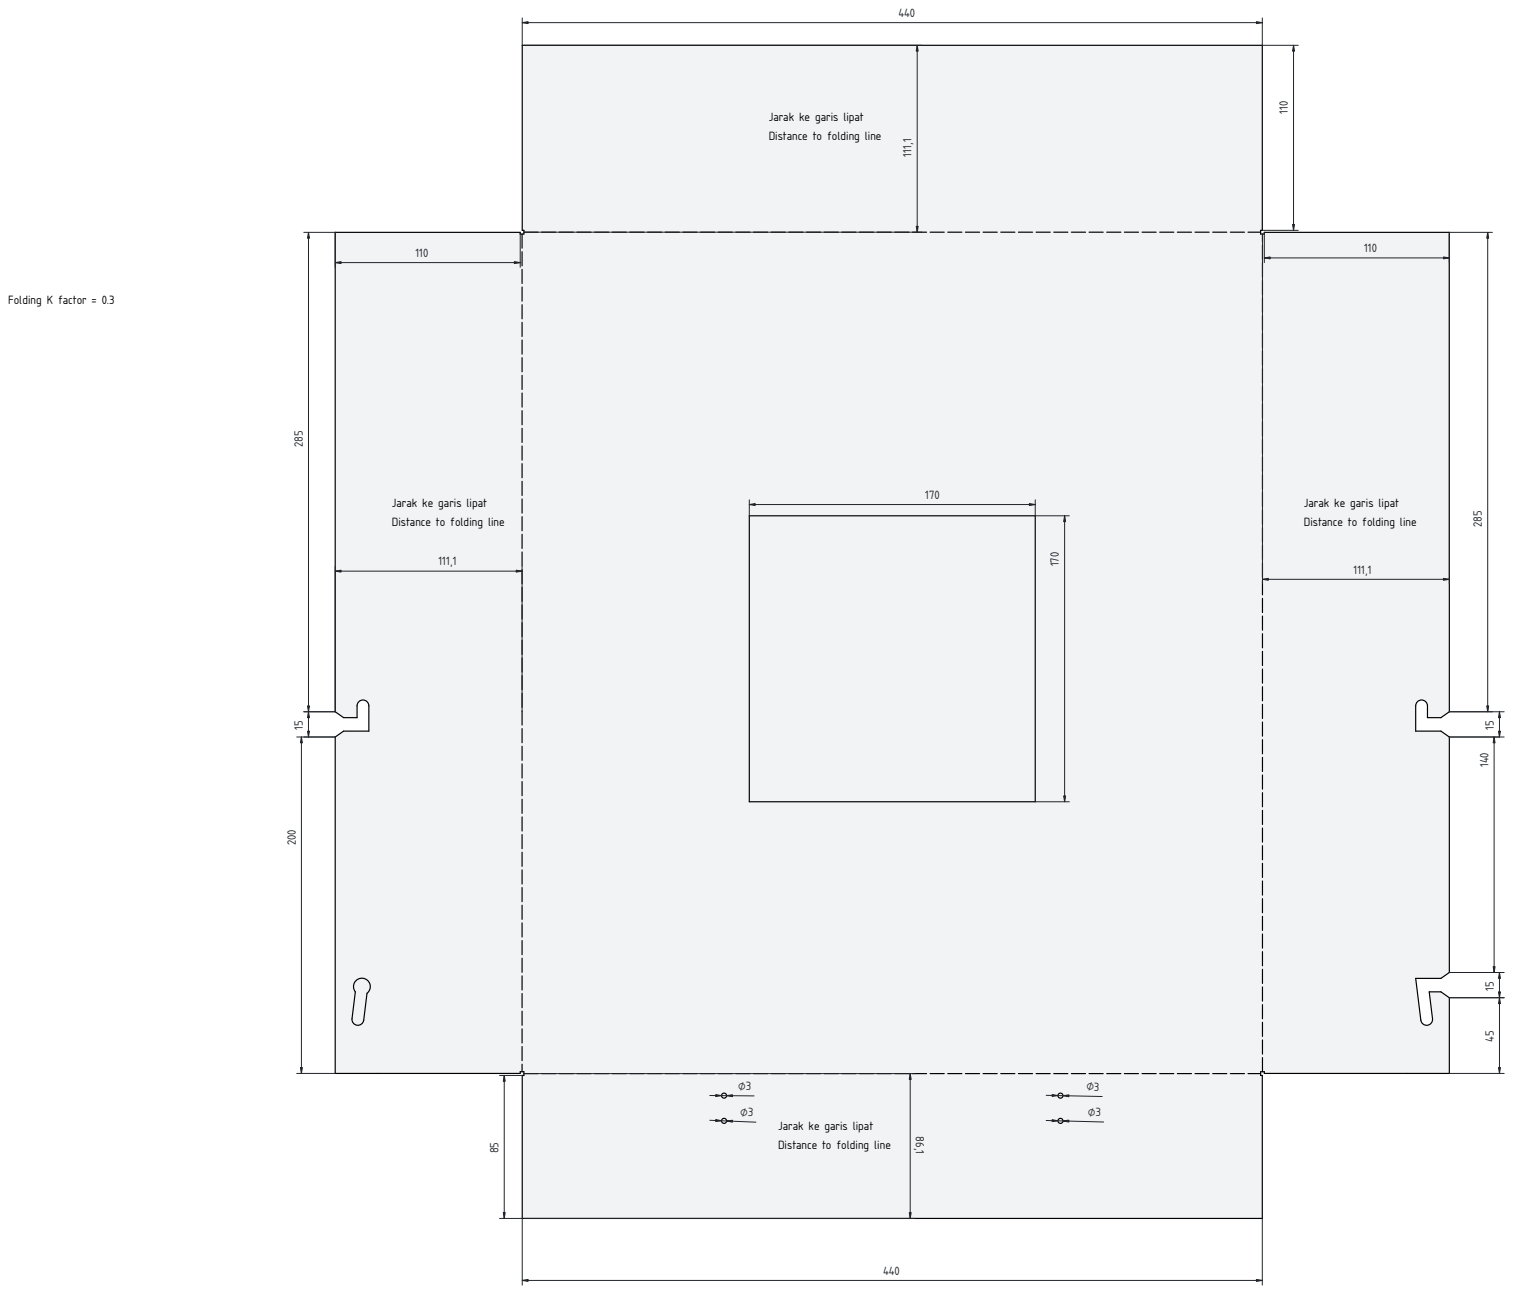
[picture p74: page 1]
Folding K factor = 0.3

Jarak ke garis lipat

Distance to folding line
