redfoxxxi/ET_MASTER_CODE/ET MASTER/Previous Version/Previous version/ET METAL BODY/Parts design/LED STAND 1/METAL UNFOLD-LED STAND preview.pdf

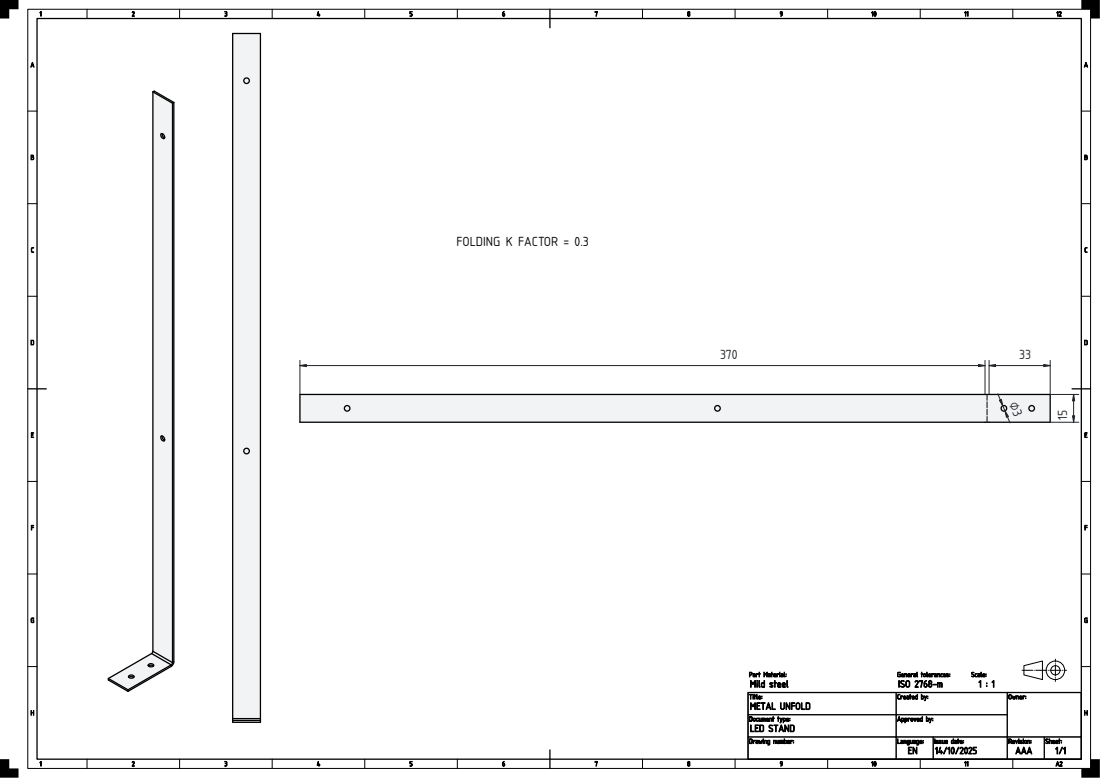
[picture p75: page 1]
FOLDING K FACTOR = 0.3
