redfoxxxi/ET_MASTER_CODE/ET MASTER/Previous Version/Previous version/ET METAL BODY/Parts design/PLATE HOLDER (Mirror)/METAL UNFOLD-PLATE HOLDER (Mirror) preview.pdf

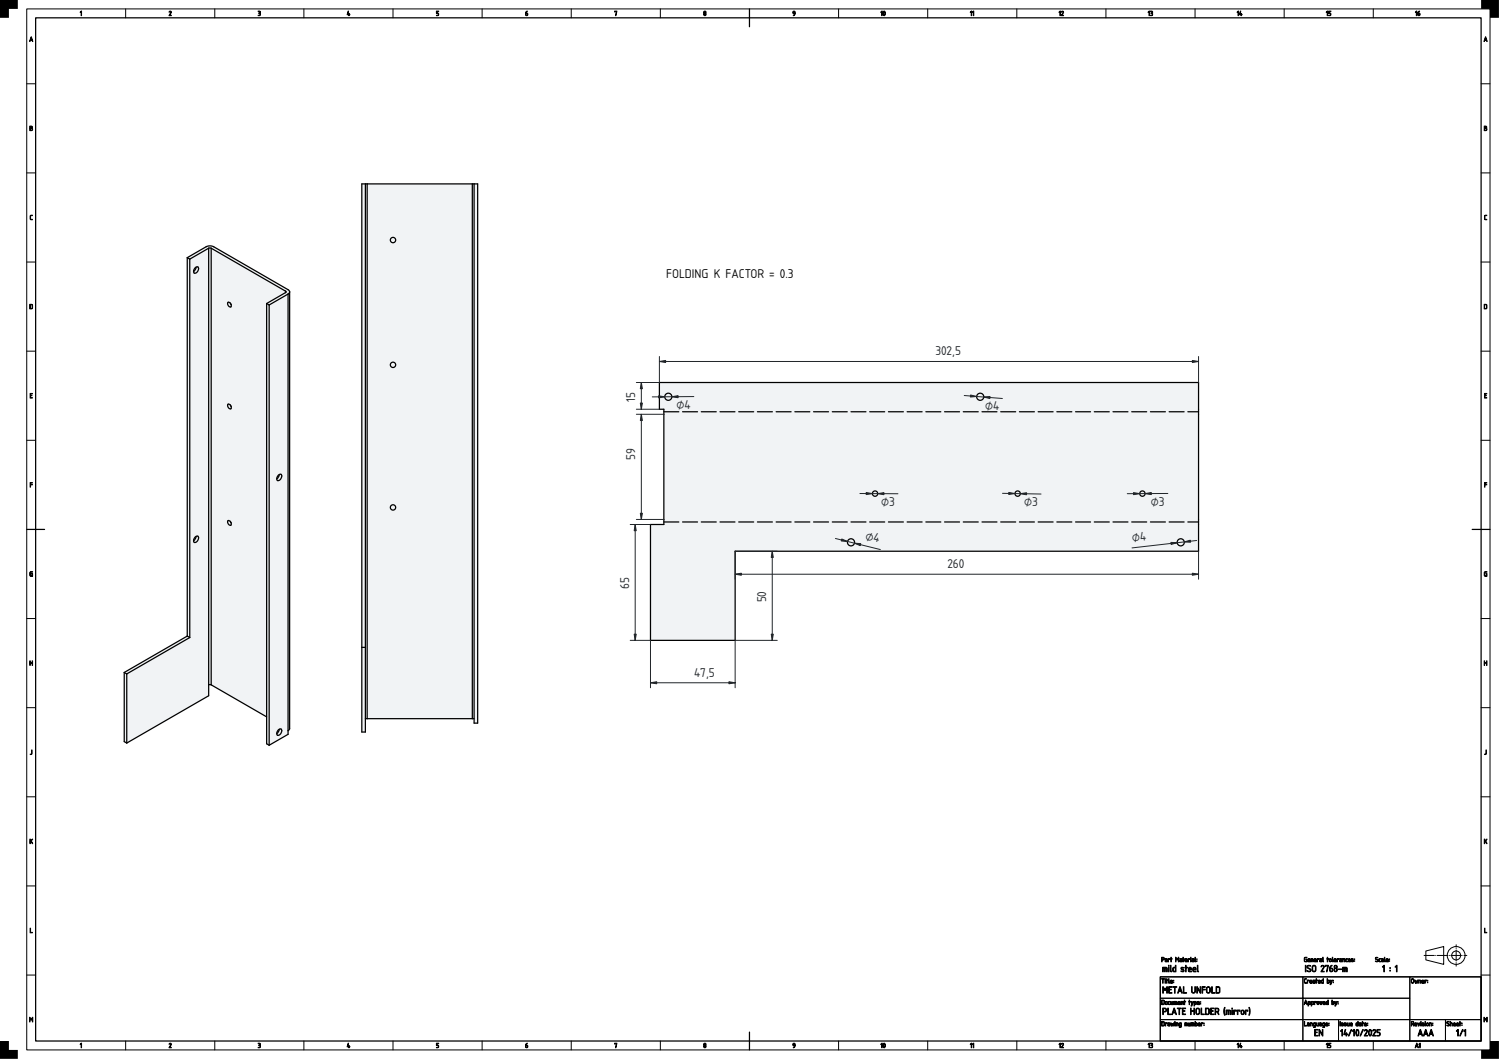
[picture p76: page 1]
FOLDING K FACTOR = 0.3
