redfoxxxi/ET_MASTER_CODE/ET MASTER/Previous Version/Previous version/ET METAL BODY/Parts design/PLATE HOLDER/METAL UNFOLD-PLATE HOLDER preview.pdf

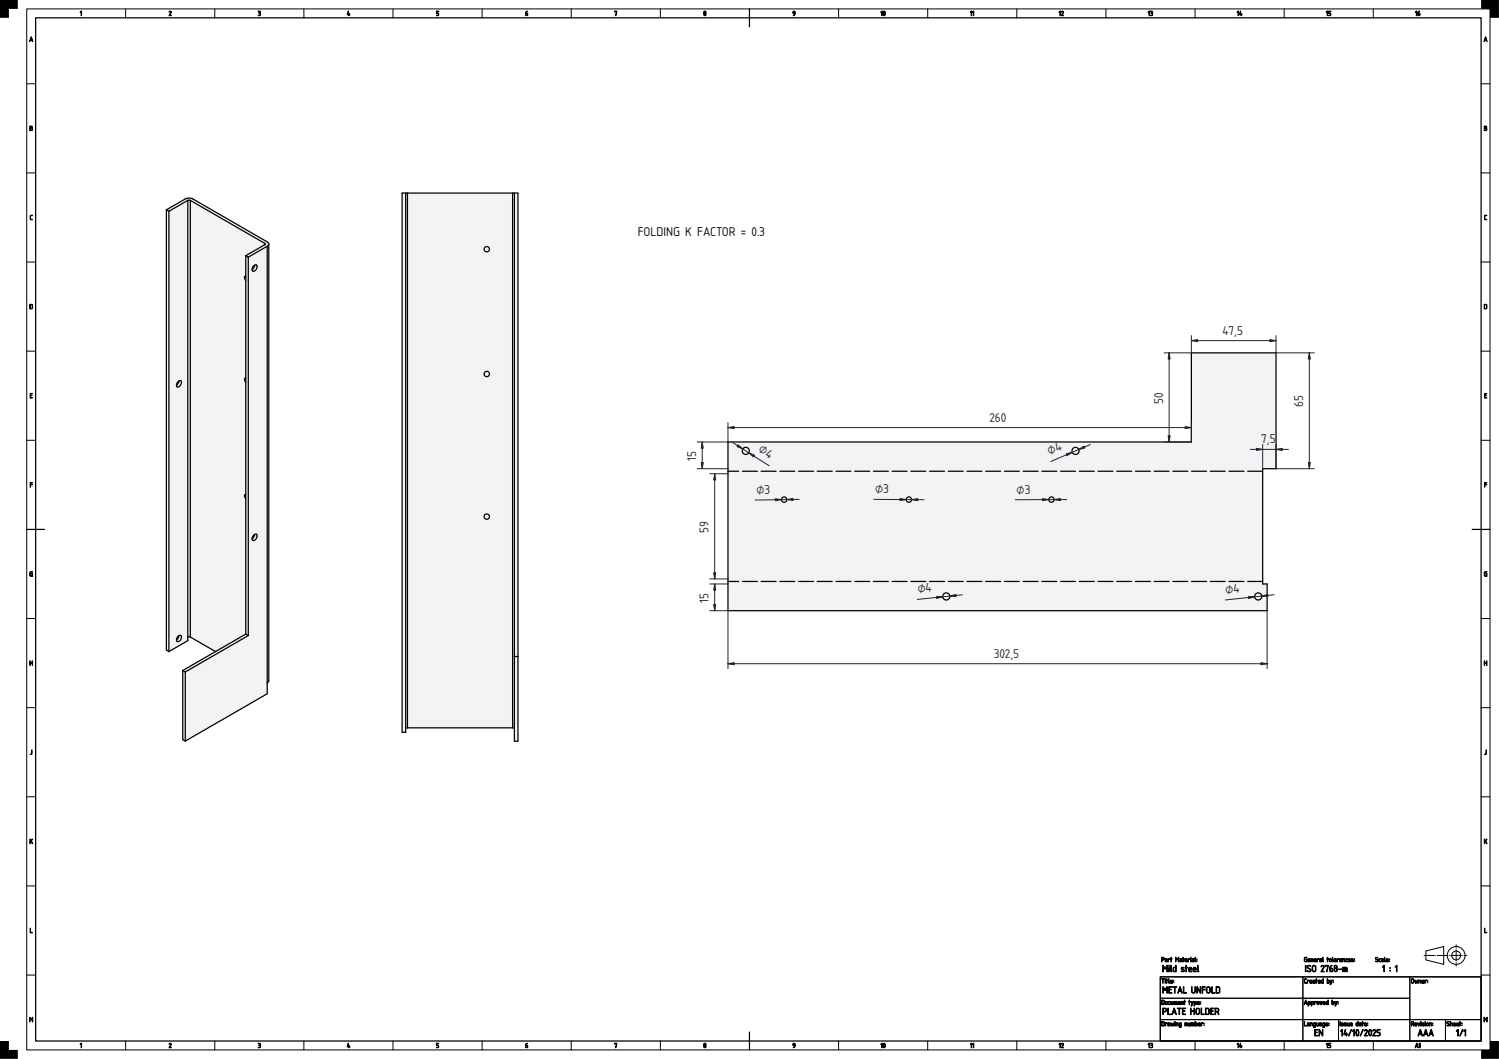
[picture p77: page 1]
FOLDING K FACTOR = 0.3
