redfoxxxi/ET_MASTER_CODE/ET MASTER/Previous Version/Previous version/ET METAL BODY/Parts design/PROTECTOR PLATE/METAL UNFOLD-PROTECTOR PLATE Preview.pdf

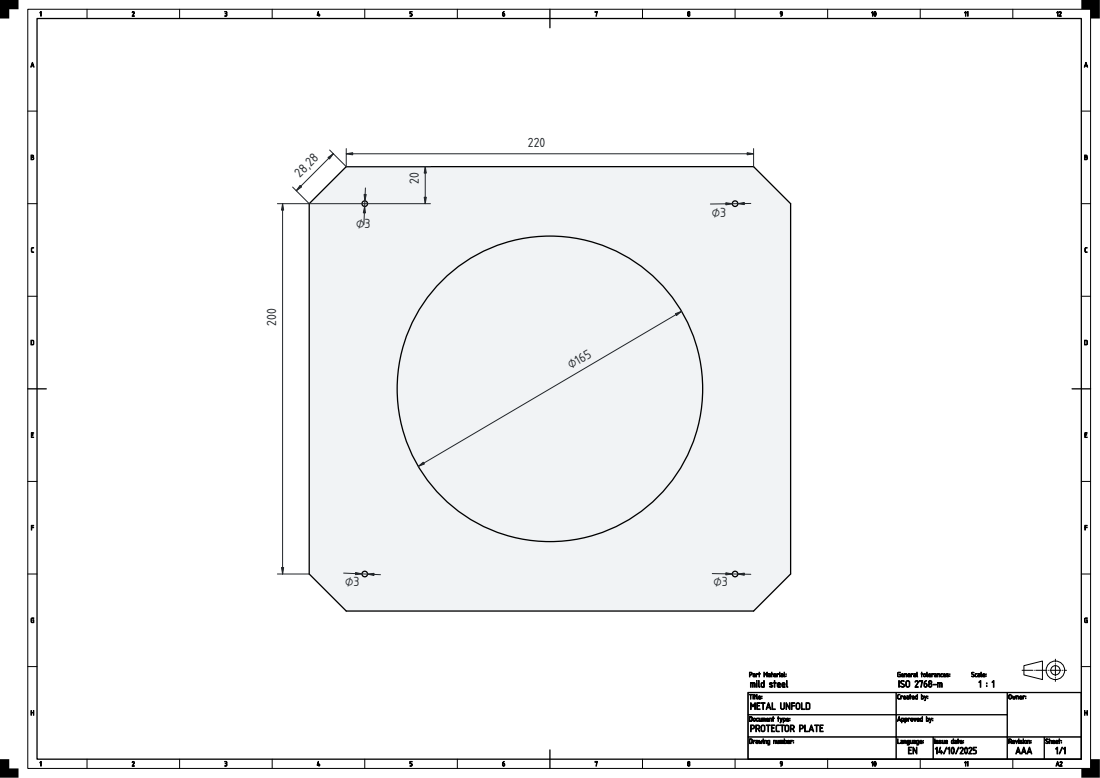
[picture p78: page 1]
