redfoxxxi/ET_MASTER_CODE/ET MASTER/Previous Version/Previous version/ET METAL BODY/Parts design/SIDE PLATE A/METAL UNFOLD-SIDE PLATE A preview.pdf

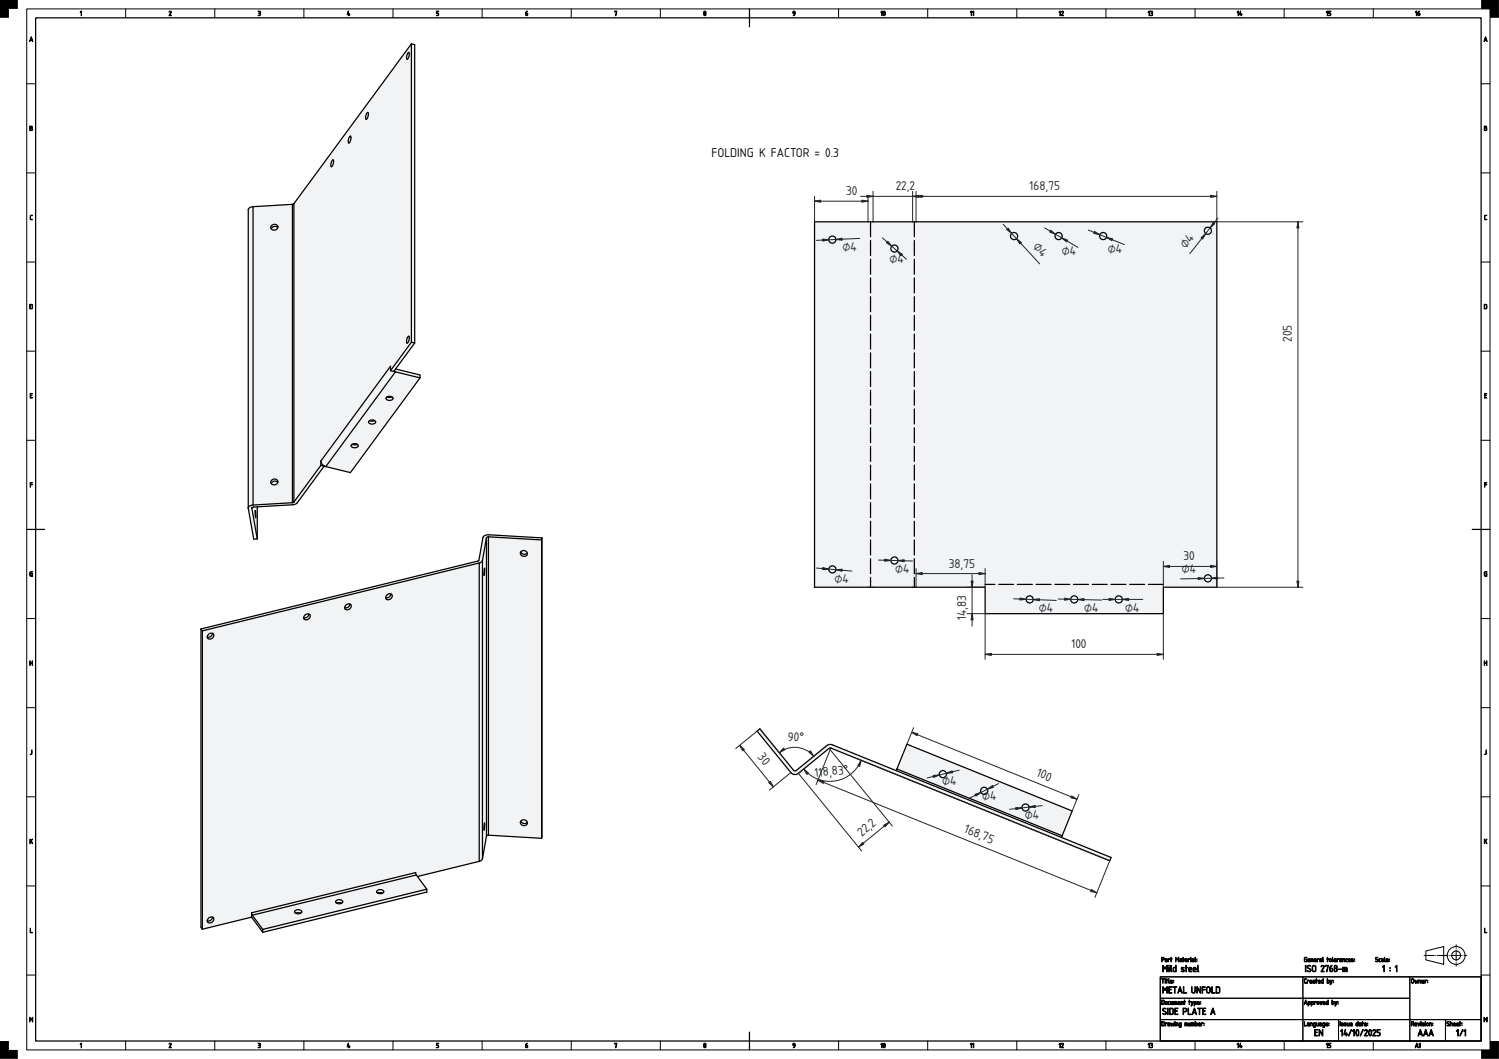
[picture p79: page 1]
FOLDING K FACTOR = 0.3
