redfoxxxi/ET_MASTER_CODE/ET MASTER/Previous Version/Previous version/ET METAL BODY/Parts design/TRAP FOUNDATION/METAL UNFOLD-TRAP FOUNDATION preview.pdf

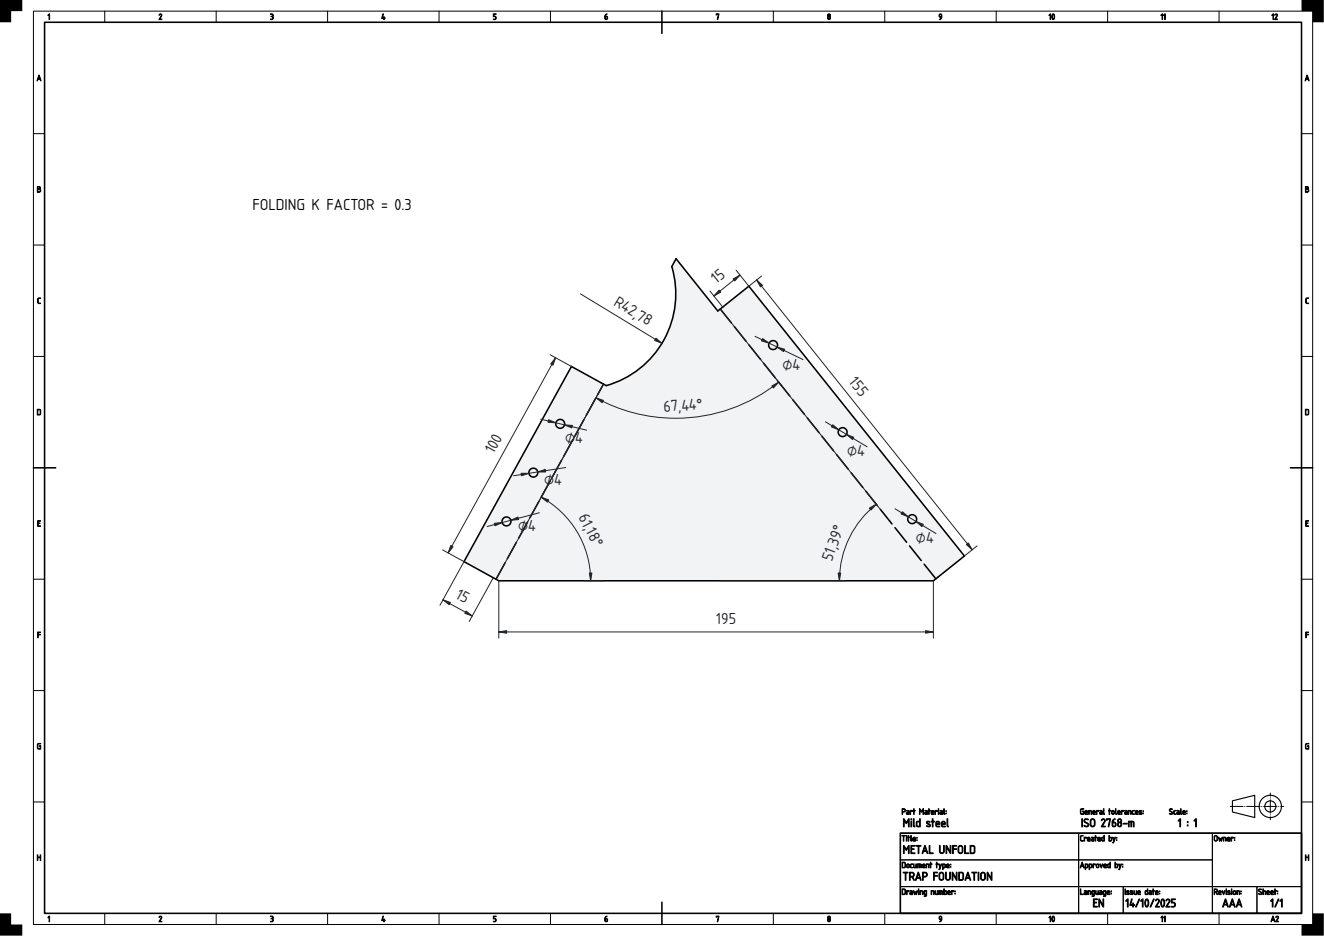
[picture p80: page 1]
FOLDING K FACTOR = 0.3
