redfoxxxi/ET_MASTER_CODE/ET MASTER/Previous Version/Previous version/ET METAL BODY/Parts design/UPPER TRAP/METAL UNFOLD-UPPER TRAP preview.pdf

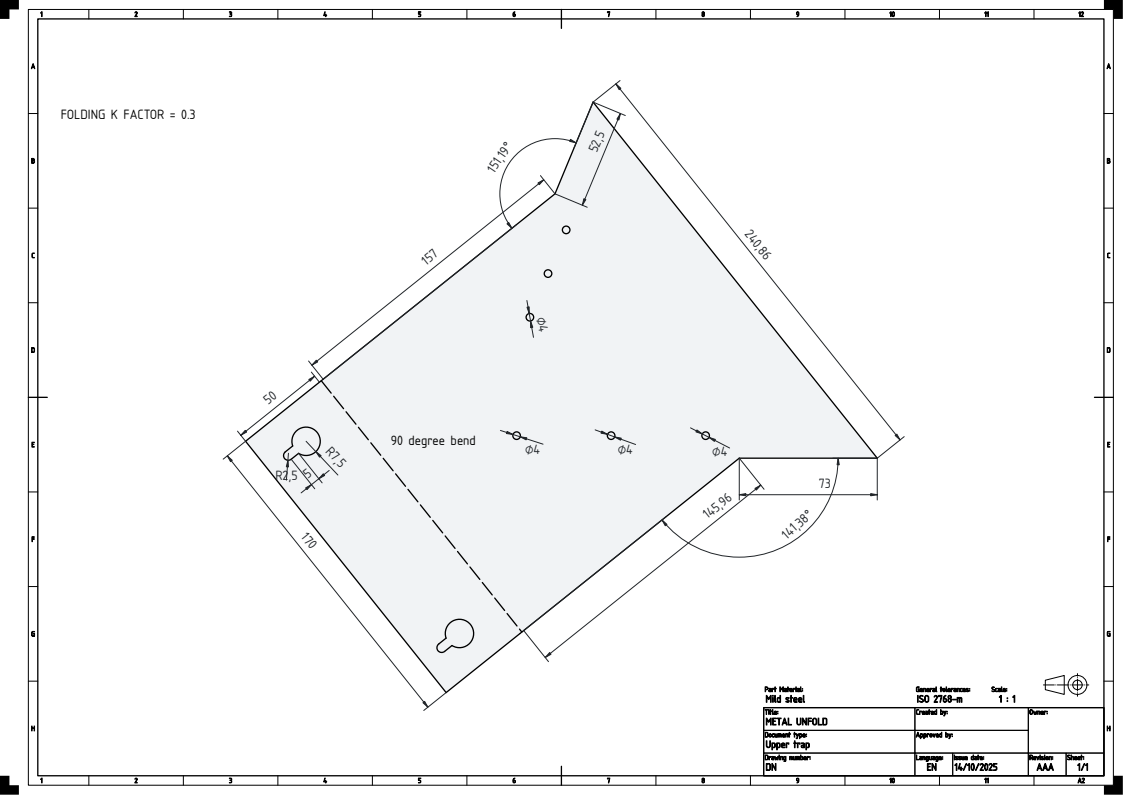
[picture p81: page 1]
