redfoxxxi/ET_MASTER_CODE/Additional unfinished Project/ET LASER SYSTEM/Ethernet.kicad_sch

## KiCad design Additional unfinished Project/ET LASER SYSTEM/Ethernet.kicad_sch (2026-09-12)

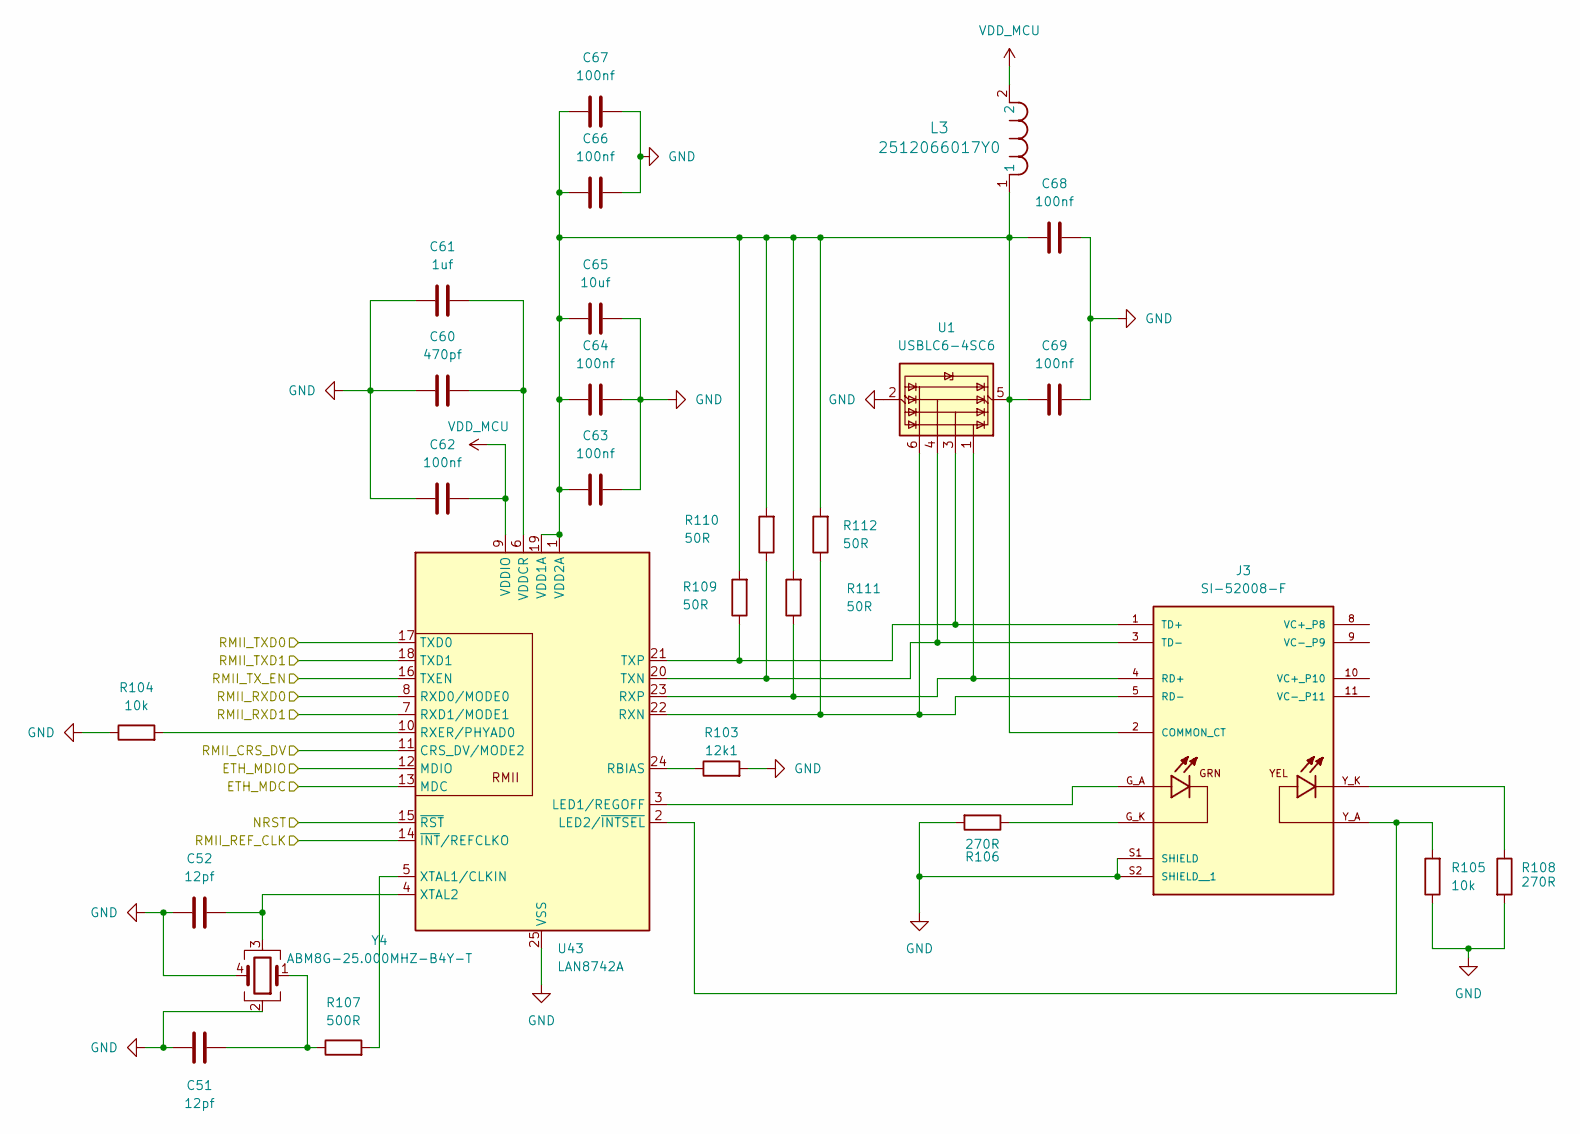
[picture p82: schematic Ethernet.kicad_sch]

Parts:
C51, C52: 12pf
C60: 470pf
C61: 1uf
C62, C63, C64, C66, C67, C68, C69: 100nf
C65: 10uf
J3: SI-52008-F; BEL_SI-52008-F; PARTREV B1
L3: 2512066017Y0; L_1206_3216Metric
R103: 12k1; R_0603_1608Metric
R104, R105: 10k; R_0603_1608Metric
R106, R108: 270R; R_0603_1608Metric
R107: 500R; R_0603_1608Metric
R109, R110, R111, R112: 50R; R_0603_1608Metric
U1: USBLC6-4SC6; SOT-23-6
U43: LAN8742A; VQFN-24-1EP_4x4mm_P0.5mm_EP2.5x2.5mm_ThermalVias
Y4: ABM8G-25.000MHZ-B4Y-T; Crystal_SMD_Abracon_ABM10-4Pin_2.5x2.0mm

Connections:
ETH_MDC: U43.13 (MDC)
ETH_MDIO: U43.12 (MDIO)
GND: C51.1, C52.1, C60.1, C61.1, C62.1, C63.2, C64.2, C65.2, C66.2, C67.2, C68.2, C69.2, J3.S1 (SHIELD), J3.S2 (SHIELD__1), R103.2, R104.1, R105.1, R106.2, R108.2, U1.2 (GND), U43.25 (VSS), Y4.2, Y4.4
NRST: U43.15 (~RST)
unnamed: C51.2, R107.1, Y4.1
unnamed: C52.2, U43.4 (XTAL2), Y4.3
unnamed: C60.2, C61.2, U43.6 (VDDCR)
unnamed: C63.1, C64.1, C65.1, C66.1, C67.1, C68.1, C69.1, J3.2 (COMMON_CT), L3.1, R109.2, R110.2, R111.2, R112.2, U1.5 (VBUS), U43.1 (VDD2A), U43.19 (VDD1A)
unnamed: J3.1 (TD+), R109.1, U1.3 (I/O2), U43.21 (TXP)
unnamed: J3.3 (TD-), R110.1, U1.4 (I/O3), U43.20 (TXN)
unnamed: J3.4 (RD+), R111.1, U1.1 (I/O1), U43.23 (RXP)
unnamed: J3.5 (RD-), R112.1, U1.6 (I/O4), U43.22 (RXN)
unnamed: J3.G_A, U43.3 (LED1/REGOFF)
unnamed: J3.G_K, R106.1
unnamed: J3.Y_A, R105.2, U43.2 (LED2/~INTSEL)
unnamed: J3.Y_K, R108.1
unnamed: R103.1, U43.24 (RBIAS)
unnamed: R104.2, U43.10 (RXER/PHYAD0)
unnamed: R107.2, U43.5 (XTAL1/CLKIN)
RMII_CRS_DV: U43.11 (CRS_DV/MODE2)
RMII_REF_CLK: U43.14 (~INT/REFCLKO)
RMII_RXD0: U43.8 (RXD0/MODE0)
RMII_RXD1: U43.7 (RXD1/MODE1)
RMII_TXD0: U43.17 (TXD0)
RMII_TXD1: U43.18 (TXD1)
RMII_TX_EN: U43.16 (TXEN)
VDD_MCU: C62.2, L3.2, U43.9 (VDDIO)
