redfoxxxi/ET_MASTER_CODE/Additional unfinished Project/ET LASER SYSTEM/MCU.kicad_sch

## KiCad design Additional unfinished Project/ET LASER SYSTEM/MCU.kicad_sch (2026-09-12)

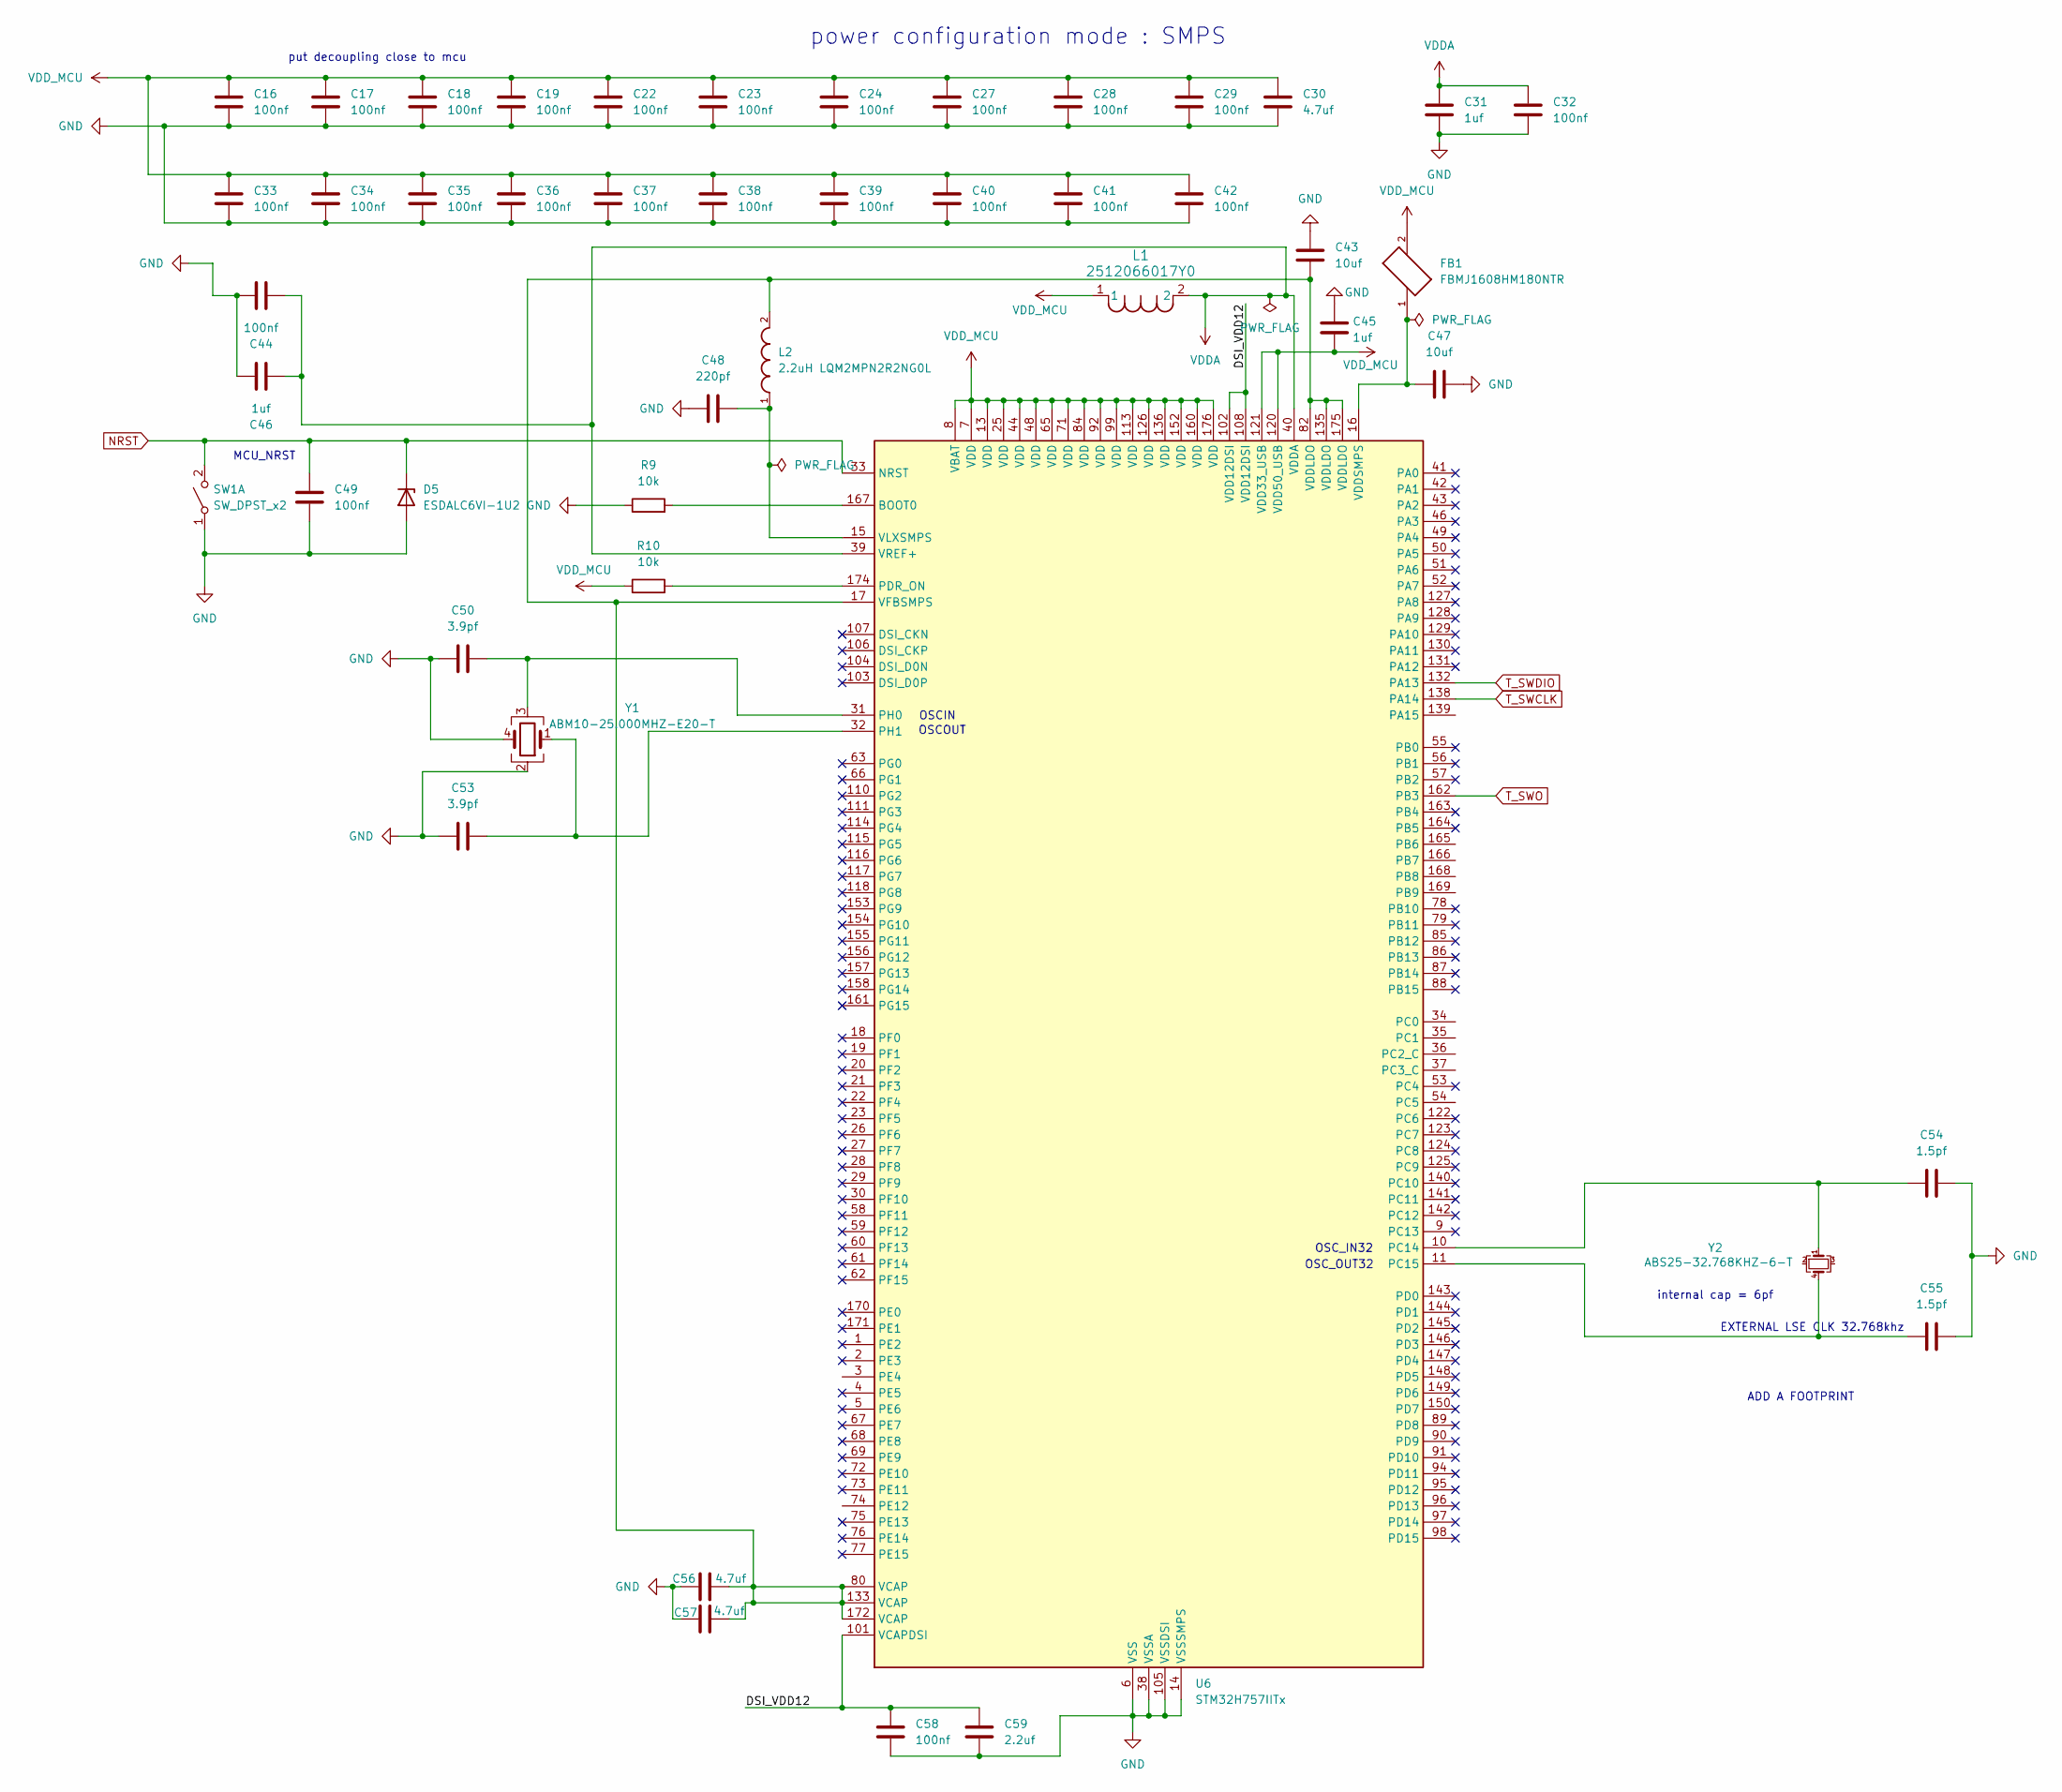
[picture p83: schematic MCU.kicad_sch]

Parts:
C16, C17, C18, C19, C22, C23, C24, C27, C28, C29, C32, C33, C34, C35, C36, C37, C38, C39, C40, C41, C42, C44, C49, C58: 100nf; C_0603_1608Metric
C30: 4.7uf; C_1206_3216Metric
C31, C45, C46: 1uf; C_0805_2012Metric
C43, C47: 10uf; C_1210_3225Metric
C48: 220pf; C_0402_1005Metric
C50, C53: 3.9pf; C_0402_1005Metric
C54, C55: 1.5pf; C_01005_0402Metric
C56, C57: 4.7uf; C_0805_2012Metric
C59: 2.2uf; C_0603_1608Metric
D5: ESDALC6VI-1U2; D_SOD-523
FB1: FBMJ1608HM180NTR; BEADC1608X100N
L1: 2512066017Y0; L_1206_3216Metric
L2: 2.2uH LQM2MPN2R2NG0L; INDC2016X100N
R9, R10: 10k; R_0603_1608Metric
SW1: SW_DPST_x2; SW_SPST_PTS647_Sx38
U6: STM32H757IITx; LQFP-176_24x24mm_P0.5mm
Y1: ABM10-25.000MHZ-E20-T; Crystal_SMD_Abracon_ABM10-4Pin_2.5x2.0mm
Y2: ABS25-32.768KHZ-6-T; Crystal_SMD_Abracon_ABS25-4Pin_8.0x3.8mm

Connections:
DSI_VDD12: C58.1, C59.1, U6.101 (VCAPDSI), U6.102 (VDD12DSI), U6.108 (VDD12DSI)
GND: C16.2, C17.2, C18.2, C19.2, C22.2, C23.2, C24.2, C27.2, C28.2, C29.2, C30.2, C31.2, C32.2, C33.2, C34.2, C35.2, C36.2, C37.2, C38.2, C39.2, C40.2, C41.2, C42.2, C43.1, C44.2, C45.1, C46.2, C47.2, C48.1, C49.2, C50.1, C53.1, C54.1, C55.1, C56.1, C57.1, C58.2, C59.2, D5.2 (A), R9.1, SW1.1 (A), U6.6 (VSS), U6.12 (VSS), U6.14 (VSSSMPS), U6.24 (VSS), U6.38 (VSSA), U6.45 (VSS), U6.47 (VSS), U6.64 (VSS), U6.70 (VSS), U6.81 (VSS), U6.83 (VSS), U6.93 (VSS), U6.100 (VSS), U6.105 (VSSDSI), U6.109 (VSSDSI), U6.112 (VSS), U6.119 (VSS), U6.134 (VSS), U6.137 (VSS), U6.151 (VSS), U6.159 (VSS), U6.173 (VSS), Y1.2, Y1.4
NRST: C49.1, D5.1 (K), SW1.2 (B), U6.33 (NRST)
unnamed: C43.2, C56.2, C57.2, L2.2, U6.17 (VFBSMPS), U6.80 (VCAP), U6.82 (VDDLDO), U6.133 (VCAP), U6.135 (VDDLDO), U6.172 (VCAP), U6.175 (VDDLDO)
unnamed: C47.1, FB1.1, U6.16 (VDDSMPS)
unnamed: C48.2, L2.1, U6.15 (VLXSMPS)
unnamed: C50.2, U6.31 (PH0), Y1.3
unnamed: C53.2, U6.32 (PH1), Y1.1
unnamed: C54.2, U6.10 (PC14), Y2.1
unnamed: C55.2, U6.11 (PC15), Y2.4
unnamed: R9.2, U6.167 (BOOT0)
unnamed: R10.2, U6.174 (PDR_ON)
T_SWCLK: U6.138 (PA14)
T_SWDIO: U6.132 (PA13)
T_SWO: U6.162 (PB3)
VDDA: C31.1, C32.1, C44.1, C46.1, L1.2, U6.39 (VREF+), U6.40 (VDDA)
VDD_MCU: C16.1, C17.1, C18.1, C19.1, C22.1, C23.1, C24.1, C27.1, C28.1, C29.1, C30.1, C33.1, C34.1, C35.1, C36.1, C37.1, C38.1, C39.1, C40.1, C41.1, C42.1, C45.2, FB1.2, L1.1, R10.1, U6.7 (VDD), U6.8 (VBAT), U6.13 (VDD), U6.25 (VDD), U6.44 (VDD), U6.48 (VDD), U6.65 (VDD), U6.71 (VDD), U6.84 (VDD), U6.92 (VDD), U6.99 (VDD), U6.113 (VDD), U6.120 (VDD50_USB), U6.121 (VDD33_USB), U6.126 (VDD), U6.136 (VDD), U6.152 (VDD), U6.160 (VDD), U6.176 (VDD)

Notes on the sheet:
internal cap = 6pf
OSCIN
OSCOUT
MCU_NRST
ADD A FOOTPRINT
EXTERNAL LSE CLK 32.768khz
OSC_OUT32
OSC_IN32
put decoupling close to mcu
power configuration mode : SMPS
