redfoxxxi/ET_MASTER_CODE/Additional unfinished Project/ET LASER SYSTEM/PDSensor.kicad_sch

## KiCad design Additional unfinished Project/ET LASER SYSTEM/PDSensor.kicad_sch (2026-09-12)

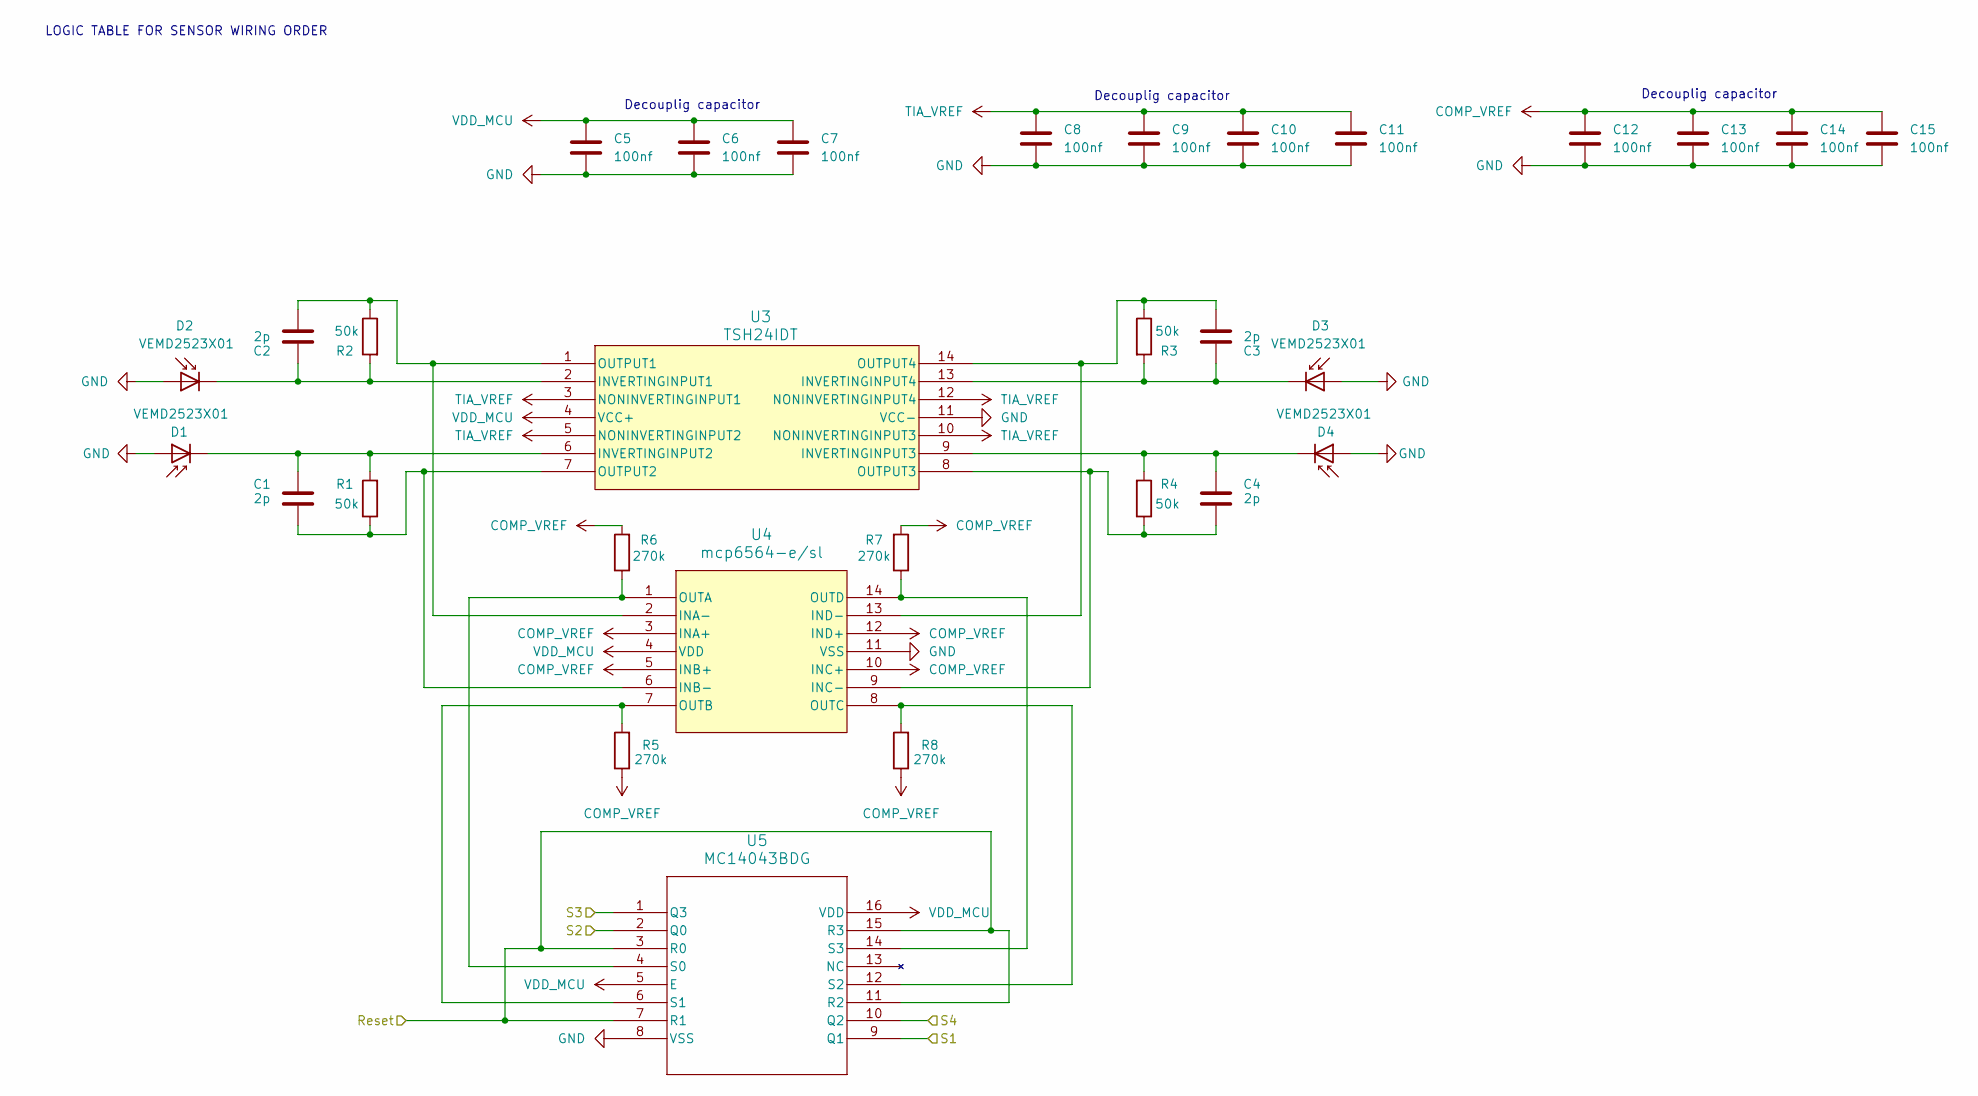
[picture p84: schematic PDSensor.kicad_sch]

Parts:
C1, C2, C3, C4: 2p; C_0402_1005Metric
C5, C6, C7, C8, C9, C10, C11, C12, C13, C14, C15: 100nf; C_0603_1608Metric
D1, D2, D3, D4: VEMD2523X01; 6p544-5410p02-4_VIS
R1, R2, R3, R4: 50k; R_0402_1005Metric
R5, R6, R7, R8: 270k; R_0603_1608Metric
U3: TSH24IDT; SO-G14G3_STM
U4: mcp6564-e/sl; SOIC-14_3.9x8.7mm_P1.27mm
U5: MC14043BDG; SOIC-16_3.9x9.9mm_P1.27mm

Connections:
COMP_VREF: C12.1, C13.1, C14.1, C15.1, R5.1, R6.2, R7.2, R8.1, U4.3 (INA+), U4.5 (INB+), U4.10 (INC+), U4.12 (IND+)
GND: C5.2, C6.2, C7.2, C8.2, C9.2, C10.2, C11.2, C12.2, C13.2, C14.2, C15.2, D1.2 (A), D2.2 (A), D3.2 (A), D4.2 (A), U3.11 (VCC-), U4.11 (VSS), U5.8 (VSS)
unnamed: C1.1, R1.1, U3.7 (OUTPUT2), U4.6 (INB-)
unnamed: C1.2, D1.1 (K), R1.2, U3.6 (INVERTINGINPUT2)
unnamed: C2.1, R2.1, U3.1 (OUTPUT1), U4.2 (INA-)
unnamed: C2.2, D2.1 (K), R2.2, U3.2 (INVERTINGINPUT1)
unnamed: C3.1, R3.1, U3.14 (OUTPUT4), U4.13 (IND-)
unnamed: C3.2, D3.1 (K), R3.2, U3.13 (INVERTINGINPUT4)
unnamed: C4.1, R4.1, U3.8 (OUTPUT3), U4.9 (INC-)
unnamed: C4.2, D4.1 (K), R4.2, U3.9 (INVERTINGINPUT3)
unnamed: R5.2, U4.7 (OUTB), U5.6 (S1)
unnamed: R6.1, U4.1 (OUTA), U5.4 (S0)
unnamed: R7.1, U4.14 (OUTD), U5.14 (S3)
unnamed: R8.2, U4.8 (OUTC), U5.12 (S2)
Reset: U5.3 (R0), U5.7 (R1), U5.11 (R2), U5.15 (R3)
S1: U5.9 (Q1)
S2: U5.2 (Q0)
S3: U5.1 (Q3)
S4: U5.10 (Q2)
TIA_VREF: C8.1, C9.1, C10.1, C11.1, U3.3 (NONINVERTINGINPUT1), U3.5 (NONINVERTINGINPUT2), U3.10 (NONINVERTINGINPUT3), U3.12 (NONINVERTINGINPUT4)
VDD_MCU: C5.1, C6.1, C7.1, U3.4 (VCC+), U4.4 (VDD), U5.5 (E), U5.16 (VDD)

Notes on the sheet:
Decouplig capacitor
LOGIC TABLE FOR SENSOR WIRING ORDER
