redfoxxxi/ET_MASTER_CODE/Additional unfinished Project/ET LASER SYSTEM/Sensor.kicad_sch

## KiCad design Additional unfinished Project/ET LASER SYSTEM/Sensor.kicad_sch (2026-09-12)

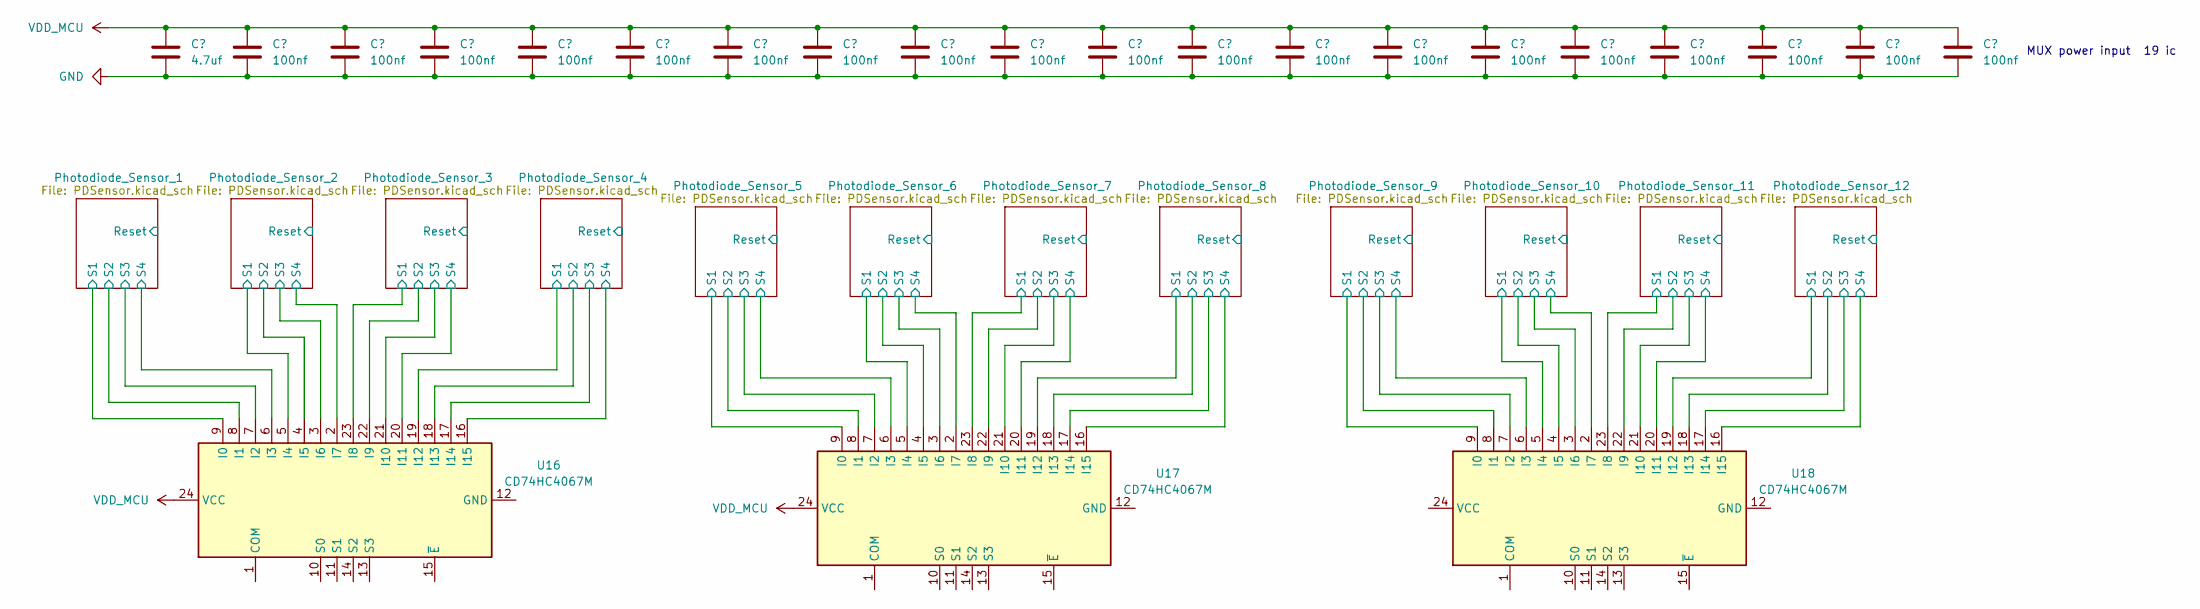
[picture p85: schematic Sensor.kicad_sch]

Parts:
U16, U17, U18: CD74HC4067M; SOIC-24W_7.5x15.4mm_P1.27mm

Connections:
S1: U16.5 (I4), U16.9 (I0), U16.19 (I12), U16.23 (I8), U17.5 (I4), U17.9 (I0), U17.19 (I12), U17.23 (I8), U18.5 (I4), U18.9 (I0), U18.19 (I12), U18.23 (I8)
S2: U16.4 (I5), U16.8 (I1), U16.18 (I13), U16.22 (I9), U17.4 (I5), U17.8 (I1), U17.18 (I13), U17.22 (I9), U18.4 (I5), U18.8 (I1), U18.18 (I13), U18.22 (I9)
S3: U16.3 (I6), U16.7 (I2), U16.17 (I14), U16.21 (I10), U17.3 (I6), U17.7 (I2), U17.17 (I14), U17.21 (I10), U18.3 (I6), U18.7 (I2), U18.17 (I14), U18.21 (I10)
S4: U16.2 (I7), U16.6 (I3), U16.16 (I15), U16.20 (I11), U17.2 (I7), U17.6 (I3), U17.16 (I15), U17.20 (I11), U18.2 (I7), U18.6 (I3), U18.16 (I15), U18.20 (I11)
VDD_MCU: U16.24 (VCC), U17.24 (VCC)

Notes on the sheet:
19 ic
MUX power input
