redfoxxxi/ET_MASTER_CODE/Additional unfinished Project/ET LASER SYSTEM/ET DATA CONVERTER/ET DATA CONVERTER.kicad_sch

## KiCad design Additional unfinished Project/ET LASER SYSTEM/ET DATA CONVERTER/ET DATA CONVERTER.kicad_sch (2026-09-12)

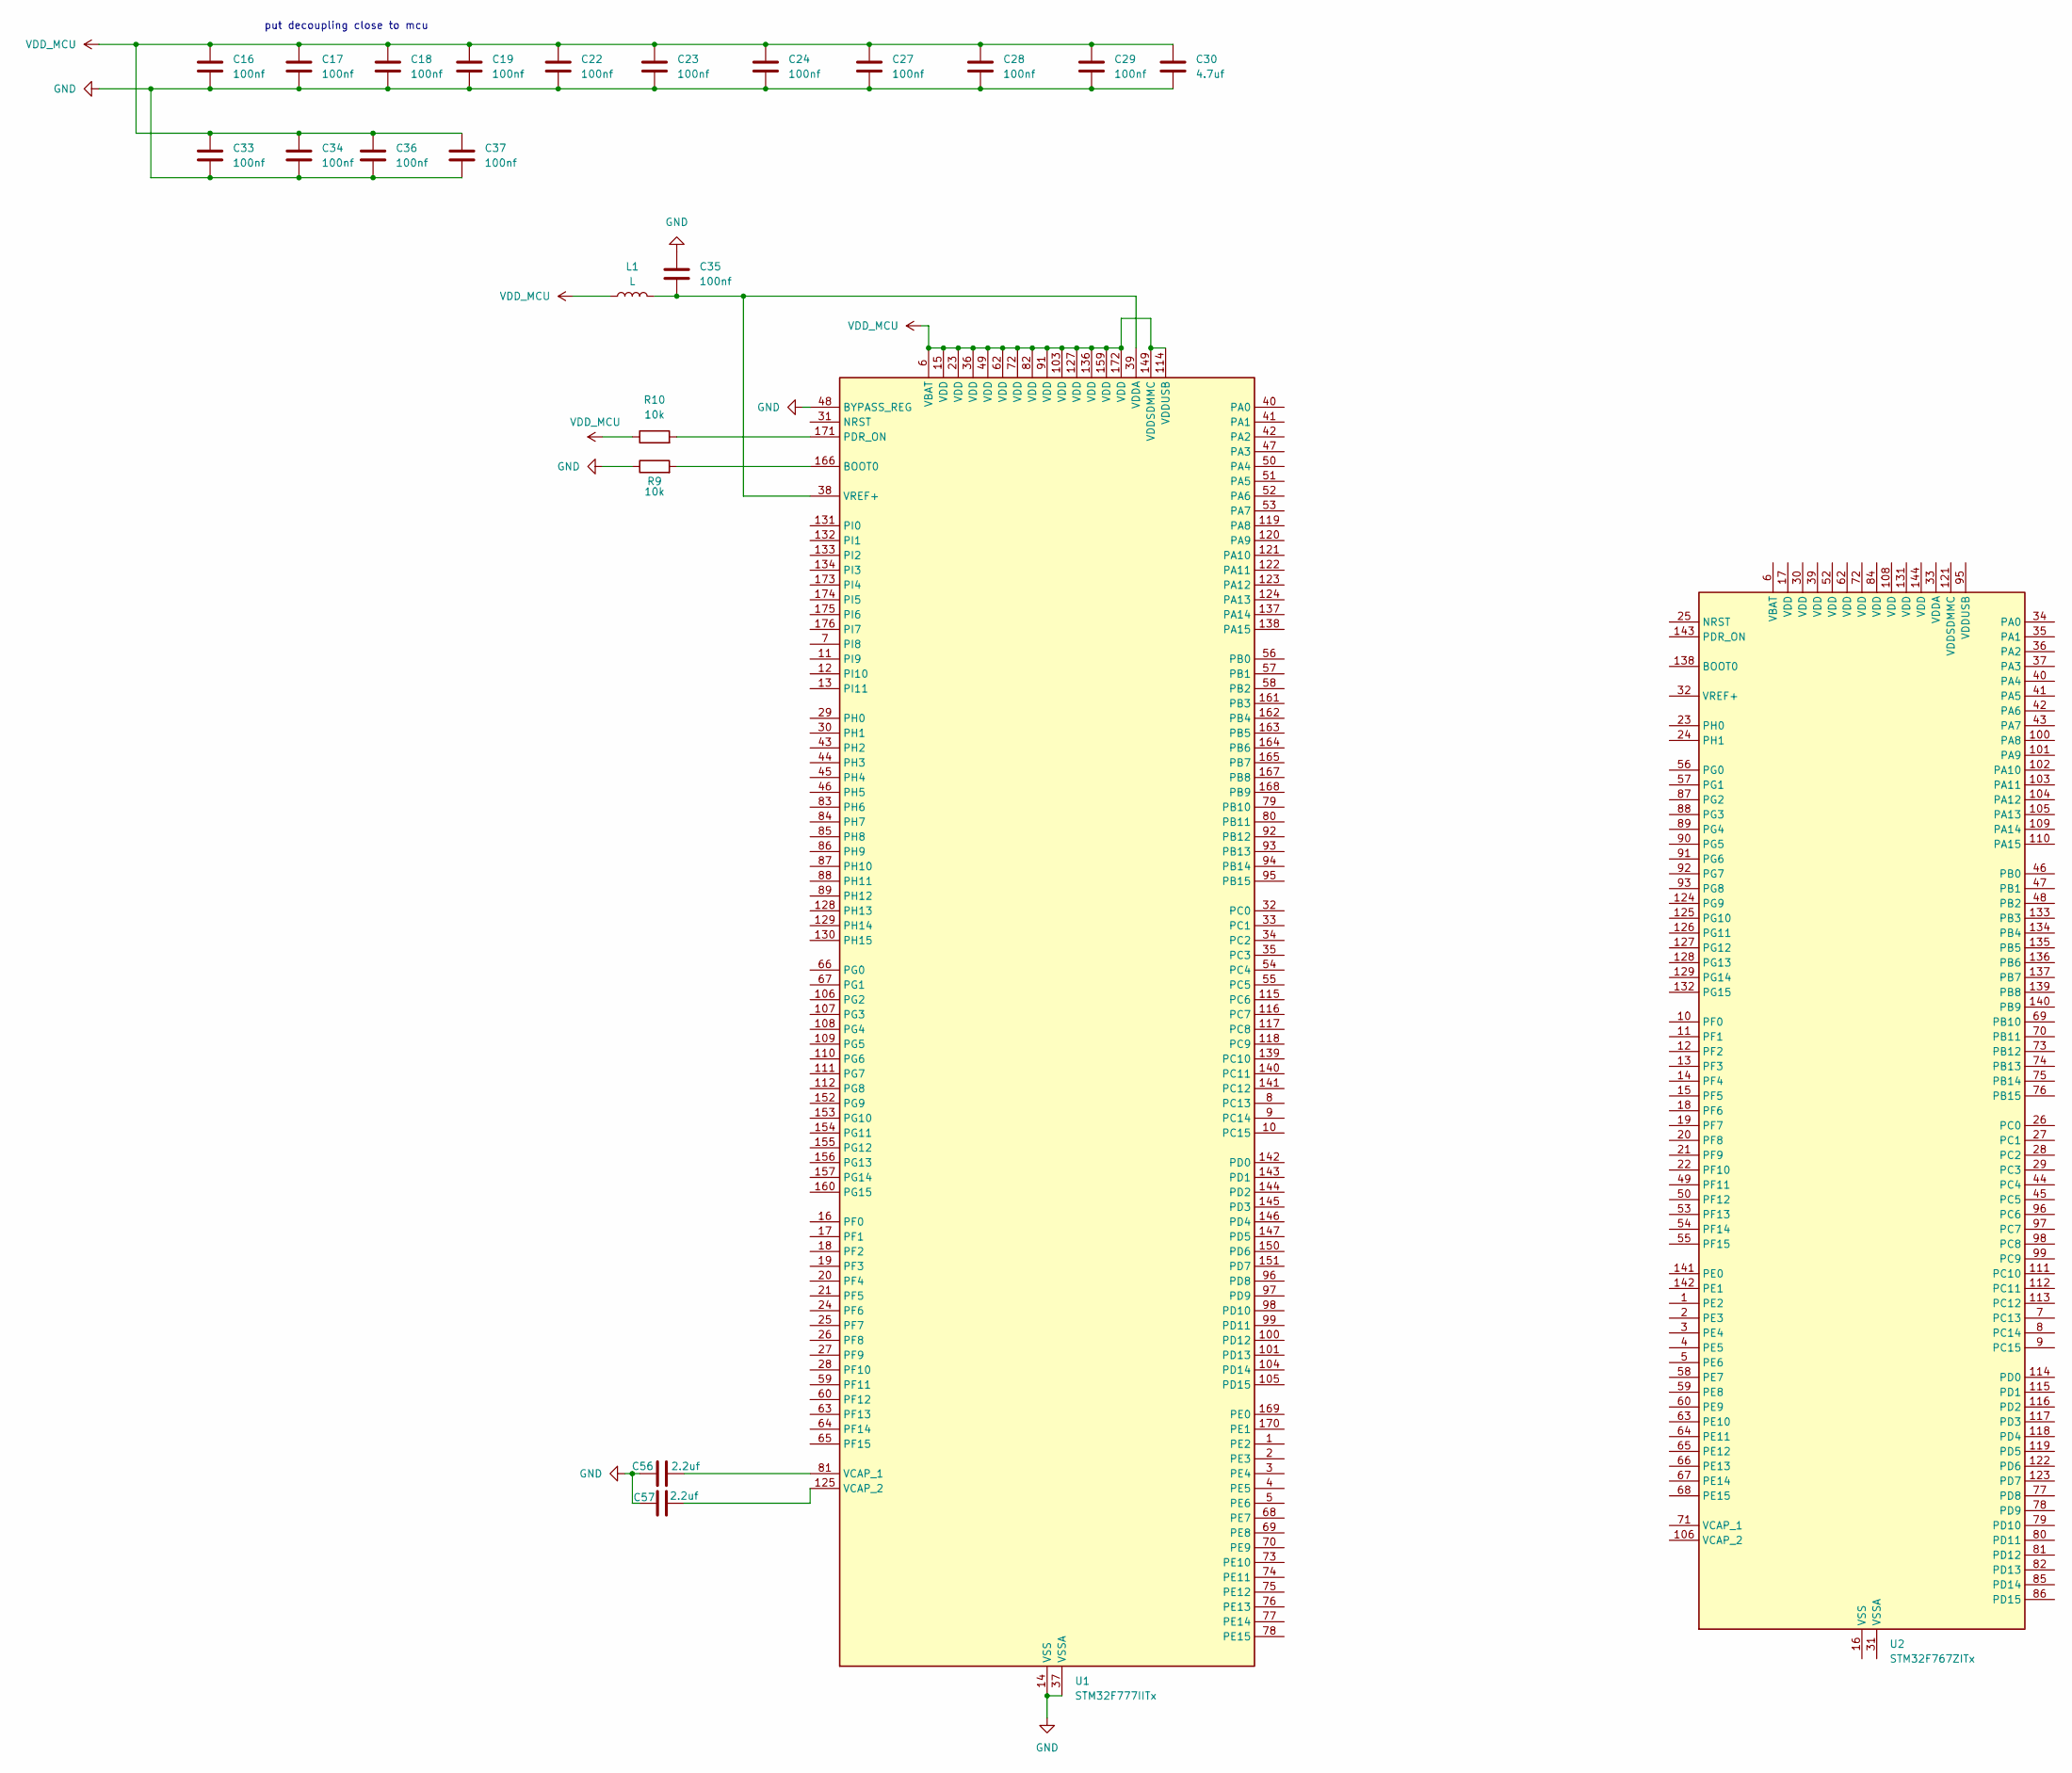
[picture p86: schematic ET DATA CONVERTER.kicad_sch]

Parts:
C16, C17, C18, C19, C22, C23, C24, C27, C28, C29, C33, C34, C35, C36, C37: 100nf; C_0603_1608Metric
C30: 4.7uf; C_1206_3216Metric
C56, C57: 2.2uf; C_0805_2012Metric
L1: L
R9, R10: 10k; R_0603_1608Metric
U1: STM32F777IITx; LQFP-176_24x24mm_P0.5mm
U2: STM32F767ZITx; LQFP-144_20x20mm_P0.5mm

Connections:
GND: C16.2, C17.2, C18.2, C19.2, C22.2, C23.2, C24.2, C27.2, C28.2, C29.2, C30.2, C33.2, C34.2, C35.1, C36.2, C37.2, C56.1, C57.1, R9.1, U1.14 (VSS), U1.22 (VSS), U1.37 (VSSA), U1.48 (BYPASS_REG), U1.61 (VSS), U1.71 (VSS), U1.90 (VSS), U1.102 (VSS), U1.113 (VSS), U1.126 (VSS), U1.135 (VSS), U1.148 (VSS), U1.158 (VSS)
unnamed: C35.2, L1.2, U1.38 (VREF+), U1.39 (VDDA)
unnamed: C56.2, U1.81 (VCAP_1)
unnamed: C57.2, U1.125 (VCAP_2)
unnamed: R9.2, U1.166 (BOOT0)
unnamed: R10.2, U1.171 (PDR_ON)
unnamed: U2.16 (VSS), U2.38 (VSS), U2.51 (VSS), U2.61 (VSS), U2.83 (VSS), U2.94 (VSS), U2.107 (VSS), U2.120 (VSS), U2.130 (VSS)
VDD_MCU: C16.1, C17.1, C18.1, C19.1, C22.1, C23.1, C24.1, C27.1, C28.1, C29.1, C30.1, C33.1, C34.1, C36.1, C37.1, L1.1, R10.1, U1.6 (VBAT), U1.15 (VDD), U1.23 (VDD), U1.36 (VDD), U1.49 (VDD), U1.62 (VDD), U1.72 (VDD), U1.82 (VDD), U1.91 (VDD), U1.103 (VDD), U1.114 (VDDUSB), U1.127 (VDD), U1.136 (VDD), U1.149 (VDDSDMMC), U1.159 (VDD), U1.172 (VDD)

Notes on the sheet:
put decoupling close to mcu
