redfoxxxi/ET_MASTER_CODE/Additional unfinished Project/ESP CAN CAN (added CAN interface )/Core/Src/main.c

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
/* Includes ------------------------------------------------------------------*/
#include "main.h"

/* USER CODE BEGIN Includes */
#include "stdio.h" // Required for printf
#include "string.h" // Required for memset (though less used now for number data)
/* USER CODE END Includes */

/* USER CODE BEGIN PD */
// Define GPIOs for debugging LEDs (adjust these based on your CubeMX setup)
#define LD1_GPIO_Port GPIOC
#define LD1_Pin GPIO_PIN_14 // Example: User LED 1
#define LD2_GPIO_Port GPIOC
#define LD2_Pin GPIO_PIN_15 // Example: User LED 2
#define LD_ERROR_GPIO_Port GPIOA
#define LD_ERROR_Pin GPIO_PIN_5 // Example: Onboard LED (Nucleo-G474RE has PA5)
/* USER CODE END PD */

FDCAN_HandleTypeDef hfdcan1;
FDCAN_HandleTypeDef hfdcan2;

TIM_HandleTypeDef htim1;

UART_HandleTypeDef huart2;

/* USER CODE BEGIN PV */
FDCAN_TxHeaderTypeDef TxHeader; // FDCAN Transmit Header structure
FDCAN_RxHeaderTypeDef RxHeader; // FDCAN Receive Header structure

uint8_t TxData[64]; // Transmit data buffer (max 64 bytes for CAN FD)
uint8_t RxData[64]; // Receive data buffer (max 64 bytes for CAN FD)

volatile uint32_t received_message_count = 0; // Counter for successfully received messages

// New global variables for buffering received message from ISR
volatile uint8_t new_message_received_flag = 0;
FDCAN_RxHeaderTypeDef Global_RxHeader;
uint8_t Global_RxData[64];
/* USER CODE END PV */

void SystemClock_Config(void);
static void MX_GPIO_Init(void);
static void MX_FDCAN1_Init(void);
static void MX_USART2_UART_Init(void);
static void MX_FDCAN2_Init(void);
static void MX_TIM1_Init(void);
/* USER CODE BEGIN PFP */
static void FDCAN2_Filter_Config(void); // Function to configure FDCAN2's message filter
void Error_Handler(void); // Custom error handler
/* USER CODE END PFP */

/* USER CODE BEGIN 0 */

/**
  * @brief Retargets the C library printf function to the UART.
  * @param file: file pointer
  * @param ptr: pointer to data buffer
  * @param len: length of data to be sent
  * @retval int: number of bytes sent
  */
int _write(int file, char *ptr, int len)
{
    HAL_UART_Transmit(&huart2, (uint8_t*)ptr, len, HAL_MAX_DELAY);
    return len;
}


#define SIG_GPIO_Port	GPIOB
#define SIG_Pin			GPIO_PIN_1
#define MUX3_GPIO_Port	GPIOB
#define MUX3_Pin		GPIO_PIN_10
#define MUX1_GPIO_Port	GPIOA
#define MUX1_Pin		GPIO_PIN_4
#define MUX2_GPIO_Port	GPIOB
#define MUX2_Pin		GPIO_PIN_4
#define MUX0_GPIO_Port	GPIOA
#define MUX0_Pin		GPIO_PIN_10
#define DRST_GPIO_Port	GPIOB
#define DRST_Pin		GPIO_PIN_0

void SetMuxChannel(uint8_t channel) {
  HAL_GPIO_WritePin(MUX0_GPIO_Port, MUX0_Pin, (channel & 0x01) ? GPIO_PIN_SET : GPIO_PIN_RESET);
  HAL_GPIO_WritePin(MUX1_GPIO_Port, MUX1_Pin, (channel & 0x02) ? GPIO_PIN_SET : GPIO_PIN_RESET);
  HAL_GPIO_WritePin(MUX2_GPIO_Port, MUX2_Pin, (channel & 0x04) ? GPIO_PIN_SET : GPIO_PIN_RESET);
  HAL_GPIO_WritePin(MUX3_GPIO_Port, MUX3_Pin, (channel & 0x08) ? GPIO_PIN_SET : GPIO_PIN_RESET);
}

/* USER CODE END 0 */

/**
  * @brief  The application entry point.
  * @retval int
  */
int main(void)
{

  /* MCU Configuration--------------------------------------------------------*/

  /* Reset of all peripherals, Initializes the Flash interface and the Systick. */
  HAL_Init();

  /* Configure the system clock */
  SystemClock_Config();

  /* Initialize all configured peripherals */
  MX_GPIO_Init();
  MX_FDCAN1_Init();
  MX_USART2_UART_Init();
  MX_FDCAN2_Init();
  MX_TIM1_Init();
  /* USER CODE BEGIN 2 */

    printf("FDCAN Inter-Communication Test Started!\r\n");

    // Configure FDCAN2 filter to accept messages from FDCAN1's ID (0x123)
    // IMPORTANT: Filters must be configured AFTER HAL_FDCAN_Init() but BEFORE HAL_FDCAN_Start()
    FDCAN2_Filter_Config();
    printf("FDCAN2 Filter Configured.\r\n");

    // Start FDCAN peripherals
    if (HAL_FDCAN_Start(&hfdcan1) != HAL_OK)
    {
        printf("Error: FDCAN1 Start failed!\r\n");
        Error_Handler();
    }
    printf("FDCAN1 Started.\r\n");

    if (HAL_FDCAN_Start(&hfdcan2) != HAL_OK)
    {
        printf("Error: FDCAN2 Start failed!\r\n");
        Error_Handler();
    }
    printf("FDCAN2 Started.\r\n");

    // Activate FDCAN2 Rx FIFO 0 New Message Interrupt
    if (HAL_FDCAN_ActivateNotification(&hfdcan2, FDCAN_IT_RX_FIFO0_NEW_MESSAGE, 0) != HAL_OK)
    {
        printf("Error: FDCAN2 Rx FIFO 0 Notification Activation failed!\r\n");
        Error_Handler();
    }
    printf("FDCAN2 Rx FIFO 0 Notification Activated.\r\n");

    // --- Prepare Tx Header for FDCAN1 ---
    TxHeader.Identifier = 0x123;           // Standard ID for FDCAN1 messages
    TxHeader.IdType = FDCAN_STANDARD_ID;   // 11-bit ID
    TxHeader.TxFrameType = FDCAN_DATA_FRAME; // Data Frame
    // Set DataLength back to 8 bytes for numerical data
    TxHeader.DataLength = FDCAN_DLC_BYTES_8;
    TxHeader.BitRateSwitch = FDCAN_BRS_ON; // Enable Bit Rate Switching for data phase
    TxHeader.FDFormat = FDCAN_FD_CAN;     // CAN FD format
    TxHeader.TxEventFifoControl = FDCAN_STORE_TX_EVENTS; // Optional: Store Tx events
    TxHeader.MessageMarker = 0;            // Optional: Message marker

    // Initialize TxData[0] for incrementing number
    TxData[0] = 0;
    // Clear the rest of the TxData buffer to ensure clean transmission
    memset(&TxData[1], 0, sizeof(TxData) - 1);
    printf("FDCAN1 Tx Header and initial Data prepared with a number.\r\n");


    HAL_TIM_PWM_Start(&htim1, TIM_CHANNEL_1);
    HAL_GPIO_WritePin(DRST_GPIO_Port, DRST_Pin, GPIO_PIN_RESET);
  /* USER CODE END 2 */

  /* Infinite loop */
  /* USER CODE BEGIN WHILE */
    while (1)
    {
        // --- Transmit message from FDCAN1 ---
        if (HAL_FDCAN_AddMessageToTxFifoQ(&hfdcan1, &TxHeader, TxData) != HAL_OK)
        {
            printf("Error: FDCAN1 Message Transmission failed!\r\n");
            // Check FDCAN error status registers for more details if this error persists
            // For example, you can check hfdcan1.ErrorCode or FDCAN1->PSR (Protocol Status Register)
            Error_Handler();
        }
        else
        {
            // Print the first byte of data for confirmation
            printf("FDCAN1 Transmitted ID: 0x%X, Data[0]: %d\r\n", (unsigned int)TxHeader.Identifier, TxData[0]);
        }

        // Increment first byte of TxData for next transmission to show change
        TxData[0]++;
        if (TxData[0] > 0xFF) TxData[0] = 0; // Wrap around

        // --- Process Received Message in main loop (from ISR) ---
        if (new_message_received_flag == 1)
        {
            printf("FDCAN2 Received Message #%lu:\r\n", received_message_count);
            printf("  ID: 0x%X, DLC: %d, FDFormat: %s, BRS: %s\r\n",
                   (unsigned int)Global_RxHeader.Identifier,
                   (int)Global_RxHeader.DataLength,
                   (Global_RxHeader.FDFormat == FDCAN_FD_CAN) ? "CAN FD" : "Classic CAN",
                   (Global_RxHeader.BitRateSwitch == FDCAN_BRS_ON) ? "ON" : "OFF");
            // Print received data[0] as an integer
            printf("  Data[0]: %d\r\n", Global_RxData[0]);

            // Example: Toggle an LED based on the received data (e.g., if the first byte is even)
            if (Global_RxData[0] % 2 == 0)
            {
                HAL_GPIO_TogglePin(LD1_GPIO_Port, LD1_Pin); // Toggle LD1 for even data[0]
            }
            else
            {
                HAL_GPIO_TogglePin(LD2_GPIO_Port, LD2_Pin); // Toggle LD2 for odd data[0]
            }

            new_message_received_flag = 0; // Clear the flag after processing
        }


        // Small delay between transmissions
        //HAL_Delay(500); // Transmit every 500ms

    /* USER CODE END WHILE */

    /* USER CODE BEGIN 3 */
        SetMuxChannel(6);

        	GPIO_PinState data = HAL_GPIO_ReadPin(SIG_GPIO_Port, SIG_Pin);

        	if (data == GPIO_PIN_SET){

        		HAL_GPIO_WritePin(GPIOA, GPIO_PIN_9, GPIO_PIN_SET);
        		HAL_Delay(2500);
        		HAL_GPIO_WritePin(DRST_GPIO_Port, DRST_Pin, GPIO_PIN_SET);
        		HAL_Delay(2500);
        		HAL_GPIO_WritePin(GPIOA, GPIO_PIN_9, GPIO_PIN_RESET);
        		HAL_GPIO_WritePin(DRST_GPIO_Port, DRST_Pin, GPIO_PIN_RESET);
        	}
    }
  /* USER CODE END 3 */
}

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
/* USER CODE BEGIN 4 */

/**
  * @brief Configures the FDCAN2 message filter.
  * This filter is set to accept standard ID 0x123.
  * @param None
  * @retval None
  */
static void FDCAN2_Filter_Config(void)
{
    FDCAN_FilterTypeDef sFilterConfig;

    sFilterConfig.IdType = FDCAN_STANDARD_ID;             // Filter for 11-bit standard IDs
    sFilterConfig.FilterIndex = 0;                        // Use the first filter element
    sFilterConfig.FilterType = FDCAN_FILTER_MASK;         // Mask filter mode
    sFilterConfig.FilterConfig = FDCAN_FILTER_TO_RXFIFO0; // Route accepted messages to Rx FIFO 0
    sFilterConfig.FilterID1 = 0x123;                      // Filter ID: accept messages with ID 0x123
    sFilterConfig.FilterID2 = 0x7FF;                      // Filter Mask: all bits must match (0x7FF for standard ID)


    // Configure FDCAN2 filter
    if (HAL_FDCAN_ConfigFilter(&hfdcan2, &sFilterConfig) != HAL_OK)
    {
        printf("Error: FDCAN2 Filter Configuration failed!\r\n");
        Error_Handler();
    }

    // Configure global filter to accept all non-matching standard/extended messages into Rx FIFO 0/1,
    // and reject remote frames.
    if (HAL_FDCAN_ConfigGlobalFilter(&hfdcan2, FDCAN_ACCEPT_IN_RX_FIFO0, FDCAN_ACCEPT_IN_RX_FIFO1, FDCAN_REJECT_REMOTE, FDCAN_REJECT_REMOTE) != HAL_OK)
    {
        printf("Error: FDCAN2 Global Filter Configuration failed!\r\n");
        Error_Handler();
    }
}

/**
  * @brief  Rx FIFO 0 Callback Function.
  * This function is called when a new message is received in Rx FIFO 0.
  * @param  hfdcan: FDCAN handle
  * @param  RxFifo0ITs: RxFifo0 Interrupt flags
  * @retval None
  */
void HAL_FDCAN_RxFifo0Callback(FDCAN_HandleTypeDef *hfdcan, uint32_t RxFifo0ITs)
{
    // Check if the interrupt is for a new message in Rx FIFO 0
    if ((RxFifo0ITs & FDCAN_IT_RX_FIFO0_NEW_MESSAGE) != RESET)
    {
        // Ensure this callback is for FDCAN2
        if (hfdcan->Instance == FDCAN2)
        {
            // Retrieve message from Rx FIFO 0
            // Store it in global variables to be processed in the main loop
            if (HAL_FDCAN_GetRxMessage(hfdcan, FDCAN_RX_FIFO0, &Global_RxHeader, Global_RxData) != HAL_OK)
            {
                // In an ISR, avoid printf. Just set error flag or toggle LED if critical.
                Error_Handler(); // Keep this for now, but ideally this would be a very minimal error indication.
            }
            else
            {
                received_message_count++; // Increment counter
                new_message_received_flag = 1; // Set flag to process in main loop
            }

            // Re-activate the notification for the next message
            if (HAL_FDCAN_ActivateNotification(hfdcan, FDCAN_IT_RX_FIFO0_NEW_MESSAGE, 0) != HAL_OK)
            {
                Error_Handler(); // Again, ideally very minimal in ISR.
            }
        }
    }
}

/* USER CODE END 4 */
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
