redfoxxxi/ET_MASTER_CODE/Additional unfinished Project/ESP CAN CAN (added CAN interface )/ESP CAN CAN.ioc

Mcu.UserName=STM32G474RETx
PA10.Signal=GPIO_Output
PA11.Signal=FDCAN1_RX
PA12.Signal=FDCAN1_TX
PA13.Signal=SYS_JTMS-SWDIO
PA14.Signal=SYS_JTCK-SWCLK
PA2.Signal=USART2_TX
PA3.Signal=USART2_RX
PA4.Signal=GPIO_Output
PA8.Signal=S_TIM1_CH1
PA9.Signal=GPIO_Output
PB0.Signal=GPIO_Output
PB1.Signal=GPIO_Input
PB10.Signal=GPIO_Output
PB3.Signal=SYS_JTDO-SWO
PB4.Signal=GPIO_Output
PB5.Signal=FDCAN2_RX
PB6.Signal=FDCAN2_TX
PC13.Signal=GPXTI13
PF0-OSC_IN.Signal=RCC_OSC_IN
PF1-OSC_OUT.Signal=RCC_OSC_OUT
