redfoxxxi/ET_MASTER_CODE/(notices)

Notices in the files:
Additional unfinished Project/ESP CAN CAN (added CAN interface )/Core/Src/main.c:
Copyright (c) 2025 STMicroelectronics.
All rights reserved.
This software is licensed under terms that can be found in the LICENSE file
